wudi-tech/esp32-p4-c5-webrtc-doorbell/output/acrylic/README.md

# Acrylic Backplate Final Production Package V3

## Vendor cutting instructions / 加工说明

- Primary production file: `acrylic_plate_cut_only_v3.dxf`
- Layered engineering file: `acrylic_plate_layered_v3.dxf`
- Units: mm
- Scale: 1:1
- Finished size: 220.00 x 190.00 x 5.00 mm
- Material: transparent clear cast PMMA / 透明浇铸亚克力
- Four external corners: R10.00
- Outline tolerance: +/-0.20 mm
- Hole and cutout tolerance: +/-0.10 mm
- Process: CNC or laser cutting
- Deburr every hole and edge; retain protective film for delivery.
- Do not scale, fit to page, mirror, or manually estimate geometry.
- ALL MACHINING COORDINATES ARE DEFINED FROM FRONT VIEW.
- DO NOT MIRROR CUTTING GEOMETRY.

## Machining summary / 加工特征

- 4x corner-support holes, diameter 3.20 mm.
- 4x mainboard holes, diameter 3.20 mm.
- 2x LD2450 diagonal-notch clamp holes, diameter 2.20 mm.
- 4x rear power-board holes, diameter 2.20 mm.
- 1x rounded rectangular cable pass-through, 32.00 x 18.00 mm, R3.00.
- Camera, 3525 speaker, and MG90S servo have no acrylic cutting holes.

## Assembly notes / 装配说明

- Mainboard: 4x M3, 8 mm brass standoffs, insulating washers.
- Camera: thin double-sided tape; keep CSI flex straight; lens centre approximately
  50 mm below the mainboard edge. Camera dimensions are photo-scale estimates and
  do not control cutting geometry.
- LD2450: 15 x 44 mm vertical, notch end upward, antenna face toward the user;
  clamp at the two official R1.1 diagonal notch centres using M2 standoffs and
  nylon washers with 0.5-0.8 mm overlap.
- 3525 speaker: 4 ohm / 3 W, fixed with 1 mm EVA double-sided tape.
- MG90S: fixed with hot glue; output shaft normal to the plate and facing outward.
- Power board: 4x M2, 10 mm brass standoffs, components facing rear-out.

## Package files

- `acrylic_plate_cut_only_v3.dxf` - authoritative cut-only geometry
- `acrylic_plate_layered_v3.dxf` - CUT/REFERENCE/TEXT/DIMENSION layers
- `acrylic_plate_manufacturing_drawing_v3.pdf` - four-page engineering drawing
- `acrylic_plate_front_assembly_v3.svg` - front assembly reference
- `acrylic_plate_rear_assembly_v3.svg` - rear assembly reference
- `acrylic_plate_hole_table_v3.csv` - machining coordinate table
