wudi-tech/esp32-p4-c5-webrtc-doorbell/docs/code-walkthrough/00_从这里开始_索引.md

# 从这里开始：ESP32-P4+C5 门铃 — 代码结构讲解资料索引

生成时间：2026-09-16  
对应项目：WT99P4C5-S1 本地 WebRTC 智能门铃（ESP-IDF v5.5.5，目标 ESP32-P4）  
资料性质：作者自用的"从 0 讲清代码结构"手册 + 分层技术分析底稿（**只读分析产物，未修改任何源码**）

---

## 一、这个文件夹里有什么

| 文件 | 大小 | 用途 | 建议阅读顺序 |
| --- | --- | --- | --- |
| `10_代码结构从0讲清.md` | 约 90 KB / 1169 行 | **主手册**。分层地图、启动流程、五条核心业务链路、逐模块精读、配置层、测试体系、汇报速查、30 个评委追问答案、9 处代码/文档不一致与安全边界自查清单 | ① 先读这个 |
| `11_代码录屏讲解脚本_20分钟版.md` | 约 39 KB / 439 行 | **20 分钟录屏逐句台词**。10 段分镜，每段含画面动作、逐句台词、评委验收点；附成片验收清单、容易讲错的 12 句对照表、20→10 分钟删减方案、现场问答速答表 | ② 录制前通读 |
| `03_代码录屏讲解脚本.md` | 约 28 KB | 旧版 10 分钟逐句脚本（若赛事时长只允许 10 分钟则用这份；数字已同步为 14 项检查） | 视时长选用 |
| `_analysis/webrtc_layer.md` | 约 52 KB | 底稿：WebRTC 会话层（回调表、信令实现、状态机、锁与并发、端到端时序） | ③ 查细节 |
| `_analysis/media_audio.md` | 约 63 KB | 底稿：媒体系统与音频链路（采集/编码/播放、提示音预解码、板级 ES8311、风险清单） | ③ 查细节 |
| `_analysis/perception_actuator.md` | 约 73 KB | 底稿：LD2450 雷达、视觉检测与跟踪、多模态融合、舵机门锁（含全部阈值常量） | ③ 查细节 |
| `_analysis/signaling_webui.md` | 约 71 KB | 底稿：HTTPS 信令服务、SSE 三条队列语义、POST 协议、中文网页结构与安全边界 | ③ 查细节 |

主手册里的每条结论都能在底稿里找到对应的 `文件:行号` 证据；讲解脚本的行号与主手册使用同一份快照基准（2026-09-16）。

**自动检查现状（2026-09-16 实跑）**：`tests` 目录下 13 个 C 单元测试文件已**全部**被 14 个 `verify_*.py` 入口编译执行，实测 `VERIFY_TOTAL=14 / VERIFY_FAILED=0`。本次新增了两个入口：`verify_pcm_overlay.py`（提示音混音与限幅）与 `verify_pedestrian_filter.py`（整幅满屏框假阳性过滤）。

---

## 二、三件必须先知道的事（详见主手册第 6.4 节、第 13 章）

1. **开门语音在默认构建下大概率不会响。** 提示音混音要求 16000 Hz，而默认通话音频是 G711A 8000 Hz；混音分支和静音兜底线程都不会输出，且函数仍返回 0，串口不报错。实测日志为证：通话中渲染器打开的是 8000 Hz。演示前请先实机复测，或选择一种修法（启用 OPUS / 把 `open.aac` 预处理目标改成 8 kHz）。
2. **没有"中文语音提示"。** 三段提示音是预录 AAC，开门台词是英文 "Doors open, come in please"；中文只存在于网页 UI。
3. **`doorbell_status.c` 与 `PEDESTRIAN_DETECTED` 是未接线/死代码**，网页状态实际来自 SSE 的 `vision_state` / `radar_event`；另外开门命令当前无鉴权、TLS 为示例自签名证书（2028-10-14 到期）。这些属于"可信局域网 Demo"级安全边界，建议主动声明。

---

## 三、资料从哪里来（源项目 + 原件位置）

源项目（提交源码快照）：

```text
D:\Documents\ChatGPT\WebRTC复刻挑战\output\submission\ESP32-P4-C5_WebRTC_Doorbell_2026-09-14\02_项目完整源码\
```

原件（本文件夹是它们的副本，原件仍然存在）：

```text
…\02_项目完整源码\docs\submission\10_代码结构从0讲清.md
…\02_项目完整源码\docs\submission\11_代码录屏讲解脚本_20分钟版.md
…\02_项目完整源码\docs\submission\_analysis\webrtc_layer.md
…\02_项目完整源码\docs\submission\_analysis\media_audio.md
…\02_项目完整源码\docs\submission\_analysis\perception_actuator.md
…\02_项目完整源码\docs\submission\_analysis\signaling_webui.md
```

---

## 四、如何放回项目（可选）

如果希望手册跟着源码一起提交，把两个条目复制回项目的 `docs\submission\` 即可：

```powershell
$src = 'D:\Documents\ChatGPT\WebRTC复刻挑战\output\ESP32-P4-C5门铃_代码结构讲解'
$dst = 'D:\Documents\ChatGPT\WebRTC复刻挑战\output\submission\ESP32-P4-C5_WebRTC_Doorbell_2026-09-14\02_项目完整源码\docs\submission'
Copy-Item (Join-Path $src '10_代码结构从0讲清.md') $dst -Force
Copy-Item (Join-Path $src '11_代码录屏讲解脚本_20分钟版.md') $dst -Force
Copy-Item (Join-Path $src '_analysis') $dst -Recurse -Force
```

同时建议在 `docs\submission\README.md` 的交付清单里保留这三项：

| 编号 | 材料 | 文件/目录 |
| --- | --- | --- |
| 10 | 代码结构自学手册 | `10_代码结构从0讲清.md` |
| 11 | 代码录屏讲解脚本（20 分钟） | `11_代码录屏讲解脚本_20分钟版.md` |
| — | 分层技术分析底稿（4 篇） | `_analysis/*.md` |

> 若不希望提交底稿，只保留 `10_代码结构从0讲清.md` 也完整可用——手册本身已包含全部结论与关键行号。

---

## 五、阅读建议

- **只有 20 分钟**：主手册第 1 章（5 个心智模型）→ 第 3 章（分层地图）→ 第 11.1 节（一分钟总述）→ 第 13 章（自查清单）。
- **准备录讲解视频**：主手册第 5、6 章 + 既有的 `03_代码录屏讲解脚本.md`（那份是逐句台词，本手册是"为什么这样写"）。
- **准备答辩**：主手册第 12 章（30 个追问的答法）+ 第 13 章（主动交代的 9 处不一致与安全边界）。
