wudi-tech/esp32-p4-c5-webrtc-doorbell/docs/submission/README.md

# ESP32-P4+C5 多模态 WebRTC 智能门铃——提交材料索引

版本日期：2026-09-14  
作品状态：主要功能已完成实机验证，进入提交材料制作阶段。

## 交付内容

| 编号 | 材料 | 文件/目录 | 状态 |
| --- | --- | --- | --- |
| 01 | 可完整运行的作品 | 已烧录的 WT99P4C5-S1 实机；发布包中的 P4 固件 | 已完成 |
| 02 | 项目完整源码 | 发布包中的 `source/esp-webrtc-solution` | 已准备 |
| 03 | 开发日志 | `01_开发日志.md` | 已准备 |
| 04 | 使用指南 | `02_使用指南.md` | 已准备 |
| 05 | 代码录屏讲解 | `03_代码录屏讲解脚本.md` | 待参赛者录制 |
| 06 | 横屏项目演示 | `04_项目使用流程演示脚本.md` | 待参赛者录制 |
| 07 | 复刻过程加分视频 | `05_复刻过程加分视频脚本.md` | 可选，建议录制 |
| 08 | 提交前检查 | `06_最终提交检查表.md` | 提交前逐项确认 |
| 09 | 源码完备性审计 | `09_提交源码完备性审计.md` | 已准备 |
| 10 | **代码结构自学手册** | `10_代码结构从0讲清.md` | 已准备（作者自用） |
| 11 | **代码录屏讲解脚本·20 分钟版** | `11_代码录屏讲解脚本_20分钟版.md` | 已准备（替代 03 的逐句加强版） |
| — | 分层技术分析底稿（4 篇） | `_analysis/webrtc_layer.md`、`_analysis/media_audio.md`、`_analysis/perception_actuator.md`、`_analysis/signaling_webui.md` | 已准备（手册的证据底稿） |

> `10_代码结构从0讲清.md` 是写给作者本人的"从 0 理解代码"手册：分层地图、启动流程、五条核心业务链路、逐模块要点、配置层、测试体系、汇报速查、30 个可能被追问的问题，以及**9 处代码/文档不一致与安全边界的自查清单**。建议在录制讲解视频前通读一遍。
>
> `11_代码录屏讲解脚本_20分钟版.md` 是 20 分钟录屏的逐句台词版（10 段分镜、每段含画面动作与评委验收点、末尾附 10 分钟删减方案与"容易讲错的 12 句"对照表）。旧版 10 分钟的 `03_代码录屏讲解脚本.md` 仍保留，可按赛事时长要求选用。

## 作品一句话介绍

本作品在 WT99P4C5-S1（ESP32-P4 + ESP32-C5）开发板上实现了局域网 WebRTC 智能门铃：支持板端摄像头到浏览器实时视频、双向音频、BOOT 实体按键呼叫、浏览器接听/挂断、舵机模拟开锁及语音提示、LD2450 雷达人员接近检测、摄像头人体/人脸存在辅助检测和中文网页状态展示。

## 真实性边界

- 舵机当前用于模拟门锁动作，尚未连接真实门锁机构。
- 摄像头只判断是否有人并显示检测框与置信度，不进行身份识别。
- LD2450 输出最多三个目标的二维坐标、速度和进入/离开事件，不是三维点云雷达。
- 配套显示屏尚未集成到最终门铃 UI，代码保留了未来扩展接口。
- 当前实现面向同一局域网内的单浏览器客户端。

## 建议提交目录命名

```text
ESP32-P4+C5多模态WebRTC智能门铃_最终提交/
├─ 01_可运行固件/
├─ 02_项目完整源码.zip
├─ 03_开发日志.pdf（或 .md）
├─ 04_使用指南.pdf（或 .md）
├─ 05_代码录屏讲解.mp4
├─ 06_项目使用流程演示.mp4
├─ 07_复刻过程记录_加分项.mp4
└─ 08_提交说明与文件校验.txt
```
