wudi-tech/esp32-p4-c5-webrtc-doorbell/docs/superpowers/specs/2026-09-10-hybrid-person-detection-design.md

# ESP32-P4 门铃组合人员检测设计

日期：2026-09-10

目标硬件：WT99P4C5-S1（ESP32-P4）+ OV5647 + HLK-LD2450

实现范围：行人检测、人脸检测、雷达融合、浏览器中文状态与检测框

## 1. 目标

在不进行人脸身份识别的前提下，提高门铃近距离场景中的“是否有人”判断可靠性。系统同时覆盖完整人体和近距离头肩画面，在网页上如实显示检测来源、检测框和模型分数，并继续使用雷达作为自动来电的必要条件。

本设计必须优先保证现有 WebRTC 音视频、门铃响铃、开门和挂断流程不被 AI 推理阻塞。

## 2. 非目标与未来扩展

本轮不实现：

- 人脸身份注册、特征提取、身份比对或人脸数据库；
- 人脸照片或特征的持久化存储；
- 独立的上半身专用模型；
- 配套显示屏初始化和界面；
- 雷达目标与视频目标的一一空间标定；
- 将模型分数解释为真实世界概率。

未来可在统一视觉结果接口后增加人脸身份识别。显示屏可订阅统一门铃状态接口，不直接依赖浏览器页面或 WebRTC 信令。

## 3. 总体架构

保留现有 320×180 RGB565、2 FPS 的独立检测支路。检测支路只消费最新画面，不能阻塞主视频采集。

检测链路由以下独立单元组成：

1. **画面采集与格式确认**：沿用现有检测 sink、缓存同步和像素格式探测。
2. **运动唤醒**：画面运动只用于调度 AI，不能作为“有人”的正证据。
3. **行人检测适配器**：包装现有 `PedestrianDetect`，输出统一视觉候选。
4. **人脸检测适配器**：使用支持 ESP32-P4 的 `HumanFaceDetect`，输出统一视觉候选。
5. **视觉轨迹过滤器**：按检测类型维护短期轨迹、分数、框位置、命中与丢失次数。
6. **视觉状态融合器**：将已确认的行人或人脸候选转换为“摄像头确认有人”。
7. **多模态融合器**：只有雷达门前区域存在符合条件的目标且视觉已确认时，才允许自动来电。
8. **遥测与网页覆盖层**：实时状态覆盖更新，状态转变才写入事件历史。

通话、门锁、音频和 BOOT 手动来电逻辑保持独立。AI 模块异常不能导致这些基础功能退出。

## 4. 统一视觉结果

每个视觉目标至少包含：

- 临时轨迹编号；
- 类型：`pedestrian` 或 `face`；
- 原始模型分数，范围 0.0 至 1.0；
- 检测框左上角、宽度和高度；
- 原始检测画面宽高；
- 候选或已确认状态；
- 单调时间戳；
- 连续命中和连续丢失计数。

轨迹编号只在当前运行和短期跟踪中有效，不表示人员身份。系统最多向网页报告三个视觉目标。

行人框包含人脸框时，两个框可以同时显示，但综合人员数量只计算一个。仅靠现有摄像头和 LD2450 不建立雷达目标与视频框的一一对应关系。

## 5. 模型调度

默认采用“行人优先、人脸补充”的级联策略：

1. 每个检测帧先运行行人模型。
2. 行人模型得到可靠结果时，本帧可跳过人脸模型。
3. 行人模型无结果、分数不足或框不合理时，在同一帧运行人脸模型。
4. 雷达已在门前区域发现目标时，允许同帧运行两个模型，以缩短近距离确认时间。
5. AI 任务优先级低于 WebRTC 音频、视频编码和网络任务。
6. 推理赶不上输入时丢弃旧帧，只处理最新帧。
7. 通话期间若连续三次单帧 AI 处理耗时超过 450 ms，或五秒内发生两次检测帧覆盖，检测频率从 2 FPS 降为 1 FPS；连续三十次处理耗时低于 350 ms 且没有检测帧覆盖后恢复到 2 FPS。
8. 模型对象和主要工作缓冲区在启动阶段分配，避免通话中频繁分配大块内存。

初始运行参数：

- 行人最低候选分数：0.70；
- 人脸最低候选分数：0.75；
- 视觉确认：最近四次对应模型结果中至少三次有效；
- 视觉取消：连续三次未检测到；
- 雷达与视觉有效重叠保持时间：2000 ms；
- 浏览器视觉状态过期时间：3000 ms。

这些是首版可配置参数。实机调优只改变参数，不改变数据流和模块边界。

## 6. 视觉确认与多模态融合

行人或人脸达到连续帧规则后，视觉状态变为“已确认有人”。单帧高分结果仍然只是候选。

自动来电条件为：

1. LD2450 已确认目标进入门前区域；
2. 本次访问具备响铃资格且未响铃；
3. 行人检测或人脸检测已确认；
4. 视觉结果仍在 2000 ms 有效期内。

运动检测不能直接调用人员确认回调。雷达没有目标时，即使摄像头误把照片识别为人脸，也不能自动来电。

雷达确认人员离开后，清除本次访问的融合资格、视觉保持状态和已响铃标记。雷达短暂丢帧不能立刻清除已确认视觉结果。

## 7. 模型分数的含义

网页将模型返回的 0.86 显示为“人脸 86%”。它只表示当前检测框与该模型训练目标的匹配分数，不表示：

- 门外真实存在人员的概率；
- 人体出现在画面中的比例；
- 身份识别准确率；
- 雷达与摄像头的综合概率。

行人分数和人脸分数来自不同模型，不进行简单平均。综合状态通过确定性的规则表达为“候选”“已确认”或“未确认”。

“近距离”由雷达距离表示，不由人脸模型推断。因此界面使用“人脸 86%”，不使用“近距离人员 86%”。

## 8. 浏览器界面与事件语义

远端视频上叠加透明绘制层：

- 绿色实线：已确认行人；
- 黄色实线：已确认人脸；
- 灰色虚线：尚未确认的候选；
- 标签显示“行人 81%”或“人脸 86%”。

覆盖层根据原始检测画面宽高、视频实际显示区域和 `object-fit` 留白计算坐标。窗口缩放、全屏和移动端方向变化不能导致检测框明显偏移。

中文实时状态区域至少显示：

- 人员状态；
- 视觉依据和模型分数；
- 连续确认状态；
- 雷达是否存在门前目标及其距离；
- 行人和人脸模型运行状态；
- 正常、降级或不可用状态。

设备通过独立 `vision_state` JSON 消息发送最新状态。消息包含时间戳、检测画面尺寸、目标数组和两个模型状态。实时状态只覆盖上一状态，不增加历史事件数量。

只有状态转变才写入传感器事件历史，例如“摄像头确认有人”“综合确认门前有人”“人员离开”。同一目标持续存在时不得按检测帧重复累加。

浏览器 SSE 重连后应获得最新快照，不重复写入历史事件。超过 3000 ms 没有视觉更新时，页面清除旧框并显示“视觉检测数据暂停”。所有动态文字使用安全文本赋值，不把设备数据作为 HTML 执行。

## 9. 故障降级

- 人脸模型加载失败：继续运行雷达和行人检测，报告“人脸检测不可用”。
- 行人模型加载失败：继续运行雷达和人脸检测，报告“行人检测不可用”。
- 两个模型均失败：WebRTC、雷达显示、门锁和 BOOT 手动来电继续工作；自动视觉融合来电停用。
- AI 队列满：丢弃最旧检测帧，不等待、不阻塞视频采集。
- 浏览器遥测队列满：实时视觉状态采用最新值覆盖，不能挤占控制和语义事件。
- 内存不足、模型初始化失败和推理异常：记录明确串口日志并更新网页降级状态。

系统不得用画面运动结果代替失败的 AI 模型。

## 10. 未来扩展边界

### 人脸身份识别

未来摄像头升级后，可在已确认人脸框之后增加身份模块。身份模块只消费裁剪的人脸区域，并通过可选字段报告 `identity_state`、`identity_name` 和 `identity_score`。当前版本不创建这些数据，也不持久化图像。

### 配套显示屏

主程序提供与输出设备无关的门铃状态快照，包含待机、检测到人员、正在呼叫、通话中、门已打开、AI 异常和网络断开。未来显示屏模块只订阅此状态，不直接读取 WebRTC 页面逻辑或传感器内部状态。本轮不初始化屏幕，也不分配显示帧缓冲。

## 11. 测试与验收

### 自动测试

必须覆盖：

1. 统一视觉结果和 JSON 序列化；
2. 四次中三次确认、连续三次丢失和 2000 ms 有效期；
3. 低分、越界、全屏框和不稳定框不会确认；
4. 行人框包含人脸框时只计算一个目标；
5. 单模型失败和双模型失败的降级行为；
6. 实时状态不会增加事件历史；
7. SSE 重连和视觉状态过期；
8. 检测框坐标缩放及留白修正；
9. 中文 JSON 和页面脚本检查；
10. ESP32-P4 完整固件构建。

### 实机验收

- 门前无人连续五分钟，不得确认有人或自动响铃。
- 完整人体进入门前区域后约 2.5 秒内确认。
- 近距离只露出脸和肩膀时，约 2.5 秒内显示人脸框并确认。
- 背对摄像头且身体可见时，应由行人模型确认。
- 摄像头看到照片或屏幕、雷达没有目标时，不得自动来电。
- 检测框不能长期停留在墙壁或空白区域。
- 浏览器刷新后三秒内恢复当前传感器状态。
- 连续三轮呼叫、接听、开门和挂断不能因 AI 出现音频断续、长期黑屏或无法挂断。
- 保持至少十五分钟通话，不得出现内存耗尽、看门狗复位或 AI 线程崩溃。
- 串口日志能够区分模型初始化、模型降级、候选、确认和取消确认。

## 12. 烧录与交付

自动测试和 ESP32-P4 构建通过后，使用 COM5 烧录。烧录成功后采集启动日志，确认 Wi-Fi、HTTPS/WebRTC、摄像头、雷达、行人模型和人脸模型初始化状态。若自动复位无法进入下载模式，交付记录必须明确说明需要按住 BOOT、短按 RST 后重新烧录。
