wudi-tech/esp32-p4-c5-webrtc-doorbell/docs/PROJECT_STATUS.md

# 项目状态与证据边界

整理日期：2026-10-24。此文件是公开仓库的现状说明；原始开发日志、录屏脚本和源码审计作为历史材料保留。

## 本次确认了什么

- 两份展开的最终源码目录逐文件 SHA-256 一致，各含 487 个文件。公开仓库保留一份，并用 [来源清单](source-snapshot-manifest.csv) 逐项追踪迁移和文档修订。
- 生产代码、测试代码、本地组件、七个 Peer 预编译 `.a` 库、AAC、网页和证书完整保留；本次未更改应用行为。
- 14 个 `verify_*.py` 在 Windows 主机重新执行，全部返回成功；17 个 CAD 测试通过。见 [验证记录](VALIDATION.md)。
- 两个实际视频文件已经存在，旧目录名中的“待录制”不能代表当前附件不存在。视频作为原始演示材料发布，本次未逐段复核全部画面和台词。
- 已有固件文件存在，但本次没有从当前源码重新构建、烧录或连接设备。历史烧录/运行日志只能证明各自记录时的版本。

## 必须保留的限制

| 项目 | 当前判断与依据 |
| --- | --- |
| 通话中开门提示音 | `media_sys.c` 默认 G.711A 为 8000 Hz；`doorbell_audio_render.c` 的混音路径要求 16000 Hz。存在采样率兼容问题，不能承诺默认通话中提示音必响；本次没有修复或实机复测。 |
| 中文语音 | 网页为中文；AAC 是既有预录音频，不能将中文界面表述为中文语音识别或中文播报系统。 |
| `doorbell_status` | 模块纳入构建且有单元测试，但未找到生产调用方。旧审计将其描述为统一在线状态的结论过宽。 |
| `PEDESTRIAN_DETECTED` | 存在历史处理代码，不能据此认定当前网页状态全部由该命令驱动；当前视觉/雷达事件路径另行更新状态。 |
| 雷达轨迹图 | HTML 有视觉框画布，没有实现雷达俯视轨迹图。旧材料中关于雷达俯视图的表述不能作为已完成功能。 |
| 依赖锁定 | 源码没有 `dependencies.lock`。清单固定了 `esp_hosted 2.12.12` 与 `esp_wifi_remote 1.6.3`，其他依赖含版本范围。使用指南已修正“包含锁定文件”的错误；归档原文仍保留历史说法。 |
| 固件与源码对应 | 历史文件记载过 `0x68fd20`、`0x693440` 等不同镜像大小。已归档应用实际为 6,894,656 字节。未重建验证其与当前源码逐字节一致，不将多份历史构建记录合并为同一次构建。 |
| 呼叫时间 | 日志记录优化后三轮约 4/6/4 秒；不是本次复测，也不是分位数、长期稳定性或公网指标。 |
| 安全边界 | 使用与上游公开样例一致的 HTTPS 演示密钥；没有用户级开门鉴权。不能用于真实门禁部署。 |
| 物理边界 | 局域网单客户端；舵机为空载门锁模拟，无真实锁舌反馈；雷达提供二维目标数据；人脸仅为存在证据；配套屏幕未接入。 |

## 继续深化的方向

1. 统一音频采样率与提示音输出策略，并实机回归接听、通话中开门、挂断和再次呼叫。
2. 统一实际业务状态模型，清理或接入未使用的状态模块，再同步审计文档。
3. 在重新确认的构建环境中保存可移植的依赖版本记录，建立源码提交与固件校验值的对应。
4. 采集多轮重连、呼叫延迟、误触发率与连续运行数据；真实锁体和鉴权属于后续独立工作。

本次范围是项目归档、说明、验证与发布，上述方向未在此次整理中实施。
