wudi-tech/esp32-p4-c5-webrtc-doorbell/docs/PROVENANCE.md

# 来源、整理范围与去重说明

本仓库由项目的最终提交快照、外围结构设计与硬件资料整理而成。原本地工作目录保持不变，公开仓库在独立目录建立，不携带工作目录的 Git 历史或私人配置。

## 内容来源

| 本地材料类别 | 公开位置与处理 |
| --- | --- |
| 2026-09-14 提交目录下的 `02_项目完整源码` | 作为根目录代码基线；快照导出说明日期为 2026-09-16 |
| `Let's GOooO/02_项目完整源码` | 487 个文件与基线完全一致，不重复复制 |
| 原源码根 README | 保留为根目录 `README.upstream.md`，原相对链接仍可解析 |
| 原 `.github` / `.gitlab` / `.vscode` | 放入 `docs/archive/upstream-tooling`，避免触发上游组件发布流程；内容保留 |
| 本地 `cad/acrylic_plate` | 原样保留生成程序、布局和测试；包含当前未提交到原工作目录 Git 的版本 |
| 本地 `output/acrylic`、`output/pdf` | 保留 V1/V2/V3 图纸和加工包；测试复跑重新生成 V3 交付文件 |
| 根目录四份硬件 PDF | 放入 `hardware/reference` |
| 原外层提交指南、日志、清单与录制脚本 | 放入 `docs/archive/submission-2026-09-14` |
| 单独代码讲解目录 | 放入 `docs/code-walkthrough`，避免丢失与快照不同的索引和修订 |
| P4 公开固件 | 展开在 `firmware/2026-09-14`，另提供 Release ZIP |
| 实际项目演示与代码讲解视频 | 发布为两个 Release MP4；重复的演示视频只保留一份 |

完整源码内的应用程序与组件代码未改动。整理改动包括新总览/导航/现状说明、使用指南中的锁定文件错误修正、历史日志网络信息脱敏、上游自动发布配置迁移。每个原源码文件见 [来源清单](source-snapshot-manifest.csv)。

## 不上传的内容

- 招新签到表、人员名单、相关预览及其处理脚本：与门铃项目无关，包含个人数据。
- `node_modules`、缓存、临时目录、工作树、编辑器运行状态、本机 Git 历史：不属于项目交付内容。
- 第三方参考示例视频与模板：属于复刻过程中的外部参考，不作为本人的作品发布。
- 两个旧源码/全量提交 ZIP：展开内容已在代码、文档、固件和 Release 视频中归档，避免重复存储与旧版本说明混淆。没有从大 ZIP 再引入未经检查的内容。
- 私有 `settings.local.h`、本机构建目录、`sdkconfig`、`managed_components`、含本机路径的依赖锁定文件：按源码快照原有边界排除。

本次未遍历采集整个电脑的开发目录；归档范围为此项目工作目录内已经存在的交付快照和配套材料。

## 历史说明的读法

历史材料保留原始日期、旧目录名、当时测试状态、字节大小和绝对路径等上下文。有些叙述互相矛盾或已被后续代码分析纠正；不能把“参与编译”“单元测试通过”“历史实机确认”合并成当前全系统验收。公开总览与 [PROJECT_STATUS.md](PROJECT_STATUS.md) 已列明重要差异。

## 发布组织

代码、文档、图纸、硬件 PDF、小型库与固件进入 Git；大型 MP4 放在 Release。标签 `archive-2026-10-24` 表示此次资料归档，不表示在当天完成了新的硬件版本或性能测试。
