wudi-tech/esp32-p4-c5-webrtc-doorbell/docs/submission/03_代码录屏讲解脚本.md

# 代码录屏讲解脚本（10 分钟上限·逐句逐行版）

作者：吴迪  
建议成片：9 分 35 秒～9 分 55 秒  
硬性上限：10 分钟

## 一、录制目标

这份脚本可以直接照读。每一段都写明了应打开的文件、准确行号、画面动作、输入、处理、输出和上下游关系。代码发生改动时，优先用函数名定位；本稿行号对应 2026-09-16 提交版本。

录制时不要打开 `settings.local.h`，不要显示真实 Wi-Fi 名称、密码、私人目录或终端历史。编辑器开启行号，字号 18～20 px，使用 `Ctrl+G` 跳转行号，避免现场快速滚动。

## 二、录制前标签页和书签

按以下顺序预先打开：

1. `solutions/doorbell_local/main/CMakeLists.txt`
2. `solutions/doorbell_local/main/idf_component.yml`
3. `solutions/doorbell_local/main/settings.h`
4. `components/codec_board/board_cfg.txt`
5. `solutions/doorbell_local/sdkconfig.defaults.esp32p4`
6. `solutions/doorbell_local/main/main.c`
7. `solutions/doorbell_local/main/webrtc.c`
8. `solutions/doorbell_local/main/webrtc_http_server.c`
9. `solutions/doorbell_local/main/door_lock.h`
10. `solutions/doorbell_local/main/door_lock.c`
11. `solutions/doorbell_local/main/doorbell_audio_render.c`
12. `solutions/doorbell_local/main/pcm_overlay.c`
13. `solutions/doorbell_local/main/radar_ld2450.h`
14. `solutions/doorbell_local/main/radar_ld2450.c`
15. `solutions/doorbell_local/main/presence_fusion.c`
16. `solutions/doorbell_local/main/pedestrain_detect.cpp`
17. `solutions/doorbell_local/main/vision_tracker.c`
18. `solutions/doorbell_local/main/vision_event.c`
19. `solutions/doorbell_local/main/multimodal_fusion.c`
20. `solutions/doorbell_local/main/webrtc_test.html`
21. `solutions/doorbell_local/tests` 目录

建议书签：

| 书签 | 文件与精确定位 |
| --- | --- |
| A | `main/CMakeLists.txt:2-16` |
| B | `main/settings.h:21-44` |
| C | `components/codec_board/board_cfg.txt:81-95` |
| D | `sdkconfig.defaults.esp32p4:3-46` |
| E | `main.c:435-478`，`app_main()` |
| F | `main.c:361-409`，线程调度 |
| G | `webrtc.c:1091-1125`，BOOT 监测 |
| H | `webrtc.c:333-405`，统一来电入口 |
| I | `webrtc_http_server.c:178-210`，SSE 会话 |
| J | `webrtc.c:1171-1407`，WebRTC 启动 |
| K | `webrtc.c:557-619`，浏览器命令 |
| L | `door_lock.c:84-125`，舵机任务 |
| M | `doorbell_audio_render.c:147-175`，通话混音入口 |
| N | `radar_ld2450.c:29-123`，协议解析 |
| O | `presence_fusion.c:68-150`，雷达状态机 |
| P | `pedestrain_detect.cpp:66-228`，AI 推理任务 |
| Q | `vision_tracker.c:214-280`，连续帧追踪 |
| R | `multimodal_fusion.c:24-81`，融合条件 |
| S | `webrtc_test.html:927-1007`，SSE 信令 |

## 三、正式录屏台词与画面

## 0:00～0:35　项目来源、构建入口和新增模块

**打开文件：** `solutions/doorbell_local/main/CMakeLists.txt`

**定位：** 第 2～16 行。

**画面怎么做：**

1. 先让左侧目录同时看到 `components`、`solutions`、`docs`，停 3 秒。
2. 打开文件，框选第 2～7 行。
3. 再框选第 9～16 行。

**我说：**

> 大家好，我是吴迪。本项目基于 Espressif 本地 WebRTC 门铃例程，适配 WT99P4C5-S1，也就是 P4 主控加 C5 Wi-Fi。第 2 到第 7 行登记舵机、雷达、音频和视觉模块；第 9 到第 16 行加入人员检测，并嵌入网页、AAC 和 HTTPS 证书。所有功能进入同一个 P4 固件。

**输入：** 源文件列表、功能开关和嵌入资源。  
**处理：** ESP-IDF 根据 CMake 生成编译目标。  
**输出：** 一个包含 WebRTC、传感器、舵机、网页和提示音的固件。  
**上下游：** CMake 是构建入口；后面所有运行模块都依赖这里被正确登记。  
**超时可删：** “不是独立网页加几个脚本”这一句。

## 0:35～1:20　板型、音视频、AI 与 P4+C5 配置

**依次打开：**

1. `main/settings.h:21-44`、`52-61`、`68-76`
2. `components/codec_board/board_cfg.txt:81-95`
3. `sdkconfig.defaults.esp32p4:3-46`
4. `main/idf_component.yml:7-33`

**画面怎么做：**

- 在 `settings.h` 框选板名、640×480@15 FPS、320×180@2 FPS 和 GPIO35。
- 在 `board_cfg.txt` 框选 WT99P4C5-S1 的 I2C、I2S、ES8311 与 PA53。
- 在 P4 默认配置中框选 16 MB Flash、P4 v1.x、OV5647、C5 SDIO 与 Wi-Fi 缓冲参数。
- 最后在依赖清单中框选行人、人脸存在、`esp_hosted 2.12.12` 和 `esp_wifi_remote 1.6.3`。

**我说：**

> `settings.h` 第 21 到第 44 行选择本板：通话视频 640×480、15 帧，AI 支路 320×180、2 帧，避免推理阻塞通话。第 52 到第 61 行隔离本地 Wi-Fi 密码；第 76 行定义 BOOT 为 GPIO35。板级文件匹配 ES8311、I2S 和功放。P4 默认配置锁定 16 MB Flash、OV5647 和 C5 SDIO；依赖清单锁定已验证的 P4+C5 传输版本，保证干净构建一致。

**输入：** 主板型号、摄像头规格、音频引脚、C5 通信方式。  
**处理：** 编译期宏和板级表把通用例程映射到实际硬件。  
**输出：** P4 负责音视频和 AI，C5 通过 SDIO 提供 Wi-Fi。  
**上下游：** `settings.h` 被 `main.c` 和 `webrtc.c` 读取；板级表被 `codec_board` 读取；组件清单决定外部库版本。  
**超时可删：** 不逐个念 I2S 引脚，只保留“匹配 ES8311 音频链路”。

## 1:20～2:00　系统入口和任务资源分配

**打开文件：** `solutions/doorbell_local/main/main.c`

**定位：** `app_main()` 第 435～478 行；`thread_scheduler()` 第 361～409 行。

**画面怎么做：**

1. 框选 435～445 行。
2. 框选 446～474 行。
3. 跳到 361 行，框选 378～390 行。

**我说：**

> 程序从 `app_main` 进入。第 438 到第 445 行注册媒体适配、线程调度、主板和 WebRTC 同步；第 446 到第 470 行初始化多模态融合、舵机和 LD2450；第 472 到第 474 行启动媒体、控制台和 Wi-Fi。网络回调只有拿到 IP 后才调用 `start_webrtc`。调度器第 380 到第 382 行给 AI 线程 24 KB 栈并降低优先级，避免栈溢出导致网页卡顿、BOOT 失效或重启。

**输入：** 各模块初始化函数和网络连接事件。  
**处理：** `app_main()` 按依赖顺序装配模块；调度器分配栈、优先级和核心。  
**输出：** 一个已联网、能接收按键和传感器事件的长期运行系统。  
**上下游：** `app_main → network_init → network_event_handler → start_webrtc`。  
**超时可删：** 不解释 `pc_task` 的核心绑定。

## 2:00～3:10　BOOT 来电、统一来电入口和 SSE 刷新恢复

**依次打开：**

1. `webrtc.c:1091-1125`
2. `webrtc.c:333-405`
3. `webrtc.c:290-330`
4. `webrtc_http_server.c:158-210`
5. `webrtc_http_server.c:273-343`

**画面怎么做：**

- 框选 `webrtc.c:1101-1121`，显示 50 ms 轮询和电平变化。
- 跳到 `333-405`，依次框选 354～365、373～396。
- 框选 `290-310` 的定时停止铃声逻辑。
- 切到 HTTP 文件，框选 158～190 的心跳和旧 SSE 替换。
- 最后框选 273～343 的消息分类。

**我说：**

> BOOT 来电从 `key_monitor_thread` 开始：记录启动电平后每 50 毫秒检查，变化时进入统一的 `doorbell_request_ring`。第 354 到第 365 行在锁内判断就绪状态并预留 `RINGING`，防止 BOOT、雷达和命令重复触发；之后发送 RING、播放板端铃声并安排网页停止铃声。板到网页走 SSE，第 158 到第 190 行负责心跳，并让刷新后的页面替换旧会话，修复第一次 BOOT 丢来电。网页到板走 POST，第 273 到第 343 行接收 WebRTC 信令和自定义命令。

**输入：** GPIO35 电平、传感器来电请求或浏览器请求。  
**处理：** 状态锁防重入；SSE 向下发送；POST 向上接收；心跳检测失效连接。  
**输出：** 网页收到 RING 并播放铃声，超时或接听后停止。  
**上下游：** `BOOT → key_monitor_thread → doorbell_request_ring → SEND_CMD(RING) → SSE → 网页`。  
**超时可删：** POST 的五种消息名称可概括为“信令和自定义命令”。

## 3:10～4:20　WebRTC 建立、接听、挂断与后续通话加速

**依次打开：**

1. `webrtc.c:1171-1272`
2. `webrtc.c:1273-1407`
3. `webrtc.c:557-619`
4. `webrtc.c:1052-1082`
5. `webrtc.c:1423-1475`

**画面怎么做：**

- 在 `start_webrtc()` 框选 1175～1213 的互斥和旧实例清理。
- 框选 1215～1255 的音视频方向和 HTTP 信令。
- 框选 1264～1272 的媒体提供器及 `no_auto_capture`。
- 框选 1303～1327 的 AI 支路，及 1331～1400 的启动顺序。
- 切到命令处理，框选 586～619 的接听和挂断。
- 最后展示事件处理 1052～1082 和停止函数 1423～1475。

**我说：**

> `start_webrtc` 是通话主入口。第 1175 到第 1213 行检查网络、锁定生命周期并清理旧句柄，避免留下第二套连接。第 1215 到第 1255 行配置双向音频、板端单向 H.264 视频和本地信令。第 1269 到第 1272 行保持摄像头采集常驻，不在每次挂断后重建，所以后续通话也能快速出画面。第 1303 到第 1327 行建立低分辨率 AI 支路。浏览器的接听和挂断在第 586 到第 619 行异步启停 PeerConnection；事件处理更新连接状态，停止函数再清除工作线程、检测任务和通道，避免“显示已挂断但视频仍在播放”。

**输入：** 网络就绪、网页接听/挂断命令、SDP/ICE。  
**处理：** 创建或销毁 PeerConnection，配置 H.264 和双向音频，维护唯一 WebRTC 句柄。  
**输出：** 浏览器获得板载视频与通话音频；挂断后资源真正释放。  
**上下游：** `ACCEPT_CALL → POST → door_bell_on_cmd → enable peer → SDP/ICE → ontrack`；挂断方向相反。  
**超时可删：** 不讲数据通道三个回调名称。

## 4:20～5:15　舵机状态机和通话中开门语音

**依次打开：**

1. `door_lock.h:10-22`
2. `door_lock.c:36-59`、`84-125`、`128-190`、`201-230`
3. `webrtc.c:574-585`
4. `doorbell_audio_render.c:147-175`、`252-285`
5. `pcm_overlay.c:61-95`

**画面怎么做：**

- 先框选 GPIO32、50 Hz、500/2500 微秒和 5000 ms。
- 切到舵机任务，框选打开、保持、复位三段。
- 切到命令处理，显示通话中和非通话的不同播音路径。
- 最后框选混音调用和 16 位限幅。

**我说：**

> 舵机接口第 10 到第 15 行定义 GPIO32、50 赫兹、两个位置脉宽和 5 秒保持。开门请求只写入队列，独立任务第 103 到第 124 行执行开启、保持和复位，重复点击不会叠加。`webrtc.c` 第 574 到第 585 行区分通话内外的提示路径；通话中，PCM 在第 158 行进入叠加器，再逐声道相加并做 16 位限幅。因此开门播报能和远端声音同时输出，不再等到挂断后播放。

**输入：** 网页 `OPEN_DOOR` 命令和开门语音 PCM。  
**处理：** 舵机队列异步执行；PCM 与远端音频逐样本混合并限幅。  
**输出：** 舵机完成开门—保持—复位；通话不断且能听到提示。  
**上下游：** `OPEN_DOOR → door_lock_request_open → door_lock_task`；同时 `prompt_start → prompt_render_write → pcm_overlay → ES8311`。  
**超时可删：** 不解释占空比换算函数。

## 5:15～6:25　LD2450 协议、坐标、区域和去抖

**依次打开：**

1. `radar_ld2450.h:11-38`、`22-24`
2. `radar_ld2450.c:29-123`
3. `radar_ld2450.c:168-240`
4. `presence_fusion.c:5-54`
5. `presence_fusion.c:68-150`
6. `main.c:141-213`

**画面怎么做：**

- 框选三目标、30 字节帧、GPIO4/5、256000 波特率。
- 在解析器框选 35～43 的长度/帧头/帧尾检查和 61～68 的 X、Y、速度解析。
- 在流解析器框选 92～121，说明能从任意 UART 分片重新同步。
- 在区域状态机框选 5～12 和 105～141。
- 在 `main.c` 框选 179～206 的 JSON 发布和融合输入。

**我说：**

> LD2450 每帧最多输出三个二维目标，不是点云。头文件定义 30 字节帧、256000 波特率、GPIO4 接收和 GPIO5 发送。解析器先校验长度、帧头和帧尾，再解出横向 X、前向 Y 与速度；流解码器能处理半帧和噪声并重新同步。门前区域是 X 正负 1500、Y 300 到 3000 毫米：进入 1 秒确认，离开 2 秒清除，再冷却 10 秒。第 105 到第 141 行形成四阶段状态，`main.c` 再发布中文事件。

**输入：** LD2450 UART 原始字节流。  
**处理：** 帧同步、坐标解析、区域过滤、进入/离开去抖、冷却。  
**输出：** 稳定的雷达进入/离开事件及 X、Y、速度。  
**上下游：** `UART → radar_uart_task → stream_feed → parse_frame → radar_frame_received → presence_fusion`。  
**超时可删：** 不解释 `distance_resolution_mm`。

## 6:25～7:50　摄像头模型、置信度、人体框和连续帧确认

**依次打开：**

1. `pedestrain_detect.cpp:66-228`
2. `pedestrian_filter.c:7-18`、`36-55`、`92-121`
3. `vision_tracker.c:6-18`、`164-200`、`214-280`
4. `vision_event.c:52-106`
5. `main.c:86-128`

**画面怎么做：**

- 在 C++ 检测任务框选 69～94、102～159、162～180 和 200～220。
- 切到追踪器先框选参数，再框选 229～279。
- 切到 JSON 文件框选 61～100。
- 最后在 `main.c` 框选 97～127 的证据选择。

**我说：**

> 摄像头只判断是否有人，不做人脸身份识别。检测任务第 69、70 行创建行人和人脸存在模型；第 102 到第 108 行读取 320×180 的 RGB565 小端帧。行人结果在第 115 到第 141 行检查分数、边界和面积；雷达关注门前或没有可信行人框时，第 143 到第 159 行再运行近距离人脸存在模型。页面显示 86%，只表示该框的类别置信分数约 0.86，不是身份或系统总体准确率。追踪器第 9 到第 17 行要求行人至少 0.70、人脸至少 0.75，4 帧命中 3 帧才确认，连续丢失 3 帧才清除。第 229 到第 279 行关联旧轨迹并避免人体框内的人脸重复计数；`vision_event` 输出轨迹号、类型、分数和框坐标。推理持续过慢时还会自动降到 1 FPS，保护通话。

**输入：** OV5647 的 RGB565LE 低分辨率帧。  
**处理：** 行人/人脸存在推理、空间合理性过滤、跨帧关联与确认、性能降级。  
**输出：** 稳定人体框、置信度、确认人数和视觉存在证据。  
**上下游：** `detect sink → filter_task → detecting_task → ESP-DL → vision_tracker → vision_event → SSE/网页`。  
**超时可删：** 不讲 450/350 毫秒恢复阈值，只说“推理慢时自动降帧”。

## 7:50～8:35　雷达与视觉多模态触发

**打开文件：**

1. `multimodal_fusion.c:5-81`
2. `main.c:46-128`、`198-207`

**画面怎么做：**

- 框选 `multimodal_fusion.c:24-38`。
- 再框选 41～60 和 69～81。
- 切到 `main.c` 框选 112～128、198～207。

**我说：**

> 单独雷达可能看到旁边物体，单独摄像头也可能误报，所以自动来电采用双证据。融合器第 24 到第 38 行要求雷达仍在门前区域、该次进入允许响铃、本次来访没有响过，而且两秒内有视觉证据。第 41 到第 60 行处理雷达进入和离开，第 69 到第 81 行接收行人或人脸存在证据。`main.c` 把两路数据送进同一融合器，只有返回 true 才进入统一来电入口；同一来访只响一次，离开后才允许下一次触发。

**输入：** 雷达在区状态、是否允许响铃、视觉证据及时间戳。  
**处理：** 两秒证据窗口、来访生命周期和一次性触发锁。  
**输出：** `radar+vision` 来电请求。  
**上下游：** 雷达和摄像头两条链路在 `multimodal_fusion` 汇合，再进入 `doorbell_request_ring()`。  
**超时可删：** 不逐条念四个布尔变量，但必须说清“双证据、两秒、一次来访只响一次”。

## 8:35～9:30　中文网页、检测事件、画框与挂断确认

**打开文件：** `solutions/doorbell_local/main/webrtc_test.html`

**定位：**

- 第 410～482 行：中文页面、按钮、事件区。
- 第 592～779 行：历史事件、雷达文字、视觉框和置信度。
- 第 803～890 行：接听、开门、挂断与媒体清理。
- 第 927～1007 行：SSE 创建、消息路由和重连。
- 第 1010～1082 行：自定义命令处理。
- 第 1139～1223 行：PeerConnection 与断线宽限。

**画面怎么做：**

- 先框选 410～482 的中文界面。
- 跳到 647～755，显示雷达事件和视觉框。
- 跳到 824～890，显示挂断等待确认和 `finalizeHangup()`。
- 跳到 927～1007，显示 EventSource 重连。
- 最后框选 PeerConnection 状态处理。

**我说：**

> 网页由固件直接提供。第 410 到第 482 行定义中文视频区和按钮。检测事件是有限历史，不是实时人数；第 647 到第 750 行显示雷达 X、Y、速度，并按视频比例绘制人体框和置信度，当前没有俯视轨迹。第 927 行创建 EventSource，接收状态并在出错后重连；按钮通过 POST 发命令，媒体走 WebRTC。挂断要等待板端 `CALL_ENDED`，随后才关闭连接、麦克风并清空视频；短暂断线有 15 秒宽限，避免 Wi-Fi 抖动误挂断。

**输入：** SSE 状态、用户按钮、WebRTC 音视频轨道。  
**处理：** 中文翻译、事件历史、框坐标映射、重连、挂断确认和断线宽限。  
**输出：** 中文可操作页面、板载视频、检测框和可靠的通话状态。  
**上下游：** `板端事件 → SSE → UI`；`网页按钮 → POST → door_bell_on_cmd`；`WebRTC track → remoteVideo`。  
**超时可删：** 不讲 CSS 和颜色，只说框会按原始检测尺寸映射。

## 9:30～10:00　测试、构建结果和边界总结

**画面怎么做：**

1. 展开 `solutions/doorbell_local/tests`，停 5 秒。
2. 切到提前准备好的终端结果：`VERIFY_TOTAL=14`、`VERIFY_FAILED=0`。
3. 再显示构建最后几行：`Project build complete`、固件大小和 18% 余量。
4. 最后回到项目目录或中文网页。

**我说：**

> 最后，14 个自动检查全部通过，覆盖板级配置、雷达、舵机、音频混音、行人过滤、视觉、融合和网页，并且把 13 个 C 单元测试全部编译执行了一遍。空目录构建完成 1850 步，固件约 6.56 MiB，分区剩余 18%。当前已实现 WebRTC 通话、BOOT 来电、舵机模拟开门、雷达坐标、人员存在和双传感器来电；人脸身份识别、真实门锁反馈、屏幕交互和雷达俯视轨迹是后续扩展。谢谢观看。

**输入：** 自动检查结果和干净构建结果。  
**处理：** 用重复验证证明代码入口、配置和模块关系完整。  
**输出：** 清楚区分“已经实现”和“未来扩展”。  
**超时可删：** 测试类别可缩成“14 项自动检查全部通过”，但不能删除产品边界。

## 四、详细代码结构

## 4.1 目录结构

```text
wt99-webrtc-native/
├── components/
│   ├── codec_board/                 主板、音频、摄像头和屏幕板级抽象
│   ├── esp_webrtc/                  WebRTC 会话与媒体协商
│   ├── esp_peer/                    PeerConnection、ICE、SRTP 等
│   ├── av_render/                   音视频渲染
│   └── media_lib_utils/             线程、互斥、网络等适配
├── solutions/
│   ├── common/                      公共网络和媒体接口
│   └── doorbell_local/
│       ├── main/                    本作品业务源码、网页和资源
│       ├── tests/                   14 个验证入口及 13 个 C 测试
│       ├── sdkconfig.defaults.esp32p4
│       └── partitions.csv
└── docs/
    ├── bringup/                     调试日志和测试矩阵
    └── submission/                  开发日志、指南和录制脚本
```

## 4.2 模块职责与数据边界

| 层 | 核心文件 | 输入 | 核心处理 | 输出/下游 |
| --- | --- | --- | --- | --- |
| 构建配置 | `CMakeLists.txt`、`idf_component.yml`、`sdkconfig.defaults.esp32p4` | 板型、组件、功能开关 | 选择源码和版本、生成配置 | 固件和嵌入资源 |
| 板级适配 | `board.c`、`board_cfg.txt` | WT99P4C5-S1 名称 | 匹配 ES8311、I2S、PA、MIPI | 媒体输入输出设备 |
| 系统装配 | `main.c` | 网络、雷达、视觉回调 | 初始化、调度、事件汇合 | WebRTC、SSE 和来电请求 |
| 通话控制 | `webrtc.c` | 接听/挂断/开门/BOOT | 状态锁、PeerConnection 生命周期 | 音视频和控制事件 |
| HTTP 信令 | `webrtc_http_server.c` | SSE GET、JSON POST | 单活动会话、心跳、消息分类 | 浏览器与 WebRTC 回调 |
| 舵机 | `door_lock*.c` | OPEN_DOOR | 队列、PWM、状态机 | 舵机动作和网页状态 |
| 提示音 | `doorbell_audio_render.c`、`pcm_overlay.c` | AAC 解码 PCM、远端 PCM | 混音和饱和限幅 | ES8311 扬声器 |
| 雷达 | `radar_ld2450.c`、`presence_fusion.c` | UART 字节 | 解帧、区域、去抖、冷却 | 进入/离开和坐标事件 |
| 视觉 | `pedestrain_detect.cpp`、`vision_tracker.c` | RGB565LE 帧 | 推理、过滤、追踪、确认 | 人体框、置信度、人员证据 |
| 多模态 | `multimodal_fusion.c` | 雷达状态、视觉证据 | 两秒窗口、单次来访锁 | 自动来电请求 |
| 网页 | `webrtc_test.html` | SSE、POST、WebRTC | 中文 UI、事件、画框、重连 | 用户操作与远端画面 |

## 4.3 六条完整调用链

### 系统启动

```text
app_main
  → init_board
  → doorbell_webrtc_init
  → multimodal_fusion_init
  → door_lock_init
  → presence_fusion_init
  → radar_ld2450_init
  → media_sys_buildup
  → network_init
  → network_event_handler(connected)
  → start_webrtc
```

### BOOT 来电

```text
GPIO35 变化
  → key_monitor_thread
  → doorbell_request_ring("boot")
  → ring policy + 状态预留
  → SEND_CMD("RING") + 板端铃声
  → SSE
  → 浏览器来电 UI + 网页铃声
```

### 浏览器接听与视频出现

```text
接听按钮
  → sendCustomCommand("ACCEPT_CALL")
  → POST /webrtc/signal
  → door_bell_on_cmd
  → schedule_peer_connection_change(true)
  → SDP/ICE 交换
  → ESP_WEBRTC_EVENT_CONNECTED
  → 浏览器 ontrack
  → remoteVideo
```

### 通话中开门

```text
OPEN_DOOR
  ├─ door_lock_request_open → queue → door_lock_task → PWM 打开/复位
  └─ play_open_door_prompt_in_call
       → doorbell_audio_prompt_start
       → prompt_render_write
       → pcm_overlay_mix_mono
       → ES8311 扬声器
```

### 雷达与视觉自动来电

```text
LD2450 UART → parse → presence_fusion ──────────┐
                                                ├─ multimodal_fusion
OV5647 → ESP-DL → vision_tracker → vision event ┘
  → request_sensor_ring("radar+vision")
  → doorbell_request_ring
```

### 确认式挂断

```text
挂断按钮
  → DENY_CALL
  → 板端 disable PeerConnection
  → CALL_ENDED
  → finalizeHangup
  → 关闭 PC、停止本地麦克风、清空远端视频
```

## 五、逐文件讲解索引

| 文件 | 最值得展示的行 | 一句话讲法 |
| --- | --- | --- |
| `main/CMakeLists.txt` | 2～16 | 决定所有业务模块和嵌入资源是否进入固件 |
| `main/idf_component.yml` | 7～33 | 声明 AI 和 P4+C5 依赖，并锁定已验证传输版本 |
| `main/settings.h` | 21～44、52～61、68～76 | 板型、双视频支路、私密配置隔离和 BOOT |
| `board_cfg.txt` | 81～95 | WT99P4C5-S1 的 ES8311、I2S、PA、MIPI 映射 |
| `main.c` | 435～478 | 系统装配入口 |
| `main.c` | 141～213 | 雷达状态转事件、SSE 与融合输入 |
| `webrtc.c` | 333～405 | 所有来电来源共用的防重入入口 |
| `webrtc.c` | 557～619 | 开门、接听和挂断命令分发 |
| `webrtc.c` | 1052～1082 | WebRTC 连接状态回写 |
| `webrtc.c` | 1091～1125 | BOOT 按键监测 |
| `webrtc.c` | 1171～1407 | WebRTC、媒体和 AI 支路完整启动 |
| `webrtc.c` | 1423～1475 | 停止线程、模型和连接资源 |
| `webrtc_http_server.c` | 158～210 | SSE 心跳与刷新会话替换 |
| `webrtc_http_server.c` | 273～343 | POST 信令消息分类 |
| `door_lock.h` | 10～15 | 舵机 GPIO、频率、脉宽和保持时间 |
| `door_lock.c` | 84～125 | 异步开门—保持—复位 |
| `doorbell_audio_render.c` | 147～175 | 把提示音送入实时音频渲染路径 |
| `pcm_overlay.c` | 61～95 | 逐样本混音和 16 位限幅 |
| `radar_ld2450.h` | 11～38 | 雷达帧、目标和串口参数 |
| `radar_ld2450.c` | 29～123 | 帧校验、坐标解析和流重同步 |
| `presence_fusion.c` | 5～12、68～150 | 门前区域、去抖、方向和冷却 |
| `pedestrain_detect.cpp` | 66～228 | 两种存在模型、候选框、追踪与自动降帧 |
| `vision_tracker.c` | 6～18、214～280 | 阈值、4 帧 3 次确认及人数去重 |
| `vision_event.c` | 52～106 | 将框、分数和模型状态变成 JSON |
| `multimodal_fusion.c` | 24～81 | 雷达与两秒内视觉证据共同触发一次来电 |
| `webrtc_test.html` | 410～482 | 中文操作界面和事件说明 |
| `webrtc_test.html` | 647～755 | 雷达文字、视觉框和置信度 |
| `webrtc_test.html` | 927～1082 | SSE 重连和板端命令处理 |
| `webrtc_test.html` | 1139～1223 | PeerConnection 和断线恢复 |

## 六、容易讲错的内容

- 不能说“人脸识别”：当前仅做人脸存在检测，不保存身份特征。
- 不能说“86% 准确率”：它是单个候选框的模型置信分数。
- 不能说“雷达点云”：LD2450 输出最多三个二维目标点。
- 不能说“已完成雷达俯视图”：当前只有坐标、速度和中文事件，俯视轨迹是未来扩展。
- 不能把事件数量说成实时人数：它是有限历史记录。
- 不能说“已经安装真实门锁”：当前是空载 180° 模拟舵机。
- 不能说“屏幕已经启用”：屏幕只保留板级支持和未来扩展位置。
- 不能说“网页使用 WebSocket”：下行是 SSE，上行是 HTTP POST，媒体才是 WebRTC。
- RTP Transformer 是编码 RTP 包的调试变换示例，不是画质增强功能，正式演示无需开启。

## 七、超时删减方案

如果第一遍超过 10 分钟，按以下顺序删减：

1. 板级配置不逐个念 I2C/I2S 引脚。
2. POST 信令只说“SDP、ICE 和自定义命令”，不逐个展开。
3. WebRTC 启动不解释数据通道回调。
4. 雷达不讲距离分辨率字段。
5. 视觉不讲自动降帧的具体毫秒数。
6. 网页不讲框颜色和 CSS。
7. 结尾只说“14 项检查全部通过”。

不得删去：官方基线、WT99P4C5-S1 适配、统一来电入口、通话中音频混合、雷达与视觉双证据、非身份识别、当前未实现的四项边界。

## 八、录制前终端画面

自动检查应提前运行，录制时只展示结尾：

```powershell
$tests = Get-ChildItem '.\solutions\doorbell_local\tests\verify_*.py'
$failed = 0
foreach ($test in $tests) {
    python $test.FullName
    if ($LASTEXITCODE -ne 0) { $failed++ }
}
"VERIFY_TOTAL=$($tests.Count)"
"VERIFY_FAILED=$failed"
```

期望：

```text
VERIFY_TOTAL=14
VERIFY_FAILED=0
```

干净构建结尾应提前截取：

```text
Successfully created esp32p4 image.
doorbell_demo.bin binary size 0x68fd20 bytes.
Smallest app partition is 0x800000 bytes.
0x1702e0 bytes (18%) free.
Project build complete.
```

## 九、成片验收清单

- [ ] 时长不超过 10:00，建议 9:35～9:55。
- [ ] 开头出现姓名“吴迪”和官方项目来源。
- [ ] 每段先说职责，再展示关键行，再说输入、处理和输出。
- [ ] 所有行号与当前提交源码一致。
- [ ] 讲清 P4 主控和 C5 Wi-Fi 协处理器关系。
- [ ] 讲清 BOOT、SSE、POST 和 WebRTC 的三种不同通道。
- [ ] 讲清通话中提示音为何不会等到挂断后才播放。
- [ ] 讲清 X 是横向、Y 是前向距离，以及雷达不是点云。
- [ ] 讲清置信度不是身份或总体准确率。
- [ ] 讲清连续帧确认和雷达视觉双证据。
- [ ] 说明当前无真实门锁、无屏幕交互、无人脸身份识别、无雷达俯视轨迹。
- [ ] 展示 14 项检查、0 失败和干净构建成功。
- [ ] 全程没有显示 Wi-Fi 密码、私人路径、聊天通知或个人账号。
