wudi-tech/esp32-p4-c5-webrtc-doorbell/docs/submission/04_项目使用流程演示脚本.md

# 项目使用流程演示脚本（五分钟以内·逐句版）

## 一、成片目标

- 建议成片：4 分 30 秒，最长不得超过 5 分钟。
- 画面：1920×1080 横屏、30 FPS、MP4/H.264。
- 主画面：电脑录制中文网页；右下角画中画：手机横屏拍摄硬件。
- 核心原则：每一句功能介绍都要有对应画面证明，不用 PPT 代替实机操作。
- 本次作品使用空载舵机模拟门锁。画面中给舵机贴上“模拟门锁”标签，不要说已经安装真实门锁。

## 二、录制前布置

### 2.1 电脑画面

1. 关闭微信、邮箱、浏览器收藏栏和系统通知。
2. 只保留一个门铃测试网页标签页。
3. 浏览器缩放调到 90%～100%，确保同时看见门外画面、接听/挂断/开门按钮、视觉状态和传感器事件。
4. 页面提前打开到 `https://设备当前IP/webrtc/test`，等待显示“已连接到门铃设备”。
5. 首次录制前确认浏览器已经允许麦克风权限。

### 2.2 手机硬件画面

1. 手机横屏固定，画面内同时包含主板、摄像头、扬声器、LD2450 雷达、舵机和电源板。
2. 舵机摇臂不要被排线遮挡；扬声器靠近手机，但不要堵住振膜。
3. 雷达正前方预留 0.3～3 米行走区域。
4. 手机以 1080p/30 FPS 拍摄，锁定对焦和曝光，避免开发板屏幕或电脑显示器频闪。

### 2.3 音频安排

- 讲解人佩戴耳机，避免浏览器声音再次被门铃麦克风采集形成回授。
- 手机负责录板端扬声器、铃声和舵机声音；电脑录屏负责网页画面和讲解麦克风。
- 开始正式录制前，先试录 10 秒并确认“人声、板端铃声、开门播报”都能听清。

## 三、正式分镜与全部台词

## 0:00～0:25　作品和硬件介绍

**完整台词：**

> 大家好，我是吴迪。这是我基于 Espressif `esp-webrtc-solution` 本地门铃例程复刻并扩展的 ESP32-P4 加 ESP32-C5 多模态智能门铃。ESP32-P4 负责音视频、AI 和业务控制，板载 ESP32-C5 负责 Wi-Fi；我另外加入了毫米波雷达、舵机模拟开锁、中文网页和摄像头人员存在检测。

**电脑画面：** 开始时显示中文网页全景，标题“智能门铃 WebRTC 测试台”和“已连接到门铃设备”必须可见。

**手机画面：** 从整机全景缓慢推近，依次用手指示主板、OV5647 摄像头、LD2450 雷达、扬声器、舵机和供电板。

**操作动作：** 暂不点击任何按钮，硬件保持静止。

**成功标志：** 网页已经连接，视频区域不是断线提示；所有硬件均在画面内。

**补拍方法：** 如果手机扫动模糊，只补拍一段 8 秒硬件慢推镜头，后期覆盖在这段口播上。

## 0:25～0:50　供电、接线与网页状态

**完整台词：**

> 摄像头接主板 MIPI-CSI，四欧三瓦扬声器接 SPK。雷达通过 GPIO4 和 GPIO5 使用二十五万六千波特率通信，舵机 PWM 接 GPIO32。雷达和舵机由独立五伏电源分路供电，并与主板共地。电脑和门铃位于同一个局域网，所有音视频和控制都在本地完成。

**电脑画面：** 鼠标依次指向“门外画面”“视觉状态”“传感器事件”和底部连接状态，不打开任何弹窗。

**手机画面：** 固定近景，手指依次指出摄像头排线、SPK 插头、雷达四线、舵机三线和公共地线。

**操作动作：** 不拔插任何带电接线。

**成功标志：** 页面连接状态为绿色或明确显示已连接，摄像头画面持续更新。

**补拍方法：** 接线细节看不清时单独拍摄断电后的接线特写，不要在带电状态重新插线。

## 0:50～1:25　雷达与摄像头人员检测

**完整台词：**

> 现在我从雷达正前方进入门前区域。网页会显示目标的横向 X、前向 Y 和移动速度；摄像头会尝试给出行人或近距离人脸存在框和置信度。系统只判断这里是否有人，不进行人脸身份识别。传感器事件的数字表示进入、离开或视觉状态变化的历史条数，并不是当前人数。

**电脑画面：** 主画面保持网页全景。进入后放大或短暂裁切到雷达坐标、视觉状态和最新一条传感器事件，再恢复全景。

**手机画面：** 一个人从雷达正前方约 2 米处走入，在摄像头前保持完整上半身或全身 3～5 秒。

**操作动作：** 进入时不要快速横穿；站稳后轻微移动，让雷达和摄像头都有清晰输入。

**成功标志：** 至少拍到雷达门前目标/进入事件；摄像头检测成功时还能看到框和置信度。摄像头暂时没有框时，不要把雷达结果说成摄像头结果。

**补拍方法：** 如果视觉框没有出现，先改善正面光线并退到能拍到上半身的位置，再单独补拍这段；连续三次仍未出现时，保留雷达成功画面并把口播中的“会显示”改成“用于辅助判断”。

## 1:25～1:55　BOOT 实体按键触发来电

**完整台词：**

> 接下来演示实体门铃。现在我只按一次开发板的 BOOT 按键。可以看到，网页立即进入来电状态，板端扬声器开始响铃，网页铃声也会按板端状态停止，不会一直无限播放。

**电脑画面：** 网页全景，必须拍到接听按钮进入来电状态。

**手机画面：** 近景清楚拍到手指按下并松开 BOOT，同时保留扬声器在画面中。

**操作动作：** 先确认网页已连接，再短按一次 BOOT；来电出现后暂不接听，保留 2～3 秒铃声证据。

**成功标志：** 一镜内同时看到按键动作和网页来电，且录到板端铃声。

**补拍方法：** 若第一次没有来电，停止本条录制，等待页面重新显示已连接后重拍完整动作；不要把不同时间的按键和来电硬拼成一次操作。

## 1:55～2:50　接听、实时视频与双向语音

**完整台词：**

> 我现在点击接听。局域网内通常四到六秒即可建立连接。这里显示的是门铃端 OV5647 摄像头发送到浏览器的实时视频。下面验证双向语音。首先我对门铃端麦克风说：这是门铃端发送到浏览器的声音。然后我对电脑麦克风说：这是浏览器发送到门铃扬声器的声音。两句话分别验证了两个相反的音频方向。

**电脑画面：** 点击“接听”后保持全景，拍到连接状态变化和门外视频开始播放。双向语音时画面不要切走。

**手机画面：** 拍到开发板、板载麦克风所在区域和扬声器。说第一句时嘴靠近板载麦克风约 20 厘米；说第二句时对电脑麦克风说，并让手机录到板端扬声器播放的声音。

**操作动作：**

1. 点击“接听”。
2. 等视频稳定后，面对板端麦克风清楚说：“这是门铃端发送到浏览器的声音。”
3. 停顿 1 秒，面对电脑麦克风说：“这是浏览器发送到门铃扬声器的声音。”

**成功标志：** 浏览器出现板端实时视频；第一句话能从电脑耳机听到；第二句话能从板端扬声器听到。

**补拍方法：** 如果浏览器未授权麦克风，先结束录制并授权后重拍。若接通超过 10 秒，重新刷新页面并重拍，不在成片中保留长时间等待。若发生回声，降低扬声器音量并确认使用耳机。

## 2:50～3:35　通话中开门、语音播报和自动复位

**完整台词：**

> 通话保持期间，我点击开门。GPIO32 输出五十赫兹 PWM，舵机转到打开位置；同时板端播报“Doors open, come in please”。这段提示音会混入正在播放的通话音频，所以播报时通话不会中断。当前舵机只模拟门锁，保持大约五秒后会自动回到锁定位置，真实产品还需要锁体和位置反馈。

**电脑画面：** 点击“开门”，保持网页全景，拍到“正在开门”“门已打开”“正在关门”和“门已锁定”中的主要状态变化。

**手机画面：** 舵机改为较大的硬件画中画，必须完整拍到摇臂转到打开位置、停留和返回；扬声器仍要收音。

**操作动作：** 点击开门后不要挂断；在播报结束后再对电脑麦克风说一句“通话仍在继续”，证明通话链路未中断。

**成功标志：** 舵机动作、开门语音和网页状态至少各出现一次；约五秒后舵机回到初始位置；远程视频始终继续播放。

**补拍方法：** 舵机未入镜时重新调整手机机位后整段重拍。若语音太小，只重录硬件声音并与同一次操作的电脑录屏同步，不使用其他日期的声音替代。

## 3:35～4:05　挂断、状态清理与再次来电

**完整台词：**

> 现在点击挂断。可以看到视频停止，页面回到可再次呼叫的状态。等待几秒后，我再按一次 BOOT，网页能够再次显示来电；这次我直接挂断。这个步骤证明上一通通话的媒体和门铃状态已经正确清理，系统可以连续使用。

**电脑画面：** 拍到点击挂断、视频清空和按钮恢复；随后拍到第二次来电，再点击挂断或拒绝。

**手机画面：** 第一次挂断时保持整机全景；第二次短按 BOOT 时切到按键近景。

**操作动作：** 挂断后等待页面状态稳定 3 秒，再短按一次 BOOT；第二次来电保留 2 秒后结束。

**成功标志：** 第一次视频和音频确实停止；第二次来电成功出现；结束后网页再次恢复空闲。

**补拍方法：** 第二次来电未出现时，不保留失败片段；先等页面 SSE 重连成功，再从“第一次挂断”开始重拍这一整段。

## 4:05～4:30　总结

**完整台词：**

> 以上就是作品的完整流程。我完成了官方本地 WebRTC 门铃核心功能在 WT99P4C5-S1 上的移植，并增加了中文交互、舵机模拟开门、毫米波雷达、摄像头人员存在检测和多模态触发。当前版本面向局域网单客户端演示，后续可以扩展真实门锁、配套屏幕、人脸身份识别和雷达俯视轨迹。谢谢观看。

**电脑画面：** 恢复中文网页完整画面，停留在已连接且空闲状态。

**手机画面：** 硬件全景，最后 3 秒不移动镜头。

**操作动作：** 不再触发功能。

**成功标志：** 最后同时看清作品网页和完整硬件，不出现隐私信息或错误提示。

## 四、推荐后期布局

- 0:00～0:50：硬件画面占 50%，网页占 50%。
- 0:50～2:50：网页为主，硬件画中画约占宽度 25%。
- 2:50～3:35：舵机画中画放大到约 35%。
- 3:35～4:05：按 BOOT 时短暂放大硬件画面，来电后恢复网页主画面。
- 4:05～4:30：左右分屏，网页与整机各占一半。

只允许剪掉等待、口误和重复操作；不要通过剪辑制造一次实际上没有完成的连续操作。关键的 BOOT 来电、通话中开门以及挂断后第二次来电，应各自保留连续证据。

## 五、超时删减顺序

如果初剪超过 5 分钟，按以下顺序删减：

1. 删去 0:25～0:50 中逐根线说明，只保留 GPIO4、GPIO5、GPIO32、独立 5 V 和共地。
2. 删除每次按钮操作后的空白等待，只保留状态变化前后各 1 秒。
3. 总结压缩为一句：“我完成了官方门铃核心功能移植，并增加舵机、雷达、视觉检测、中文界面和融合触发。”
4. 不得删除双向语音、通话中开门、五秒复位、挂断后再次来电和“舵机模拟门锁”说明。

## 六、成片验收清单

- [ ] 总时长不超过 5:00，建议 4:20～4:40。
- [ ] 1920×1080 横屏，网页文字暂停时可以读清。
- [ ] 一镜内看到手按 BOOT 和网页进入来电状态。
- [ ] 浏览器显示板端摄像头实时画面。
- [ ] 两个方向的音频使用两句不同台词，声音方向可判断。
- [ ] 通话中点击开门，录到舵机动作、语音播报和视频持续播放。
- [ ] 录到舵机约五秒后自动复位。
- [ ] 挂断后媒体停止，并成功触发第二次来电。
- [ ] 明确说出“舵机模拟门锁”和“不做人脸身份识别”。
- [ ] 没有 Wi-Fi 密码、个人聊天、系统通知或家庭隐私区域。
- [ ] 人声清晰，无削波、喷麦、严重风噪或音频回授。
