wudi-tech/esp32-p4-c5-webrtc-doorbell/docs/submission/06_最终提交检查表.md

---
artifact: launch-checklist
version: "1.0"
created: 2026-09-14
status: in-progress
---

# ESP32-P4+C5 多模态 WebRTC 智能门铃提交检查表

## 提交概览

| 项目 | 内容 |
| --- | --- |
| 提交类型 | 完整作品/重大版本 |
| 负责人 | 参赛者 |
| 截止时间 | 正式提交前 |
| Go/No-Go 决策人 | 参赛者 |

## 必须项（阻塞提交）

| 检查项 | 负责人 | 截止时间 | 状态 | 说明 |
| --- | --- | --- | --- | --- |
| 实机完整运行 | 参赛者 | 提交前 | 已完成 | 2026-09-14 用户确认主要流程基本无问题 |
| 最终 P4 固件 | Codex | 提交前 | 已完成 | COM5 烧录与哈希验证通过 |
| 完整源码包 | Codex | 提交前 | 已完成 | 已排除构建缓存、Git 历史和 Wi-Fi 私有配置 |
| 开发日志 | Codex | 提交前 | 已完成 | `01_开发日志.md` |
| 使用指南 | Codex | 提交前 | 已完成 | `02_使用指南.md` |
| 收音清晰的代码录屏 | 参赛者 | 提交前 | 待完成 | 按 `03_代码录屏讲解脚本.md` 录制 |
| 横屏项目流程演示 | 参赛者 | 提交前 | 待完成 | 按 `04_项目使用流程演示脚本.md` 录制 |
| 检查所有视频可播放 | 参赛者 | 提交前 | 待完成 | 从头到尾播放，无损坏、无静音 |
| 删除敏感信息 | 参赛者 | 提交前 | 待确认 | Wi-Fi 密码、通知、聊天、家庭隐私 |

## 建议项

| 检查项 | 负责人 | 截止时间 | 状态 | 说明 |
| --- | --- | --- | --- | --- |
| 复刻过程加分视频 | 参赛者 | 提交前 | 待完成 | 5～7 分钟横屏 |
| 主板与接线高清照片 | 参赛者 | 提交前 | 待完成 | 至少全景、雷达、舵机供电三张 |
| 视频字幕 | 参赛者 | 提交前 | 待完成 | 关键术语和测试结果加字幕 |
| 封面图 | 参赛者 | 提交前 | 待完成 | 作品名、开发板、网页同框 |

## 工程与质量

| 检查项 | 负责人 | 截止时间 | 状态 | 证据 |
| --- | --- | --- | --- | --- |
| 14 个验证入口全部通过 | Codex | 已完成 | 已完成 | 2026-09-16 重新执行（新增 `verify_pcm_overlay.py`、`verify_pedestrian_filter.py`），14/14 通过；13 个 C 单元测试全部被覆盖 |
| ESP-IDF 5.5.5 完整构建 | Codex | 已完成 | 已完成 | `doorbell_demo.bin` 约 6.89 MB |
| 应用分区未溢出 | Codex | 已完成 | 已完成 | 8 MB 分区剩余约 18% |
| BOOT 呼叫 | Codex/参赛者 | 已完成 | 已完成 | GPIO35 边沿与 `ACCEPTED` 日志 |
| 视频、双向音频、开门、挂断 | 参赛者 | 已完成 | 已完成 | 最终实机测试确认 |
| 源码包无真实 Wi-Fi 配置 | Codex | 提交前 | 已完成 | 固件、源码目录和源码压缩包扫描结果均为 0 命中 |
| 发布文件 SHA-256 | Codex | 提交前 | 已完成 | 见 `SHA256SUMS.md` |

## Go / No-Go 标准

只有以下条件全部满足才提交：

- [ ] 两段必交视频已录制并完整播放检查。
- [ ] 源码、固件、开发日志和使用指南均在最终目录中。
- [ ] 视频与文档没有真实 Wi-Fi 密码或私人信息。
- [ ] 视频中明确说明“舵机模拟门锁”“不做人脸身份识别”。
- [ ] 文件名、作品名和版本日期一致。
- [ ] 最终压缩包大小满足提交平台限制。

## 回退方案

如果录制前发现严重回归：

1. 保留当前已验证固件和发布包，不立即覆盖。
2. 使用最终发布包中的三个 `.bin` 文件恢复 P4。
3. 重新运行 BOOT、接听、音视频、开门、挂断、二次呼叫五项冒烟测试。
4. 只有恢复版本通过后才继续录制。

负责人：参赛者。预计恢复和冒烟测试时间：20～40 分钟。

## 检查节奏

| 时间点 | 动作 | 参与人 |
| --- | --- | --- |
| 录制前 | 清洁镜头、检查接线、完整冒烟测试 | 参赛者 |
| 每段录完 | 立即回放声音、焦点、横屏和网页文字 | 参赛者 |
| 提交前一天 | 核对目录、隐私、文件大小和校验值 | 参赛者 |
| 正式上传后 | 下载平台文件并抽查可播放性 | 参赛者 |

## 当前开放项

| 问题 | 负责人 | 状态 | 影响 |
| --- | --- | --- | --- |
| 两段必交视频尚未录制 | 参赛者 | 开放 | 阻塞提交 |
| 加分过程视频尚未录制 | 参赛者 | 可选 | 不阻塞，但影响加分 |
| 真实门锁和屏幕未集成 | 后续扩展 | 已知边界 | 不阻塞，演示中必须如实说明 |
