wudi-tech/esp32-p4-c5-webrtc-doorbell/docs/submission/09_提交源码完备性审计.md

> 历史审计原文：其中部分关于状态模块接入、雷达界面和构建版本的判断已由后续代码分析纠正。公开归档当前结论见 [项目状态](../PROJECT_STATUS.md)，本次主机复跑见 [验证记录](../VALIDATION.md)。

# 提交源码完备性审计

作者：吴迪  
审计日期：2026-09-16  
审计对象：`wt99-webrtc-native` 中 WT99P4C5-S1 本地 WebRTC 智能门铃提交源码

## 一、结论

本次提交的项目自有源码、构建配置、网页、音频资源、证书、测试入口和说明文件齐全。使用 ESP-IDF v5.5.5、ESP32-P4 目标，从全新的 `build-audit` 目录完成了 1850 个构建步骤，成功生成 `doorbell_demo.bin`。镜像大小为 `0x68fd20` 字节，8 MiB 应用分区剩余 `0x1702e0` 字节，即 18%。

为避免干净环境自动解析到不兼容的 P4+C5 通信组件，本次补充了两项精确版本约束：`esp_hosted 2.12.12`、`esp_wifi_remote 1.6.3`；同时把远程 Wi-Fi 缓冲区参数写入 P4 默认配置。经过这一修正，源码可以在不依赖旧 `sdkconfig` 的情况下重新配置并构建。

结论中的“完备”表示：

- 所有生产源文件均已被构建系统纳入，或作为明确的头文件、网页、证书、音频资源使用；
- 项目可以从源码解析依赖、配置、编译和链接；
- 14 个 `verify_*.py` 自动检查入口覆盖协议、状态机、音频混音、行人假阳性过滤、视觉、融合、网页和板级配置，并把 `tests` 目录下 13 个 C 单元测试全部编译执行；
- 提交包不包含真实 Wi-Fi 密码、临时编译目录和本机生成的 `sdkconfig`；历史调试日志可能保留非机密的本机构建路径，录屏时不要展示这些日志；
- 硬件真实性不能只靠静态代码证明，摄像头识别效果、雷达坐标、扬声器音量、舵机负载和长通话稳定性仍以横屏实机视频为最终证据。

## 二、构建证据

| 项目 | 审计结果 |
| --- | --- |
| ESP-IDF | v5.5.5 |
| 构建目标 | `esp32p4` |
| 主板配置 | `WT99P4C5_S1` |
| P4+C5 传输依赖 | `esp_hosted 2.12.12`、`esp_wifi_remote 1.6.3` |
| 行人模型 | `pedestrian_detect 0.3.2`，模型被打包进构建 |
| 人脸存在模型 | `human_face_detect 0.5.0`，仅做近距离存在证据，不做身份识别 |
| 构建步骤 | 1850/1850 完成 |
| 产物 | `doorbell_demo.bin` |
| 应用大小 | `0x68fd20` 字节 |
| 分区余量 | `0x1702e0` 字节，18% |
| 自动检查 | 14 个入口，全部通过；13 个 C 单元测试全部被覆盖 |

构建过程中还生成并嵌入了 `ring.aac`、`open.aac`、`join.aac`、`webrtc_test.html`、HTTPS 证书、行人模型和人脸存在模型，说明这些资源不是“放在目录里但未使用”。

## 三、构建、配置与资源文件逐项审计

| 文件 | 职责 | 接入证据 | 结论 |
| --- | --- | --- | --- |
| `solutions/doorbell_local/CMakeLists.txt` | ESP-IDF 工程入口 | 干净构建从该工程入口完成 | 完备 |
| `solutions/doorbell_local/main/CMakeLists.txt` | 登记 21 个 C 模块、1 个条件 C++ 模块及嵌入资源 | 构建日志逐项编译并嵌入资源 | 完备 |
| `solutions/doorbell_local/main/idf_component.yml` | 声明 H.264、人员模型及本地 WebRTC 组件依赖 | 依赖解析成功；P4+C5 版本已精确约束 | 完备 |
| `solutions/doorbell_local/main/Kconfig` | 提供门铃 AI 等功能开关 | `CONFIG_DOORBELL_SUPPORT_PEDESTRIAN_DETECT=y` 生效 | 完备 |
| `solutions/doorbell_local/main/settings.h` | 板型、视频、检测、Wi-Fi 和 BOOT 配置 | 被 `main.c`、`webrtc.c` 等编译读取 | 完备 |
| `solutions/doorbell_local/main/settings.local.h.example` | 私密 Wi-Fi 配置模板 | 真值文件被 `.gitignore` 排除 | 完备且无隐私泄漏 |
| `solutions/doorbell_local/sdkconfig.defaults` | 通用 ESP-IDF 默认参数 | 重新配置时加载 | 完备 |
| `solutions/doorbell_local/sdkconfig.defaults.esp32p4` | P4、OV5647、C5 SDIO、远程 Wi-Fi、AI 默认参数 | 干净配置和构建成功 | 完备 |
| `solutions/doorbell_local/sdkconfig.defaults.esp32p4_eye` | P4 Eye 变体默认配置 | 保留上游兼容入口，不参与本板构建 | 完备，非本板入口 |
| `solutions/doorbell_local/sdkconfig.defaults.esp32s3` | S3 变体默认配置 | 保留上游兼容入口，不参与本板构建 | 完备，非本板入口 |
| `solutions/doorbell_local/partitions.csv` | NVS、工厂应用和人员模型分区 | 构建生成分区表并通过尺寸检查 | 完备 |
| `solutions/doorbell_local/README.md` | 原例程和本地运行说明 | 随源码提交 | 完备 |
| `components/codec_board/board_cfg.txt` | WT99P4C5-S1 的 I2C、I2S、功放、摄像头和屏幕板级定义 | `TEST_BOARD_NAME` 匹配该配置 | 完备 |
| `solutions/common/network.c` | Wi-Fi 初始化；显式配置优先于旧 NVS | 板级校验脚本检查该优先级 | 完备 |
| `solutions/common/media_sys.h` | 公共媒体接口声明 | `media_sys.c`/WebRTC 调用 | 完备 |
| `solutions/doorbell_local/main/ring.aac` | 板端来电铃声 | 构建生成 `ring.aac.S` | 完备 |
| `solutions/doorbell_local/main/open.aac` | 开门语音 | 构建生成 `open.aac.S` | 完备 |
| `solutions/doorbell_local/main/join.aac` | 接通提示音 | 构建生成 `join.aac.S` | 完备 |
| `solutions/doorbell_local/main/certs/servercert.pem` | 本地 HTTPS 服务端证书 | 构建生成 `servercert.pem.S` | 完备；演示环境为自签名证书 |
| `solutions/doorbell_local/main/certs/prvtkey.pem` | 本地 HTTPS 私钥 | 构建生成 `prvtkey.pem.S` | 完备；仅适用于局域网演示 |
| `solutions/doorbell_local/main/webrtc_test.html` | 中文网页、SSE/POST 信令、WebRTC 媒体、检测框和雷达俯视图 | 构建生成 `webrtc_test.html.S` | 完备 |

说明：工作树里的三段 AAC 可能显示为符号链接；最终提交快照和 ZIP 中必须保存为真实 ADTS AAC 数据。自动检查会验证文件头，不能提交只含链接文字的占位文件。

## 四、生产源码逐项审计

### 4.1 系统装配、板级与媒体

| 文件 | 主要职责 | 构建/调用证据 | 结论 |
| --- | --- | --- | --- |
| `main/board.c` | 初始化 codec board、音频输入输出和功放 | `app_main()` 调用 `init_board()`；已编译 | 完备 |
| `main/common.h` | 门铃公共宏、命令和接口声明 | 被主流程与 WebRTC 模块包含 | 完备 |
| `main/main.c` | 系统入口、网络回调、任务调度、雷达/视觉事件汇合 | `app_main()`、`network_event_handler()` 已编译 | 完备 |
| `main/media_sys.c` | 摄像头和音频媒体系统、提示音播放器 | `start_webrtc()` 前构建媒体系统；已编译 | 完备 |

### 4.2 WebRTC、信令与状态

| 文件 | 主要职责 | 构建/调用证据 | 结论 |
| --- | --- | --- | --- |
| `main/webrtc.c` | WebRTC 生命周期、BOOT 来电、接听/挂断、开门命令、AI 检测支路 | `start_webrtc()`/`stop_webrtc()` 主链路已编译 | 完备 |
| `main/webrtc_http_server.c` | HTTPS 页面、SSE 下行、POST 上行、刷新会话替换 | `webrtc_signal_get_handler()`/`post_handler()` 已编译 | 完备 |
| `main/webrtc_http_server.h` | HTTP 信令接口 | 被 `webrtc.c` 使用 | 完备 |
| `main/doorbell_ring_policy.c` | 来电策略、防重入和状态判断 | `doorbell_request_ring()` 调用；有主机测试 | 完备 |
| `main/doorbell_ring_policy.h` | 来电策略类型与接口 | 生产代码和测试共同使用 | 完备 |
| `main/doorbell_status.c` | 统一门铃/通话/门锁状态快照 | WebRTC 与网页状态发布使用；有测试 | 完备 |
| `main/doorbell_status.h` | 状态模型接口 | 生产代码和测试共同使用 | 完备 |
| `main/doorbell_event.c` | 雷达与门铃事件 JSON 格式化 | `main.c` 发布事件时调用；有测试 | 完备 |
| `main/doorbell_event.h` | 事件结构与序列化接口 | 生产代码和测试共同使用 | 完备 |

### 4.3 舵机与音频提示

| 文件 | 主要职责 | 构建/调用证据 | 结论 |
| --- | --- | --- | --- |
| `main/door_lock.c` | GPIO32、50 Hz PWM、命令队列、开门保持及自动复位 | `door_bell_on_cmd()` 调用；已编译 | 完备 |
| `main/door_lock.h` | 舵机引脚、脉宽、动作时间和接口 | 生产代码及审计脚本读取 | 完备 |
| `main/door_lock_state.c` | 锁定、开启、保持、复位、失败状态机 | 舵机任务调用；有主机测试 | 完备 |
| `main/door_lock_state.h` | 舵机状态和事件定义 | 生产代码和测试共同使用 | 完备 |
| `main/doorbell_audio_render.c` | 提示音解码、在通话渲染路径中叠加提示 PCM | WebRTC 开门提示调用；已编译 | 完备 |
| `main/doorbell_audio_render.h` | 提示音渲染接口 | `webrtc.c` 使用 | 完备 |
| `main/pcm_overlay.c` | 单声道 PCM 混音、饱和限幅、缓冲同步 | `prompt_render_write()` 调用；有测试 | 完备 |
| `main/pcm_overlay.h` | PCM 叠加器状态和接口 | 生产代码和测试共同使用 | 完备 |

### 4.4 LD2450 雷达与存在状态

| 文件 | 主要职责 | 构建/调用证据 | 结论 |
| --- | --- | --- | --- |
| `main/radar_ld2450.c` | 30 字节帧解析、流重同步、UART 任务和掉线提示 | `app_main()` 初始化；真实样本有测试 | 完备 |
| `main/radar_ld2450.h` | 三目标结构、帧常量、GPIO4/5 和 256000 波特率 | 生产代码和解析测试共同使用 | 完备 |
| `main/presence_fusion.c` | 门前区域、进入/离开去抖、冷却、方向判定 | 雷达回调调用；有测试 | 完备 |
| `main/presence_fusion.h` | 雷达存在状态机结构和接口 | 生产代码和测试共同使用 | 完备 |

### 4.5 摄像头检测、追踪与多模态融合

| 文件 | 主要职责 | 构建/调用证据 | 结论 |
| --- | --- | --- | --- |
| `main/pedestrain_detect.cpp` | 获取 RGB565LE 检测支路、运行行人/人脸存在模型、形成快照 | 条件源已编译，两个模型已打包 | 完备；文件名沿用项目历史拼写 |
| `main/pedestrian_filter.c` | 候选框分数、尺寸、位置和连续帧过滤 | 检测任务使用；有主机测试 | 完备 |
| `main/pedestrian_filter.h` | 候选过滤器接口 | 生产代码和测试共同使用 | 完备 |
| `main/pedestrian_format_probe.c` | 检测输入像素格式和字节序探测 | 检测任务使用；有主机测试 | 完备 |
| `main/pedestrian_format_probe.h` | 像素格式探测接口 | 生产代码和测试共同使用 | 完备 |
| `main/camera_motion.c` | 辅助运动证据和亮度变化过滤 | 已纳入构建；有主机测试 | 完备 |
| `main/camera_motion.h` | 运动检测接口 | 生产代码和测试共同使用 | 完备 |
| `main/vision_tracker.c` | 候选关联、4 帧窗口 3 次命中确认、丢失清除 | 检测任务调用；有主机测试 | 完备 |
| `main/vision_tracker.h` | 检测框、追踪槽位、快照数据结构 | 生产代码、事件层和测试共同使用 | 完备 |
| `main/vision_event.c` | 把追踪快照序列化为网页 JSON | `main.c` 发布视觉事件；有测试 | 完备 |
| `main/vision_event.h` | 视觉快照回调和 JSON 接口 | 生产代码和测试共同使用 | 完备 |
| `main/multimodal_fusion.c` | 雷达存在、视觉证据有效期和单次来访只响一次 | `main.c` 同时输入雷达与视觉证据；有测试 | 完备 |
| `main/multimodal_fusion.h` | 多模态融合状态和接口 | 生产代码和测试共同使用 | 完备 |

## 五、测试文件逐项审计

### 5.1 自动检查入口

| 文件 | 覆盖内容 | 结论 |
| --- | --- | --- |
| `tests/verify_wt99p4c5_config.py` | P4/C5、主板、摄像头、Wi-Fi、音频资源、刷新和断线配置 | 通过 |
| `tests/verify_radar_ld2450.py` | LD2450 帧解析、流重同步、真实样本和 UART 接入 | 通过 |
| `tests/verify_presence_fusion.py` | 门前区域、进入/离开、冷却和方向 | 通过 |
| `tests/verify_task_8_3_8_4.py` | 门铃策略、事件、网页控制和 任务 8.3/8.4 集成 | 通过 |
| `tests/verify_door_lock.py` | 舵机状态机、PWM 参数和异步动作 | 通过 |
| `tests/verify_doorbell_status.py` | 通话、来电、开门状态快照 | 通过 |
| `tests/verify_doorbell_ring_policy.py` | 重复来电、通话中来电和恢复策略 | 通过 |
| `tests/verify_round_two_ui.py` | 中文界面、事件窗口、挂断和开门反馈 | 通过 |
| `tests/verify_hybrid_vision_ui.py` | 视觉框、置信度、雷达距离文字和混合状态显示 | 通过 |
| `tests/verify_vision_runtime_safety.py` | 检测线程栈、缓冲生命周期、静态 JSON 和运行安全 | 通过 |
| `tests/verify_vision_event.py` | 视觉事件 JSON 字段和边界 | 通过 |
| `tests/verify_vision_tracker.py` | 分数门限、连续帧确认、目标关联和清除 | 通过 |
| `tests/verify_pcm_overlay.py` | 提示音混音、16 位饱和限幅、重启/停止、单声道填充静音输出和后备触发判定 | 通过（2026-09-16 新增） |
| `tests/verify_pedestrian_filter.py` | 整幅满屏框假阳性拒绝、0.70 门限、连续三帧确认、丢失清除和非法输入安全 | 通过（2026-09-16 新增） |

> 补充说明：上述 14 个入口使用 `D:\mingw64\bin\gcc.exe`（可用环境变量 `CC` 覆盖）编译并运行 C 测试，因此 `tests` 目录下 13 个 `*_test.c` 全部被自动检查覆盖，不存在"写了测试但没被执行"的文件。

### 5.2 配套 C 测试和样本

| 文件 | 覆盖内容 | 结论 |
| --- | --- | --- |
| `tests/radar_ld2450_parser_test.c` | 完整帧、坏帧、分段输入和噪声重同步 | 完备 |
| `tests/presence_fusion_test.c` | 区域、去抖、离开和冷却 | 完备 |
| `tests/multimodal_fusion_test.c` | 雷达/视觉先后顺序、证据过期和单次来访 | 完备 |
| `tests/doorbell_ring_policy_test.c` | 来电策略状态组合 | 完备 |
| `tests/doorbell_event_test.c` | 事件 JSON | 完备 |
| `tests/doorbell_status_test.c` | 状态快照与转换 | 完备 |
| `tests/door_lock_state_test.c` | 舵机状态转换 | 完备 |
| `tests/pcm_overlay_test.c` | 混音、限幅和缓冲耗尽 | 完备 |
| `tests/pedestrian_filter_test.c` | 候选有效性和连续帧过滤 | 完备 |
| `tests/pedestrian_format_probe_test.c` | RGB565 大小端和输入格式 | 完备 |
| `tests/camera_motion_test.c` | 运动辅助证据 | 完备 |
| `tests/vision_tracker_test.c` | 多目标追踪、确认和清除 | 完备 |
| `tests/vision_event_test.c` | 视觉快照序列化 | 完备 |
| `tests/data/ld2450_live_idle.hex` | 雷达空闲真实样本 | 完备 |
| `tests/data/ld2450_live_one_target.hex` | 雷达单目标真实样本 | 完备 |

## 六、上游源码与提交边界

提交快照共有约 476 个文件。除上述项目自有和适配文件外，其余主要来自 Espressif `esp-webrtc-solution` 基线及仓库内本地组件，例如 `esp_webrtc`、`esp_peer`、`av_render`、`codec_board` 和 `media_lib_utils`。这些上游文件由构建系统整体使用，不应为了“显得精简”随意删除，因此在审计中按组件整体保留，不逐个改写职责。

下列内容不应进入最终源码快照：

- `build/`、`build-audit/`、`managed_components/`；
- 本机生成的 `sdkconfig`、`sdkconfig.audit`；
- `settings.local.h` 和真实 Wi-Fi 凭据；
- `.git/`、编辑器缓存、PID、临时日志；
- 含本机绝对路径的自动生成 `dependencies.lock`。

不提交 `managed_components` 不代表缺少源码：ESP-IDF Component Manager 会按 `idf_component.yml` 解析外部依赖；本仓库覆盖的核心组件则已在 `components/` 中随包提供。

## 七、必须由实机视频证明的项目

以下项目不能被“编译通过”替代，提交视频中应至少各出现一次：

1. BOOT 按键触发网页来电，网页和板端铃声停止逻辑一致；
2. 网页接听后能看到板载摄像头视频并双向通话；
3. 通话中点击开门，舵机执行且能听到开门提示；
4. LD2450 事件中的横向 X、前向 Y、速度和进出状态与人的实际移动一致；当前版本没有雷达俯视轨迹，不应在视频中宣称已经实现；
5. 摄像头只做人员/人脸存在判断，不宣称身份识别；
6. 雷达与视觉均提供证据后触发一次来电，同一来访不连续累积来电；
7. 挂断后音视频真正停止，刷新网页后仍可再次来电；
8. 连续运行期间没有重启、看门狗、栈溢出或舵机持续堵转。

## 八、最终判定

- 源码完整性：通过。
- 干净构建：通过。
- 自动检查：通过。
- Wi-Fi 凭据与临时构建文件隔离：通过；最终扫描未发现真实 SSID 或密码。
- 实机功能：已有用户测试确认“基本没有问题”，最终以待录制的横屏演示视频为提交证据。
- 当前产品边界：舵机为空载门锁模拟；配套屏幕和人脸身份识别为未来扩展项，不应在当前成片中宣称已经实现。
