wudi-tech/esp32-p4-c5-webrtc-doorbell/docs/submission/10_代码结构从0讲清.md

# 代码结构从 0 讲清

作者：吴迪  
面向：需要独立讲清本项目代码的作者本人  
对象版本：`02_项目完整源码`（2026-09-16 快照，ESP-IDF v5.5.5，目标 ESP32-P4）  
配套材料：`01_开发日志.md`（做了什么）、`02_使用指南.md`（怎么跑）、`03_代码录屏讲解脚本.md`（怎么录）、本篇（代码为什么这样写）

> 用法建议：第 1～6 章按顺序读一遍，建立"整体骨架"；第 7～8 章是逐模块精读（WebRTC 会话层、各业务模块）；第 9 章是配置层、第 10 章是测试体系；第 11～13 章用于汇报前速查与自查（含**必须提前知道的 9 处代码/文档不一致**与安全边界）。所有行号都对应本快照，代码改动后请用函数名定位。
>
> **最先要读的一条**：6.4 节末尾的警告框——"通话中开门语音在默认 8 kHz 音频配置下不会响起"。这一条会直接影响你的演示，请务必先复测或修复。

---

## 第 1 章 先建立 5 个正确的心智模型

在打开任何一个 `.c` 文件之前，先记住这 5 句话。它们是理解全部代码的钥匙。

**模型 1：这是一个"单设备自给自足"的系统。**
本项目没有云端、没有第二台服务器。ESP32-P4 自己就是网页服务器、自己就是信令服务器、自己就是媒体端点。浏览器访问的是板子的 IP。所以"信令"这种通常由服务器承担的角色，在本项目里是板子上一段 HTTPS 服务器代码（`webrtc_http_server.c`）。

**模型 2：整个项目 = 上游框架 + 一个应用目录。**
仓库里绝大部分代码不是你写的：`components/` 是 Espressif 的通用库，`solutions/` 下还有 11 个别的示例。你的作品集中在 `solutions/doorbell_local/`（约 1.1 万行自有代码），以 `solutions/doorbell_local/main/` 为业务核心。汇报时先说清这条边界，后面所有"这是什么"的问题都会变得简单。

**模型 3：三条互不相同的通信通道，千万不要混。**
- **下行（板 → 网页）**：SSE（服务器发送事件），一条 `GET /webrtc/signal` 长连接，板子主动往里推 JSON。
- **上行（网页 → 板）**：HTTP POST，`POST /webrtc/signal/post`，网页每次发一条 JSON。
- **媒体（音视频本身）**：WebRTC（SRTP over DTLS over UDP），完全不经过 HTTP。

很多人以为网页和板子用了 WebSocket，其实没有。SSE + POST 是"轻量信令"，WebRTC 才是"重媒体"。

**模型 4：应用层是"状态机 + 多线程 + 回调"的组合，不是一路顺序执行。**
板子上同时跑着：WebRTC 内部任务、BOOT 按键轮询任务、HTTP 服务器任务、SSE 推送任务、AI 推理任务、雷达 UART 任务、舵机任务、提示音任务。它们通过**互斥锁（mutex）+ 状态变量 + 队列**协作。看懂 `door_bell_state` 和四把锁，就看懂了 `webrtc.c`。

**模型 5：感知是"双证据"设计，不是单传感器。**
雷达负责"门前 3 米内有没有东西进来"，摄像头负责"那个东西是不是人"。两者都满足才自动按门铃。这是本作品和上游例程最大的设计差异，也是最容易被追问的点。

---

## 第 2 章 从零看懂一个嵌入式工程的组织方式

### 2.1 ESP-IDF 工程的三层结构

```
工程目录（solutions/doorbell_local/）
├── CMakeLists.txt          ← 工程入口，指定 IDF 构建系统
├── partitions.csv          ← Flash 分区表（nvs / app / 模型）
├── sdkconfig.defaults*     ← 芯片、外设、内存的默认配置
└── main/                   ← 默认组件（component），里面才是代码
    ├── CMakeLists.txt      ← 登记源文件 + 嵌入资源
    ├── idf_component.yml   ← 声明外部依赖（AI 模型、组件库）
    ├── Kconfig             ← 定义一个功能开关
    └── *.c / *.h / *.html  ← 业务源码
```

要点：
- `main/` 是一个 ESP-IDF "component"。`idf_component_register()` 决定哪些 `.c` 会被编译、哪些资源会被"嵌入固件"。
- `EMBED_TXTFILES` 把 `ring.aac`、`open.aac`、`join.aac`、`webrtc_test.html`、证书打进固件，编译后生成符号 `_binary_ring_aac_start` 等，代码里用 `extern` 直接访问（见 `media_sys.c:72`、`webrtc.c:101`、`webrtc_http_server.c:353`）。**这说明网页和提示音不在文件系统里，而在固件的只读数据段中。**
- `partitions.csv` 里的 `pedestrian_det` 分区（500K）是给 AI 模型用的。

### 2.2 你改了什么、继承了什么的判据

判断一个文件是否属于"本项目自有"：
- 出现在 `main/CMakeLists.txt` 的 `srcs` 列表里 → 业务源码；
- 在 `components/` 下 → 上游通用库；
- 在 `solutions/` 其他子目录 → 上游其他示例，与本次提交无关。

自有源码 22 个（21 个 C + 1 个条件编译 C++），加 1 个网页、3 段 AAC、2 个证书。

---

## 第 3 章 分层地图：硬件 → 基础设施 → 能力 → 业务 → 交互

把整个仓库画成 5 层，从下往上看。**每一层只依赖它下面的层**，这是读懂调用方向的关键。

```text
┌─ 第 5 层 人机交互 ───────────────────────────────────────────────┐
│  webrtc_test.html（中文网页：视频、按钮、雷达/视觉事件、检测框）    │
└───────────────────▲───────────────────────┬────────────────────┘
            SSE 下行 │                       │ POST 上行 + WebRTC 媒体
┌───────────────────┴───────────────────────▼────────────────────┐
│ 第 4 层 业务逻辑（本项目自己写的"产品"）                          │
│  main.c 装配 · webrtc.c 通话控制 · doorbell_* 策略/事件/状态       │
│  door_lock* 门锁 · radar_ld2450/presence_fusion 雷达              │
│  pedestrain_detect/vision_*/pedestrian_* 视觉 · multimodal_fusion │
│  doorbell_audio_render/pcm_overlay 提示音混音 · media_sys 媒体装配 │
└───────────────────▲───────────────────────┬────────────────────┘
                    │                       │
┌───────────────────┴───────────────────────▼────────────────────┐
│ 第 3 层 能力组件（上游，通用能力）                                │
│  esp_webrtc（会话/媒体协商） · esp_peer（ICE/DTLS/SRTP/SCTP）      │
│  esp_capture（采集/编码管线） · av_render（播放/渲染管线）          │
│  codec_board（板级音频/摄像头定义） · media_lib_utils（线程/锁/网络）│
└───────────────────▲───────────────────────┬────────────────────┘
                    │                       │
┌───────────────────┴───────────────────────▼────────────────────┐
│ 第 2 层 芯片外设驱动与协议栈（ESP-IDF 提供）                       │
│  esp_http_server/esp_https_server · mbedTLS · lwIP · esp_wifi    │
│  esp_video(V4L2) · esp_codec_dev(I2S/ES8311) · ledc(PWM) · UART   │
│  esp-dl（行人/人脸模型推理） · esp_hosted + esp_wifi_remote（C5）  │
└───────────────────▲───────────────────────┬────────────────────┘
                    │                       │
┌───────────────────┴───────────────────────▼────────────────────┐
│ 第 1 层 硬件：ESP32-P4 + ESP32-C5 + OV5647 + ES8311 + LD2450 + 舵机 │
└────────────────────────────────────────────────────────────────┘
```

一句话解释每层的"存在意义"：

| 层 | 解决什么问题 | 谁提供 |
| --- | --- | --- |
| 5 交互 | 让人看到画面、点到按钮 | 本项目 HTML（固件内嵌） |
| 4 业务 | 门铃的产品逻辑：谁按铃、什么时候开锁、提示什么音 | 本项目 |
| 3 能力 | 把"WebRTC 通话""采集播放"封装成几个 API | Espressif 组件 |
| 2 驱动 | 让芯片真的能收发 Wi-Fi、跑 TLS、读摄像头、输出 PWM | ESP-IDF |
| 1 硬件 | 真实世界 | 开发板与外设 |

**汇报时的价值**：这条分层让评委立刻明白"哪些是复刻、哪些是原创"。第 1～3 层是复刻基础，第 4～5 层是本次作品的主体。

---

## 第 4 章 目录与文件速查表

### 4.1 仓库顶层

| 路径 | 作用 | 你写的吗 |
| --- | --- | --- |
| `README.md` | 上游仓库说明（12 个示例总览） | 否 |
| `SOURCE_SNAPSHOT.md` | 本快照的导出说明、构建验证结论 | 是（提交材料） |
| `components/` | 7 个上游通用组件 | 否 |
| `solutions/doorbell_local/` | **本作品主体** | 部分 |
| `solutions/common/` | 公共网络与媒体接口（被 doorbell_local 引用） | 否（有适配） |
| `solutions/`（其他 11 个目录） | 上游其他示例，未参与本作品 | 否 |
| `docs/bringup/` | 移植与调试日志、测试矩阵 | 是 |
| `docs/submission/` | 提交材料 | 是 |
| `docs/superpowers/` | 设计与计划文档（开发过程留痕） | 是 |
| `tools/`、`conftest.py`、`.github/`、`.gitlab/` | 上游 CI 与工具，未参与构建 | 否 |

### 4.2 `components/` 里 7 个组件各管什么

| 组件 | 职责 | 在本项目中的角色 |
| --- | --- | --- |
| `esp_webrtc` | WebRTC 会话编排：把信令、PeerConnection、采集/播放串起来；对外只暴露 `esp_webrtc_open/start/close/query` 等少数 API | 通话主框架，`webrtc.c` 直接调用 |
| `esp_peer` | 真正的协议栈封装：ICE、DTLS、SRTP、SCTP 数据通道、RTP 变换钩子 | 由 `esp_webrtc` 内部调用；`webrtc.c` 只在关数据通道、装 RTP transformer 时直接用 |
| `media_lib_utils` | 跨平台适配层：线程、互斥锁、内存、socket、netif 的统一接口（`media_lib_*`） | 全项目的线程与锁都走它 |
| `av_render` | 播放/渲染管线：音频解码播放（I2S）、视频解码渲染（LCD） | `media_sys.c` 用它建播放器；提示音混音通过自定义 render 插入 |
| `codec_board` | 板级定义表：哪块板用哪些 I2C/I2S/PA/摄像头引脚 | `board.c` 用 `TEST_BOARD_NAME` 选择 WT99P4C5-S1 |
| `webrtc_utils` | WebRTC 辅助小工具（时间等） | 被 `esp_webrtc` 使用 |
| `esp_capture`（外部拉取，非本目录） | 采集/编码管线：摄像头+V4L2、麦克风、H.264、AAC/G711 | `media_sys.c` 与 `webrtc.c` 的第二个检测 sink 依赖它 |

> 注意：`esp_capture` 与 `esp_capture_defaults` 不在 `components/` 里，由 `idf_component.yml` 从组件仓库拉取（`managed_components/` 会在首次构建时生成，本快照不含）。

### 4.3 `solutions/doorbell_local/main/` 逐文件职责（22 个自有源文件）

行数为本快照实测，用于判断"核心在哪"。

| 文件 | 行数 | 一句话职责 | 关键接口 |
| --- | --- | --- | --- |
| `main.c` | 479 | 系统入口与总装配：初始化顺序、任务调度、雷达/视觉事件汇合 | `app_main()`、`radar_frame_received()`、`doorbell_report_vision_*()` |
| `webrtc.c` | 1479 | 通话控制中枢：WebRTC 生命周期、BOOT 按键、接听/挂断/开门、数据通道、状态机与四把锁 | `start_webrtc()`、`stop_webrtc()`、`door_bell_on_cmd()`、`doorbell_request_ring()` |
| `webrtc_http_server.c` | 604 | 板端 HTTPS 服务器与信令：页面下发、SSE 下行、POST 上行、心跳、会话替换 | `esp_signaling_get_http_impl()`、`webrtc_http_server_publish_event()` |
| `media_sys.c` | 589 | 媒体系统装配：摄像头源、麦克风源、播放器、提示音 AAC→PCM 预处理、提示音播放线程 | `media_sys_buildup()`、`media_sys_get_provider()`、`play_music()`、`play_open_door_prompt_in_call()` |
| `doorbell_audio_render.c` | 307 | 自定义音频渲染器：在 WebRTC 远端 PCM 流上叠加提示音，远端静音时用后备线程输出 | `av_render_alloc_prompt_overlay()`、`doorbell_audio_prompt_start()` |
| `pcm_overlay.c` | 121 | 纯算法：单声道 PCM 叠加、饱和限幅、进度与后备判定 | `pcm_overlay_mix_mono()`、`pcm_overlay_copy_mono()` |
| `pedestrain_detect.cpp` | 385 | 视觉检测任务：ESP-DL 行人 + 人脸存在模型、降帧保护、输出快照 | `start_pedestrian_detection()`、`set_vision_radar_focus()` |
| `vision_tracker.c` | 262 | 多目标跟踪与确认：IOU 关联、命中窗口确认、丢失清除 | `vision_tracker_update()` |
| `vision_event.c` | 107 | 视觉快照 → SSE JSON（帧坐标、分数、模型状态） | `vision_snapshot_format_json()` |
| `pedestrian_filter.c` | 113 | 行人候选空间合理性过滤（分数、面积、宽高比、位置） | `pedestrian_detection_is_plausible()` |
| `pedestrian_format_probe.c` | 47 | 探测检测输入像素格式/字节序 | `pedestrian_format_probe_*()` |
| `camera_motion.c` | 100 | 低成本的整帧亮度/变化比例统计，作为辅助运动证据 | `camera_motion_update_rgb565()` |
| `radar_ld2450.c` | 221 | LD2450 协议：30 字节帧解析、流重同步、UART 任务 | `ld2450_parse_frame()`、`ld2450_stream_feed()`、`radar_ld2450_init()` |
| `presence_fusion.c` | 170 | 雷达存在状态机：门前区域、进入/离开去抖、冷却、方向判定 | `presence_fusion_process()` |
| `multimodal_fusion.c` | 82 | 雷达 + 视觉双证据融合，同一来访只触发一次 | `multimodal_fusion_on_radar/on_vision_evidence()` |
| `door_lock.c` | 207 | 舵机：LEDC 50 Hz PWM、命令队列、开门—保持—复位 | `door_lock_init()`、`door_lock_request_open()` |
| `door_lock_state.c` | 54 | 纯状态机：LOCKED/OPENING/UNLOCKED/CLOSING/FAULT | `door_lock_state_transition()` |
| `doorbell_ring_policy.c` | 29 | 纯策略：来电是否可以接受（未就绪 / 忙 / 接受） | `doorbell_ring_policy_evaluate()` |
| `doorbell_event.c` | 39 | 雷达事件 → SSE JSON | `doorbell_radar_event_format_json()` |
| `doorbell_status.c` | 35 | 统一状态快照（在场/通话/门锁/网络/模型） | `doorbell_status_apply_vision()` |
| `board.c` | 58 | 板级初始化：选择板型、初始化 codec | `init_board()` |
| `settings.h` | 88 | 全部编译期常量：板名、分辨率、帧率、GPIO、Wi-Fi 引入 | — |

**读代码的顺序建议**（也是汇报的推荐顺序）：
`settings.h` → `main.c` → `webrtc.c` → `webrtc_http_server.c` → `media_sys.c` + `doorbell_audio_render.c` → 感知四件套（`radar_ld2450.c`/`presence_fusion.c`/`pedestrain_detect.cpp`/`vision_tracker.c`）→ `multimodal_fusion.c` → `door_lock*.c` → `webrtc_test.html`。

### 4.4 每个模块的"证据行"（汇报时打开就能指）

| 想讲的点 | 打开位置 |
| --- | --- |
| 哪些文件进入固件 | `main/CMakeLists.txt:2-16` |
| 外部依赖与版本锁定 | `main/idf_component.yml:7-33` |
| 板型、分辨率、AI 支路参数、BOOT 引脚 | `main/settings.h:21-44,68-84` |
| P4/C5/摄像头/音频板级配置 | `sdkconfig.defaults.esp32p4:1-49`、`components/codec_board/board_cfg.txt`（WT99P4C5_S1 段） |
| 初始化顺序与任务调度 | `main.c:435-479`、`main.c:361-409` |
| 雷达事件汇合与融合输入 | `main.c:141-213` |
| 视觉快照 → SSE + 融合证据 | `main.c:86-129` |
| 统一来电入口（防重入） | `webrtc.c:333-405` |
| BOOT 按键监测 | `webrtc.c:1091-1126` |
| 浏览器命令分发 | `webrtc.c:557-633` |
| 通话建立全过程 | `webrtc.c:1171-1407` |
| 通话停止与资源释放 | `webrtc.c:1423-1479` |
| SSE 会话与心跳 | `webrtc_http_server.c:107-211` |
| POST 信令分类 | `webrtc_http_server.c:214-348` |
| HTTPS 服务器参数 | `webrtc_http_server.c:376-443` |
| 提示音预处理（AAC→16 kHz PCM） | `media_sys.c:128-250` |
| 播放器与摄像头源构建 | `media_sys.c:252-398` |
| 提示音混入通话 | `doorbell_audio_render.c:147-175` |
| 混音与限幅 | `pcm_overlay.c`（全文） |
| 雷达协议与重同步 | `radar_ld2450.c`（全文）、`radar_ld2450.h:11-25` |
| 门前区域与去抖 | `presence_fusion.c`（全文） |
| 视觉推理与降帧 | `pedestrain_detect.cpp:66-228` |
| 跟踪确认阈值 | `vision_tracker.c`（全文） |
| 双证据融合 | `multimodal_fusion.c`（全文） |
| 舵机动作 | `door_lock.c:84-125`、`door_lock.h:10-15` |
| 中文网页与信令 | `webrtc_test.html:927-1007`、`:1010-1082`、`:1139-1223` |

---

## 第 5 章 开机到可用的完整启动流程

### 5.1 逐行走一遍 `app_main()`

打开 `main.c:435`。这 45 行决定了整个系统的装配顺序，**顺序本身就是设计**：

```c
void app_main(void)
{
    esp_log_level_set("*", ESP_LOG_INFO);          // 1. 日志
    media_lib_add_default_adapter();               // 2. 让 media_lib_* 绑定到 FreeRTOS/lwIP
    esp_capture_set_thread_scheduler(capture_scheduler);  // 3. 采集管线线程策略
    media_lib_thread_set_schedule_cb(thread_scheduler);   // 4. 全局线程策略
    init_board();                                  // 5. 音频 codec + 板级
    if (doorbell_webrtc_init() != 0) return;       // 6. 先建锁，再允许任何回调
#ifdef CONFIG_DOORBELL_SUPPORT_PEDESTRIAN_DETECT
    multimodal_fusion_init(...);                   // 7. 融合器
    media_lib_mutex_create(&sensor_fusion_mutex);  //    融合器自己的锁
#endif
    door_lock_init();                              // 8. 舵机 PWM
    presence_fusion_init(...);                     // 9. 雷达状态机
    radar_ld2450_init(radar_frame_received, NULL); //10. 雷达 UART（此后回调可能随时发生）
    media_sys_buildup();                           //11. 摄像头 + 播放器 + 提示音预处理
    init_console();                                //12. 串口命令行
    network_init(WIFI_SSID, WIFI_PASSWORD, network_event_handler); //13. Wi-Fi
    while (1) { media_lib_thread_sleep(2000); query_webrtc(); }    //14. 主循环探活
}
```

**为什么第 6 步必须在第 8/10 步之前？**
`doorbell_webrtc_init()` 只做一件事：创建 4 把互斥锁（`webrtc.c:136-185`）。雷达回调、BOOT 任务、HTTP 回调都可能调用同一个来电入口 `doorbell_request_ring()`，而它一进来就检查锁是否存在。**先有锁，后有回调**，否则会出现"回调已触发但同步对象还是 NULL"的竞态。

**为什么雷达初始化和媒体构建之间没有依赖？**
雷达走 UART，媒体走摄像头/I2S，互不依赖。但雷达一旦初始化，回调就可能立刻触发并去发布 SSE，所以它放在 `media_sys_buildup()` 之前或之后都可以——代码选择了"先把能触发事件的放前面"。

**第 13 步的回调是关键跳点**：

```c
static int network_event_handler(bool connected)   // main.c:420
{
    if (connected) {
        RUN_ASYNC(start, {                         // 用新线程做，避免阻塞 Wi-Fi 事件任务
            start_webrtc(NULL);
            ESP_LOGI(TAG, "Use browser to enter https://%s/webrtc/test for test", ...);
        });
    } else {
        stop_webrtc();
    }
}
```

`RUN_ASYNC` 是个宏（`main.c:216-222`），展开成"创建一个线程，执行花括号里的代码，然后销毁自己"。**为什么不能直接在事件回调里 `start_webrtc()`**？因为 `start_webrtc()` 内部要建 HTTPS 服务器、开 WebRTC、等锁，耗时较长；Wi-Fi 事件任务被阻塞会影响协议栈。

### 5.2 从头到尾的事件顺序（一次上电）

```text
上电
 → Bootloader → app_main
 → media_lib / 调度器 / 板级 / 锁 / 融合器 / 舵机 / 雷达 / 媒体 / 控制台
 → network_init：nvs、netif、event loop、esp_wifi_init、sta 配置
 → esp_wifi_start() → WIFI_EVENT_STA_START → esp_wifi_connect()
 → 连接成功后 IP_EVENT_STA_GOT_IP → network_set_connected(true)
 → network_event_handler(true) → RUN_ASYNC(start)
 → start_webrtc(NULL)：
     弹掉旧句柄 → 建 esp_webrtc 配置 → esp_webrtc_open()
     → 设置媒体提供者 → 建立 AI 检测 sink（条件编译）
     → esp_webrtc_start() → 信令实现被调用 → 启动 HTTPS 服务器
     注册 4 个 URI → sig_cfg.on_ice_info()/on_connected()
     → 启动 BOOT 按键任务 + 数据通道任务
     → 播放 join 提示音 → 启动 AI 检测任务
 → 串口打印 https://<ip>/webrtc/test
 → 浏览器打开该地址 → 下发内嵌 HTML
 → 浏览器 new EventSource('/webrtc/signal') → SSE 长连接建立
 → 浏览器 new RTCPeerConnection + createOffer
 → POST offer → 板端 on_msg → esp_peer → 生成 answer
 → answer 经 SSE 回浏览器 → ICE 候选双向交换（POST + SSE）
 → DTLS/SRTP 建链 → ESP_WEBRTC_EVENT_CONNECTED
 → 板端 H.264 视频 + 双向音频 → 浏览器 <video> 显示
```

### 5.3 线程与栈：为什么调度器要单独写一个函数

`thread_scheduler()`（`main.c:361-395`）在**每个** `media_lib` 线程被创建时被回调，按线程名定制栈和优先级。这解决了三个真实问题：

| 线程名 | 定制 | 原因（对话术） |
| --- | --- | --- |
| `venc_0` | 优先级 10，S3 上 20 KB 栈 | H.264 软编码需要大栈和稳定时间片 |
| `aenc_0` | 40 KB 栈、核心 1 | OPUS 编码栈需求大（本项目用 G711A 时可小） |
| `AUD_SRC` | 优先级 15 | 音频采集必须及时，否则断音 |
| `detect` | 24 KB 栈、优先级 8 | **曾经的故障点**：4 KB 栈 + 浮点格式化触发栈保护重启；提高栈并降优先级后连续观察 7 分钟无异常 |
| `detect_filter` | 优先级 15 | 拿帧、降采样、投递队列要及时，否则丢帧 |
| `pc_task` | 25 KB 栈、核心 1 | PeerConnection 主循环重，绑到核心 1 避开核心 0 上的媒体管线 |

`capture_scheduler()`（`main.c:397-409`）把 `esp_capture` 的线程参数转成 `media_lib` 的参数，并强制 `stack_in_ext = true`（栈分配在 PSRAM）。**P4 的片内 RAM 有限，线程栈放外部 PSRAM 才能开这么多任务。**

---

## 第 6 章 五条核心业务流程（从 API 到 API）

看懂这 5 条链路，就掌握了 80% 的代码。每条都给出"触发 → 调用 → 结果"。

### 6.1 流程一：来电（BOOT 按键 / 雷达 / 传感器融合）

三种触发源最终都汇到**同一个入口** `doorbell_request_ring(source)`（`webrtc.c:333`）。这是本项目的核心设计模式：**多来源 → 单入口 → 单状态机**。

```text
触发源 A：BOOT 按键
  key_monitor_thread (webrtc.c:1091)  每 50 ms 读 GPIO35
    └─ 电平相对"启动电平"发生变化 → doorbell_request_ring("boot")

触发源 B：雷达
  radar_uart_task (radar_ld2450.c)
    └─ ld2450_stream_feed → ld2450_parse_frame
       └─ radar_frame_received (main.c:141)
          └─ presence_fusion_process → event == ENTER_CONFIRMED
             └─ doorbell_request_ring("radar")

触发源 C：雷达 + 视觉融合（启用 AI 时取代 B）
  radar_frame_received → multimodal_fusion_on_radar(true, ring_eligible, now)
  doorbell_report_vision_snapshot (main.c:86)
    → multimodal_fusion_on_vision_evidence(evidence, ts)
       两者都满足且本次来访未响过 → request_sensor_ring("radar+vision")

                         ↓ 三源合一
  doorbell_request_ring(source)  (webrtc.c:333-405)
    1) 加锁 webrtc_api_mutex + door_bell_mutex
    2) doorbell_ring_policy_evaluate(webrtc != NULL, state == NONE)
         → NOT_READY / BUSY / ACCEPTED
    3) ACCEPTED：把 door_bell_state 置为 RINGING，并 ++ring_generation（"预占"）
    4) SEND_CMD(RING)  经信令通道发给浏览器
    5) play_tone(TONE_RING)  板端自己响铃（ring.aac）
    6) schedule_ring_stop(...)  起一个线程，4 秒后若仍是 RINGING 且代号未变，
       发 RING_STOPPED 让网页停铃；代号（generation）防止"旧请求关掉新铃声"
```

**三个必须能讲清的工程细节：**

1. **为什么要有 `ring_generation`？** 因为"4 秒后停铃"是一个延时线程，如果这 4 秒内用户挂断又重新来电，旧线程不能把新铃声关掉。代号不匹配就不发。
2. **`DOORBELL_RING_BUSY` 的意义**：正在响铃或通话中再次触发，直接拒绝并打日志。这就是"防重复呼叫"的实现，而不是靠延时去抖。
3. **板端响铃和网页响铃是两套**：板端 `play_music(ring.aac)`，网页 `<audio>` 播放 `GET /webrtc/ring.aac`（同一个文件由 HTTPS 提供，`webrtc_http_server.c:363`）。`RING_STOPPED` 是两者同步的握手，网页另有 4.5 秒超时兜底。

### 6.2 流程二：接听并建立媒体

```text
网页点击"接听" (webrtc_test.html:812)
  → sendCustomCommand('ACCEPT_CALL')
  → POST /webrtc/signal/post  {"type":"customized","data":"ACCEPT_CALL"}
  → webrtc_signal_post_handler (webrtc_http_server.c:214)
      → cJSON 解析 → msg.type = CUSTOMIZED
      → sig_cfg.on_msg(&msg, ctx)   ← 这是 esp_webrtc 注册进来的回调
      → esp_webrtc.c: signal_new_msg() (esp_webrtc.c:708)
          → rtc_cfg.peer_cfg.on_custom_data(...)
              → door_bell_on_cmd() (webrtc.c:557)

  door_bell_on_cmd 收到 "ACCEPT_CALL"：
      door_bell_change_state_locked(CONNECTING)
      schedule_peer_connection_change(handle, enable=true, expected=CONNECTING, previous=旧状态)
          → 起线程 peer_enable → esp_webrtc_enable_peer_connection(handle, true)

  esp_webrtc_enable_peer_connection (esp_webrtc.c:773)：
      pending_connect = false
      → start_peer_connection() 用 ice_info（含 ICE 角色/STUN）建 PeerConnection
      → esp_peer_new_connection() 产生 offer/answer 流程
```

**SDP/ICE 的往返路径**（理解"两个方向不对称"是重点）：

| 方向 | 载体 | 代码位置 |
| --- | --- | --- |
| 板 → 浏览器（offer/answer/candidate/customized） | SSE `data: {...}` | `webrtc_http_server_send_msg()` `:514` |
| 浏览器 → 板（offer/answer/candidate/customized） | HTTP POST JSON | `webrtc_signal_post_handler()` `:214` |
| 板收到 answer 时的额外处理 | 从 SDP 文本里逐行提取 `a=candidate:` 单独投递 | `:294-311` |
| 板发出 SDP 时的额外处理 | 把 SDP 里的候选重新逐条发一遍 | `resend_all_candidate()` `:491` |

**为什么要拆候选？** 因为简化的 HTTP 信令没有独立的 trickle-ICE 通道时，把候选嵌在 SDP 里是最省事的；两边都做了"拆/合"的兼容处理，保证候选不会丢。

**浏览器端**（`webrtc_test.html:1139-1230`）：
- `iceServers: []`——**局域网直连，不配置 STUN/TURN**（这是把接通时间从 ~30 秒降到 4～6 秒的关键改动之一）；
- `createDataChannel('channel1')` 与 `'channel2')` 两条数据通道，用于大消息收发自测；
- `ontrack` 把远端音视频挂到 `<video>`；
- `oniceconnectionstatechange` 在 `failed` 时 `restartIce()`。

**连接成功信号**：板端 `ESP_WEBRTC_EVENT_CONNECTED` → `door_bell_change_state(CONNECTED)`（`webrtc.c:1055`）。板端状态机此时才允许"通话中开门走混音路径"。

### 6.3 流程三：挂断（为什么是"确认式挂断"）

```text
网页点"挂断" (webrtc_test.html:833 requestHangup)
  → 立刻显示"正在挂断"，但**不立即关连接**
  → POST DENY_CALL
  → door_bell_on_cmd: 状态置 DISCONNECTING
      → schedule_peer_connection_change(enable=false, expected=DISCONNECTING)
          → 线程里 esp_webrtc_enable_peer_connection(false)
              → 内部 pc_close() 释放 PeerConnection、停止流
          → 成功则再发 CALL_ENDED，失败则发 CALL_END_FAILED
  → 网页收到 CALL_ENDED → finalizeHangup() (webrtc_test.html:861)
      → 关闭 PeerConnection、停止本地麦克风、清空 video.srcObject、重置 UI
  → 若 3 秒内没等到确认：显示"开发板无法结束通话，请重试"，不清状态
```

**为什么要这样绕一圈？** 早期版本网页一按挂断就自己清状态，结果出现"网页显示通话结束但视频仍在播"——因为板端连接没真的关。改成"以板端确认作为唯一结束条件"后问题消失。这是**状态一致性优先于响应速度**的典型取舍，汇报时值得强调。

**断线宽限**：`DISCONNECT_GRACE_PERIOD_MS = 15000`（`webrtc_test.html:519`）。Wi-Fi 抖动导致 ICE 短暂 `disconnected` 时，15 秒内不主动挂断；恢复即继续通话。

### 6.4 流程四：通话中开门 + 语音提示（本项目最有技术含量的一段）

```text
网页点"开门" (webrtc_test.html:830)
  → POST {"type":"customized","data":"OPEN_DOOR"}
  → door_bell_on_cmd 分支 (webrtc.c:574)
      ├─ door_lock_request_open()：只把请求投进队列，立刻返回
      │     door_lock_task (door_lock.c)：
      │       状态 LOCKED → OPENING → 2500 us 脉宽 → 等 500 ms
      │       → UNLOCKED → 保持 5000 ms → CLOSING → 500 us → 等 500 ms → LOCKED
      │       每次状态变化通过 door_lock_set_state_callback 回调
      │         → door_lock_state_changed (webrtc.c:407)
      │             → SEND_CMD(DOOR_OPENING / DOOR_OPENED / DOOR_CLOSING / DOOR_LOCKED / DOOR_FAILED)
      │             → 网页据此显示中文提示并禁用按钮
      └─ 语音提示分三条路：
           通话中 (CONNECTED) → play_open_door_prompt_in_call()
           连接中/响铃中   → 不播提示音（避免抢音频通道）
           空闲           → play_tone(TONE_OPEN_DOOR)（走普通播放器）
```

**核心技术点：`pcm_overlay` + 自定义 audio render。**

问题的本质：`av_render` 的音频输出（I2S → ES8311）是**独占**的。通话时远端音频正在往里写；此时再让 `play_music()` 打开一路 AAC 流去播放，就会互相打断——这就是早期"开门语音只能在挂断后听到"的原因。

解法（`doorbell_audio_render.c`）：
1. 启动时先用 `av_render_alloc_prompt_overlay()` 包一层自定义 render（`:223`），它内部仍然持有真正的 I2S render，但拦截了 `write`；
2. 开门语音在 `media_sys_buildup()` 阶段就被**离线解码**成 16 kHz 单声道 PCM 常驻内存（`media_sys.c:152 prepare_open_door_prompt()`，自己解析 ADTS 头逐帧解码 + 重采样）；
3. 通话中调用 `doorbell_audio_prompt_start()` 把这段 PCM "装载"进叠加器（`:252`）；
4. 远端音频每写一帧，`prompt_render_write()`（`:147`）先调 `pcm_overlay_mix_mono()` 把提示音**逐样本加到远端 PCM 上**并做 16 位饱和限幅，再交给真正的 I2S render；
5. 如果远端长时间没有音频（例如对方静音），`prompt_fallback_worker`（`:38`）在检测到 40 ms 静音后自己输出静音帧承载提示音，保证提示音不会因为"远端没声音"而卡住。

**汇报话术**：*"我们没有新增一路音频通道，而是在 WebRTC 的音频渲染回调里做了一次样本级混音，用饱和限幅保证不削顶，所以通话不会中断、提示音也不会延迟到挂断之后。"*

> **⚠️ 讲这句之前必须先做一件事**（这是全篇最重要的一条自查）
>
> 混音路径有一个前置条件：当前音频必须是 **16000 Hz、1 或 2 声道、16 bit**（`doorbell_audio_render.c:134-137` 的 `compatible` 判断）。而本项目默认构建**没有定义 `WEBRTC_SUPPORT_OPUS`**，通话音频走的是 **G711A / 8000 Hz / 单声道**（`webrtc.c:1226-1228`）。
>
> 实测日志印证了这一点：一次真实通话里渲染器打开的是 8000 Hz（`docs/bringup/logs/webrtc-aac-assets-runtime-20260902.log:454,463` 的 `Get samplerate 8000` / `I2S_RENDER: open channel:1 sample_rate:8000`），而上一段 16 kHz 只出现在启动阶段的 `join.aac`（同文件 `:212,214`，采样率 16000）。
>
> 由此推出两个后果：
> 1. `pcm_overlay_mix_mono()` 分支**不会执行**（`compatible == false`）；
> 2. 兜底线程在 `!compatible` 时直接 `continue`，**也不会输出**（`doorbell_audio_render.c:56-60`）。
>
> 也就是说：**在默认 G711A 构建下，通话中点开门不会有任何语音提示**；而且 `play_open_door_prompt_in_call()` 仍返回 0，串口不会有任何警告——这属于"静默失效"，最难在演示现场发现。
>
> 开发日志里"新增 PCM Overlay 后通话中能听到开门播报"的记录（`01_开发日志.md:112`），与当时的实机验收状态并不一致：2026-09-08 的验证记录把"通话中听到口头提示"明确列为**待用户实机确认**（`docs/bringup/logs/2026-09-08-chinese-ui-prompt-fallback.md:42-53`，期望日志序列 `Prompt playback armed` → `Prompt mixed...` 或 `Prompt fallback output...` → `Prompt playback completed`，尚待勾选）。
>
> **提交前必须做的三件事**：
> 1. 按最终固件在实机上实测"通话中点开门"，看串口是否出现上面三段日志中的**后两段**；
> 2. 选一个修法：① 启用 `WEBRTC_SUPPORT_OPUS`（通话走 16000 Hz，混音分支直接生效）；② 扩展 `compatible` 判定到 8 kHz 并加对应重采样；③ 把 `open.aac` 预处理目标改成 8 kHz，让 8 kHz 路径也能混音（改 `media_sys.c:163-167`）；
> 3. 修完后再决定文档与汇报口径。
>
> **在没复测、没修复之前，汇报里不要说"通话中能听到开门语音"**。可以说："开门播报做了预解码 PCM 输出通道，目标是与通话音频共用同一条 I2S 输出；当前默认 8 kHz 音频配置下该路径需要复测/修正。"

### 6.5 流程五：感知链路（雷达 + 视觉）与规则"双证据"

**雷达侧**（`radar_ld2450.c` + `presence_fusion.c`）：

```text
UART1 @256000 8N1, RX=GPIO4 / TX=GPIO5
  → radar_uart_task 读串口字节
  → ld2450_stream_feed：滑动缓冲区，从任意分片位置重新同步帧头
  → ld2450_parse_frame：校验长度/帧头(AA FF 03 00)/帧尾(55 CC)
       每帧 4 头 + 3×8 目标 + 2 尾 = 30 字节
       每个目标：x_mm、y_mm、speed_cm_s、距离分辨率
  → radar_frame_received (main.c:141)
       presence_fusion_process (presence_fusion.c)
         区域：X ∈ [-1500, 1500] mm，Y ∈ [300, 3000] mm（门前 3 米、宽 3 米）
         状态机：CLEAR → ENTERING(持续 1 s) → PRESENT → EXITING(持续 2 s) → CLEAR
         冷却：离开后再进入需等 10 s（防止门口徘徊反复触发）
         方向：按速度带死区判定 approaching / stationary / leaving
       → 事件序列化为 JSON（doorbell_event.c）→ SSE → 网页雷达事件列表
```

**视觉侧**（`pedestrain_detect.cpp` + `vision_tracker.c`）：

```text
detect sink：320×180 @2 FPS，RGB565LE（独立于 640×480@15 的 H.264 通话支路）
  filter_task：从 capture 拿帧 →（camera_motion 统计整帧变化）→ 投递队列
  detecting_task：
    行人模型（pedestrian_detect 组件）→ 每个结果先过 pedestrian_detection_is_plausible
         （分数、面积比例、宽高比、位置合理性）
    → 若"雷达正关注门前"或"没有可信行人框"，再跑人脸存在模型（近距离辅助证据）
        这一条由 set_vision_radar_focus() 控制，雷达进区时置 true
    → 最多保留 3 个候选，交给 vision_tracker_update()
        关联：与已有轨迹做 IOU 匹配
        确认：窗口内命中次数达标才 confirmed
        清除：连续多帧丢失才删除轨迹
    → vision_snapshot_t（含 source_width/height、每个目标的框与分数、两个模型状态）
    → 回调 vision_snapshot_received (webrtc.c:469) → doorbell_report_vision_snapshot (main.c:86)
         ├─ vision_snapshot_format_json → SSE（网页画检测框与置信度）
         └─ 提取证据等级：行人 > 人脸 → multimodal_fusion_on_vision_evidence()
    → 推理明显变慢时自动降帧，保护通话时延
```

**融合判定**（`multimodal_fusion.c`，全文只有 82 行，是"少代码高价值"的典型）：

```c
request_ring_if_fused():
    雷达在区(radar_present) && 本次进入允许响铃(radar_ring_eligible)
    && 本次来访尚未响过(!ring_emitted_for_visit)
    && 视觉证据新鲜(now - last_vision_ms <= 2000 ms)
  → 返回 true，并把 ring_emitted_for_visit 置位
```

- **2 秒证据窗口**：`vision_valid_ms = 2000`。雷达先进区、人再走进画面，或者反过来，都能在 2 秒内配对成功。
- **一次来访只响一次**：`ring_emitted_for_visit` 在雷达"离开"时清零。
- **为什么不用单传感器**：纯雷达会被门外经过的物体误触发；纯视觉受光线和分辨率影响。双证据把误触发概率显著压低。**注意措辞：这是"降低误触发"，不能宣称"消除误报"。**

**汇报时必须守住的事实边界**（评委最爱追问）：
- 摄像头只判断"有没有人 / 有没有人脸存在"，**不做身份识别**；
- 页面上显示的百分比是**该框的模型置信分数**，不是系统准确率；
- LD2450 输出最多 3 个**二维目标点**，不是点云、不是俯视图；
- 网页"检测事件数"是**累计历史条数**，不是当前人数。

### 6.6 三条链路的"信号量清单"（背下这几个数字，回答会很硬）

| 参数 | 值 | 位置 |
| --- | --- | --- |
| LD2450 串口 | UART1，256000 8N1，RX=GPIO4，TX=GPIO5 | `radar_ld2450.h:22-24` |
| LD2450 帧 | 30 B = 4 B 头（AA FF 03 00）+ 3×8 B 目标 + 2 B 尾（55 CC），无校验和 | `radar_ld2450.h:11-17`、`radar_ld2450.c:13-16` |
| 目标字段 | X/Y（mm）、速度（cm/s）、距离分辨率（mm）；小端符号幅值编码，全 0 槽位=空 | `radar_ld2450.c:18-27` |
| 雷达离线判定 | 连续 2000 ms 无有效帧 → 打离线告警，**不伪造事件** | `radar_ld2450.c:168-200` |
| 门前区域 | X ∈ ±1500 mm，Y ∈ 300～3000 mm（含边界） | `presence_fusion.c:5-14` |
| 进入/离开确认 | 1000 ms / 2000 ms；离开后冷却 10000 ms；方向死区 ±10 cm/s | 同上 |
| 视觉采集支路 | sink 1，RGB565LE，320×180 @2 FPS | `settings.h:42-44`、`webrtc.c:1304-1328` |
| 行人/人脸分数阈值 | 0.70 / 0.75（跟踪器）；合理性过滤面积 5‰～850‰ | `vision_tracker.c`、`pedestrian_filter.c:36-55` |
| 跟踪确认 | IOU ≥ 25% 关联，3 槽位；4 帧窗口内 ≥3 命中确认，连续 3 帧丢失清除 | `vision_tracker.c:164-278` |
| 融合窗口 | 视觉证据有效期 2000 ms；一次来访只响一次 | `multimodal_fusion.c:31-39` |
| 舵机 | GPIO32，LEDC 50 Hz / 14 bit；锁定 500 μs，打开 2500 μs；动作等待 500 ms，保持 5000 ms | `door_lock.h:10-15`、`door_lock.c:84-126` |
| 铃声时长 | 板端 4000 ms 后发 `RING_STOPPED`；网页 4.5 s 兜底 | `webrtc.c:46`、`:290-331` |
| 通话音频 | G711A，8000 Hz，单声道 | `webrtc.c:1226-1228` |
| 通话视频 | H.264，640×480，15 FPS，仅发送 | `settings.h:30-33`、`webrtc.c:1231-1238` |
| 断线宽限 | 15000 ms | `webrtc_test.html:519` |

---

## 第 7 章 WebRTC 会话层：esp_webrtc 是什么、你用它做了什么

### 7.1 `esp_webrtc` 帮你省掉了什么

如果不看 `components/esp_webrtc`，很容易误以为"WebRTC = 一堆 UDP 打洞代码"。实际分工是：

| 层次 | 谁负责 | 具体内容 |
| --- | --- | --- |
| 会话编排 | `esp_webrtc` | 把"信令实现 + PeerConnection 实现 + 采集/播放 + 编解码"组装成一件事，提供 `esp_webrtc_open/start/enable_peer_connection/close/query` |
| 协议实现 | `esp_peer` | ICE/STUN、DTLS、SRTP、SCTP 数据通道、RTP 变换钩子 |
| 信令实现 | `webrtc_http_server.c`（本项目） | `esp_peer_signaling_impl_t` 的 `start/send_msg/stop` 三个函数 |
| 媒体实现 | `esp_capture` + `av_render` | 采集编码/解码播放 |

`start_webrtc()` 里那段配置结构（`webrtc.c:1218-1255`）就是"把上面四块拼起来"的清单：

```c
esp_webrtc_cfg_t cfg = {
    .peer_cfg = {
        .audio_info = { G711A, 8000, 1 },          // 或 OPUS 16000/2（WEBRTC_SUPPORT_OPUS）
        .video_info = { H264, 640, 480, 15 },      // 来自 settings.h
        .audio_dir  = SEND_RECV,                   // 双向音频
        .video_dir  = SEND_ONLY,                   // 板 → 浏览器单向视频
        .on_custom_data = door_bell_on_cmd,        // 浏览器命令入口
        .on_channel_open/on_data/on_channel_close = ...,  // 数据通道
        .enable_data_channel = true,
        .manual_ch_create    = true,               // 不自动建通道（浏览器是 SCTP 客户端）
        .no_auto_reconnect   = true,               // 信令一连上不自动开会话
        .extra_cfg = &peer_cfg,                    // agent_recv_timeout = 500
    },
    .signaling_cfg = { .signal_url = url },        // NULL → 用本地 HTTP 信令
    .peer_impl      = esp_peer_get_default_impl(),
    .signaling_impl = esp_signaling_get_http_impl(),  // ← 你写的那个
};
```

### 7.2 `no_auto_reconnect` + `enable_peer_connection`：门铃"必须有人接听"的实现

这是本项目相对上游例程的两处关键增强，也是理解"为什么浏览器要显示接听/拒接按钮"的核心。

```text
start_webrtc():
   esp_webrtc_enable_peer_connection(handle, false)   // webrtc.c:1336
        → esp_webrtc 内部 pending_connect = true
   esp_webrtc_start()
        → 信令 start：起 HTTPS 服务器，on_ice_info()/on_connected() 被调用
        → signal_ice_received(): 看到 pending_connect → 只打印
             "Pending connection until user enable"，不建 PeerConnection
        → signal_connected(): no_auto_reconnect && pending_connect → 直接返回
             （否则会自动 esp_peer_new_connection 并发 offer）

浏览器点"接听" → ACCEPT_CALL → schedule_peer_connection_change(true)
   → 线程里 esp_webrtc_enable_peer_connection(handle, true)
        → pending_connect = false；signaling_connected 已为真
        → esp_peer_new_connection() → 板端生成 SDP → send_msg → SSE → 浏览器
```

**汇报话术**：*"官方例程是信令一连上就自动建连，也就是'设备永远在线可看'。门铃的语义相反——必须有人在门口按铃、由主人接听。所以我把自动重连关掉，改成由 ACCEPT_CALL 显式触发建连；这样板子不会在没人呼叫时一直被浏览器看着。"*

### 7.2.1 链路里两个"看起来矛盾"的地方，提前准备好解释

细读代码会发现两处与"局域网直连"叙事不完全一致的地方，评委如果较真会问：

1. **板端信令仍声明了一个公网 STUN 服务器**：
   `webrtc_http_server.c:477-480` 里 `ice_info` 的 `stun_url = "stun:stun.l.google.com:19302"`，同时 `is_initiator = true`（即 ICE 角色为 controlling）。
   **如何解释**：公网 STUN 只影响"服务器派生候选"的收集，局域网内真正连通靠的是主机候选；ICE 会在候选对里优先选可用的本地路径，所以它不会阻塞局域网建连。真正让接通变快的是浏览器侧 `iceServers: []`（不再等公网 STUN 回包）以及关闭浏览器本地上行采集。**如果下次迭代要彻底干净，可以把这里的 `stun_url` 置空**（`esp_webrtc` 在 `stun_url` 为空时会退回配置里的服务器列表，`components/esp_webrtc/src/esp_webrtc.c:646-650`）。

2. **`start_webrtc(char *url)` 的 `url` 参数实际没有被使用**：
   `signaling_cfg.signal_url = url`（`webrtc.c:1251`），但本项目用的是自研 HTTP 信令实现，服务器地址由板子自己决定，`url` 始终传 `NULL`。
   **如何解释**：这是保留下来的上游接口形态——上游示例用它指向公网信令服务器（AppRTC/Janus/KVS），本项目改成板内自建信令后，这个参数自然不再需要，保留是为了不破坏上游 API 形状。

### 7.3 `webrtc.c` 里的 4 把锁与 1 个状态机

| 锁 | 保护对象 | 出现位置 |
| --- | --- | --- |
| `door_bell_mutex` | `door_bell_state`、`webrtc` 句柄、工作线程开关 | 几乎每个函数 |
| `webrtc_api_mutex` | 对 `esp_webrtc_*` 的调用序列化 | `start/stop/request_ring/close_data_channel` |
| `webrtc_lifecycle_mutex` | `start_webrtc` / `stop_webrtc` 互斥，防止并发启停 | `webrtc.c:1183, 1431` |
| `data_channel_mutex` | `user_ch[]` 数据通道槽位 | `add/remove/clear_channel` |

状态机（`webrtc.c:48-54`）：

```text
NONE ──request_ring──► RINGING ──ACCEPT_CALL──► CONNECTING ──EVENT_CONNECTED──► CONNECTED
  ▲                       │                          │                             │
  │                       └──────DENY_CALL───────────┴────────DENY_CALL────────────┘
  │                                        ▼
  └──────── EVENTS(DISCONNECTED/CONNECT_FAILED) ── DISCONNECTING ──disable 成功──► NONE
```

三条防御性设计，值得单独讲：
1. **句柄校验**：`door_bell_change_state(source_handle, ...)` 只在 `webrtc == source_handle` 时才改状态（`:264-271`）。防止"上一次通话的旧事件"污染新会话。
2. **过渡态保护**：`DISCONNECTING` 期间收到 `CONNECTED` 会被忽略并打日志（`:266-268`），避免拆连接过程中又被拉回去。
3. **失败回滚**：`restore_peer_change_state_locked()`（`:275-288`）在"启停 PeerConnection 失败"时把状态退回原值；如果原状态是 `RINGING`，还会重新播放铃声，不让用户面对一个"既不响也没提示"的死状态。

### 7.4 数据通道：为什么代码里有一条"自测"通道

`webrtc.c:762-833` 的 `data_thread_hdlr` 每秒往 `channel1/channel2` 发一条 8 KB 字符串（`Send to <label> count N` + 重复填充字符），浏览器侧 `verify_data()`（`:842-859`）校验"填充字符是否等于计数的函数值"。用途是**数据通道可靠性自测**（丢包、重排、大消息分片），串口命令行 `close <idx>` 可以手动关通道复现异常。它不是门铃业务功能，汇报时一句话带过即可，**不要把它讲成"业务数据通道"**。

真正走数据通道以外路径的业务消息，全部走**信令的 customized 通道**（因为要保证在通话未建立时也能送达）。

### 7.5 RTP 变换器：一个调试钩子，不是功能

`webrtc.c:905-1050` 实现了发送/接收两侧的 RTP 包文本变换（在 RTP 载荷前后插入长度与 `TAIL_<n>` 标记），默认关闭，只能通过 `customized` 命令 `ENABLE_RTP_TRANSFORMER` 打开，浏览器侧还要开 `encodedInsertableStreams`。作用是在真实链路上验证"RTP 变换 API + 可插入流"能否工作（上游示例特性）。**汇报时如被问到，回答"这是上游提供的 RTP 变换能力验证，本作品的音视频不依赖它"。**

---

## 第 8 章 逐模块精读要点

### 8.1 `main.c`：装配者与事件汇合点

三个职责：
1. **装配**（`app_main`，见第 5 章）；
2. **线程策略**（`thread_scheduler` / `capture_scheduler`，见 5.3）；
3. **事件汇合**：把"雷达回调"和"视觉回调"这两个外来事件转成（a）SSE 消息、（b）融合输入、（c）来电请求。

关键实现细节：
- 融合器有自己的互斥锁 `sensor_fusion_mutex`，因为雷达回调（UART 任务）和视觉回调（AI 任务）是**两个不同线程**，都会改融合器状态（`main.c:56-84`、`:112-119`）。
- 启用 AI 时，雷达的响铃逻辑被替换：`#ifdef CONFIG_DOORBELL_SUPPORT_PEDESTRIAN_DETECT` 分支走融合，`#else` 分支保留"纯雷达直接响铃"（`main.c:198-212`）。这既方便对比，也保证关掉 AI 开关时功能不缺失。

### 8.2 `webrtc_http_server.c`：板上的"信令服务器"

**它本质上是一个 `esp_peer_signaling_impl_t` 实现**（`:596-604`）：`start` 建服务器和队列，`send_msg` 把板端消息塞进队列，`stop` 清理。

服务器参数（`:376-407`）：
- `httpd_ssl_config_t` + 内嵌自签名证书/私钥；
- `max_uri_handlers = 16`，`stack_size = 8192`；
- `max_open_sockets = 7`（默认 4 不够：页面 + SSE + 铃声 + 浏览器探测连接会挤满）；
- `lru_purge_enable = true`、收发超时 5 秒；
- 主动把 `esp-tls-mbedtls` / `esp_https_server` / `httpd` 日志降到 NONE，因为浏览器会发大量"预探测"TLS 连接，会产生刷屏的预期报错。

4 个 URI：

| URI | 方法 | 作用 |
| --- | --- | --- |
| `/webrtc/test` | GET | 下发内嵌的 `webrtc_test.html`（`text/html; charset=utf-8`） |
| `/webrtc/signal` | GET | **SSE 下行**：`text/event-stream`，板 → 浏览器 |
| `/webrtc/signal/post` | POST | **上行**：offer/answer/candidate/bye/customized |
| `/webrtc/ring.aac` | GET | 网页铃声文件（`Cache-Control` 一年） |

**SSE 的三条队列**（`:32-34`）：

| 队列 | 长度 | 语义 | 丢弃策略 |
| --- | --- | --- | --- |
| `signaling_queue` | 10 条 `char*` | SDP / candidate / bye / customized（信令本身） | 满则阻塞 100 ms 后丢并告警 |
| `telemetry_queue` | 16 条 256 B | 雷达事件等"必须看到"的事件 | 满则丢最旧一条 |
| `vision_queue` | **1 条** 1024 B | 最新视觉快照 | `xQueueOverwrite` 覆盖，永远只保留最新 |

**为什么视觉快照只留 1 条？** 视觉 2 FPS 持续产生数据，如果排队就会越积越久、画面上的框会严重滞后。所以设计成"只保留最新一帧状态"，用 `sequence` 号判断是否是新数据（`:74-92`、`:141-144`）。这是实时系统里很典型的"**丢旧保新**"策略。

**单会话 + 刷新替换**：全局只有一个 `event_stream`。新的 GET 进来时把旧的 `stopping = true`（`:185-190`），旧推送任务退出并释放，新页面立刻接管。这修掉了"刷新网页后第一次按 BOOT 没反应"的问题。

**心跳**：每 5 秒发 `{"type":"heartbeat"}`，写失败就认为对端消失并结束任务（`:158-166`）。

**自定义命令字表**（板→网页，`webrtc.c:26-39`；网页→板），完整清单：

| 方向 | 命令 | 含义 |
| --- | --- | --- |
| 板→网页 | `RING` / `RING_STOPPED` | 来电 / 铃声结束（4 秒后） |
| 板→网页 | `DOOR_OPENING` / `DOOR_OPENED` / `DOOR_CLOSING` / `DOOR_LOCKED` / `DOOR_FAILED` | 门锁状态回执 |
| 板→网页 | `CALL_ENDED` / `CALL_END_FAILED` | 挂断结果确认 |
| 板→网页 | `PEDESTRIAN_DETECTED` | **已停用**：检测回调配置为 NULL，实际视觉事件统一走 `vision_state` JSON（见第 13 章第 2 条） |
| 网页→板 | `ACCEPT_CALL` / `DENY_CALL` | 接听 / 拒接挂断 |
| 网页→板 | `OPEN_DOOR` | 开门 |
| 网页→板 | `ENABLE_RTP_TRANSFORMER` / `DISABLE_RTP_TRANSFORMER` | 调试开关 |

### 8.3 `media_sys.c`：把"设备"变成"媒体提供者"

`media_sys_buildup()` 做四件事（`:400-415`）：
1. 注册默认编解码器（`esp_video_enc/dec_register_default`、`esp_audio_enc/dec_register_default`）；
2. **预处理开门提示音**（`prepare_open_door_prompt`，`:152-250`）：读内嵌 `open.aac` → 解析 ADTS 头（采样率索引表在 `:131-134`）→ 逐帧 `adec_decode` → 重采样到 16 kHz 单声道 → 存进可增长的 PCM 缓冲；末尾 1 个 `0x00` 字节被容忍，其他残留字节视为错误；
3. 建采集系统（`:342-360`）：摄像头源（P4 走 `esp_video_init` + V4L2 `/dev/video0`，2 个缓冲）+ 麦克风源，同步模式 `ESP_CAPTURE_SYNC_MODE_AUDIO`；
4. 建播放系统（`:362-398`）：音频 render 用 `av_render_alloc_prompt_overlay()`（**这是本项目替换上游的关键点**），视频 render 用 LCD（**本板未接屏幕**：doorbell_local 中没有任何 `board_lcd_init()` 调用，`board_get_lcd_handle()` 返回 NULL，因此 `video_render == NULL`，日志会打印 `Video render not set, stream is skipped`，代码允许失败继续），FIFO 大小分别为音频 4 KB/6 KB、视频 500 KB。

`media_sys_get_provider()` 把这两个句柄交给 `esp_webrtc`（`webrtc.c:1265-1267`）。

另有三个"业务入口"：`play_music(data, size, duration)`（`:544`，起 `music_player` 线程播放 AAC，`duration>0` 表示限时循环）、`stop_music()`（`:564`，置标志并等线程退出）、`test_capture_to_player()`（`:424`，串口 `rec2play` 命令，本地环回自测采集与播放）。

### 8.3.1 语音数据的完整来回路径（双向音频怎么走）

| 方向 | 路径 |
| --- | --- |
| 上行（门口说话 → 浏览器） | 板载麦克风 → ES8311 ADC → `esp_capture` audio dev src（`media_sys.c:347-350`）→ G711A 编码（`aenc_0`）→ sink 0 → `esp_webrtc` 发送线程 → `esp_peer` 打包 SRTP → 浏览器 |
| 下行（浏览器说话 → 板载扬声器） | 浏览器 → SRTP → `esp_peer` → `esp_webrtc` 的 `pc_on_audio_data` → `av_render_add_audio_data` → G711A 解码 → **prompt overlay（可选混音）** → i2s_render → `esp_codec_dev_write` → ES8311 DAC → 扬声器 |

注意下行路径里 **prompt overlay 正好夹在"解码之后、写 I2S 之前"**——这就是为什么能在播报的同时不打断通话：它只是在那一段 PCM 上加了一次运算。提示音播放（`play_music`）走的是另一条完全独立的 AAC 解码链，两条链共用同一个 I2S 输出，所以同时开会有冲突，这也是提示音必须走 overlay 而不是 play_music 的原因。

### 8.4 `door_lock.c` / `door_lock_state.c`：执行器

- PWM：LEDC 低速模式、TIMER_3、CHANNEL_7、14 位分辨率、50 Hz、GPIO32（`door_lock.c:13-18`）；
- 脉宽 → 占空比换算 `pulse_us_to_duty()`（`:36-41`），开机即输出 500 μs（机械锁定位置）；
- 请求只入队（`door_lock_request_open()`），由独立 `door_lock_task` 顺序执行"开 → 保持 5 s → 关"（`:84-125`），**重复点击是幂等的**；
- 每次状态变化通过回调通知 `webrtc.c`，转成 customized 命令推给网页；
- 纯状态机在 `door_lock_state.c`（54 行、无硬件依赖），因此可以在 PC 上用 C 单元测试覆盖（`tests/door_lock_state_test.c`）。

**必须说清的边界**：舵机没有位置/电流反馈，`UNLOCKED` 只表示"命令已发出且动作时间已过"，**不能证明锁舌到位**。

### 8.5 `radar_ld2450.c` / `presence_fusion.c`：传感器

- 帧格式常量在 `radar_ld2450.h:11-17`（4 头 + 3×8 目标 + 2 尾 = 30 字节），串口参数在 `:22-24`（256000、GPIO4/5）；
- 解析器分三层：`ld2450_parse_frame`（单帧校验与解析）、`ld2450_stream_feed`（滑窗重同步，能吃任意分片和噪声）、`ld2450_should_capture_sample`（采样辅助）；
- `presence_fusion.c` 是纯逻辑：区域判定 `presence_fusion_target_in_zone()`、方向判定 `presence_fusion_classify_direction()`（带死区）、主状态机 `presence_fusion_process()`；
- 关键常量集中在 `presence_fusion_default_config()`：区域 X[-1500,1500]、Y[300,3000] mm，进入 1 s 确认，离开 2 s 确认，冷却 10 s。

### 8.5.1 板级适配：`board.c` + `board_cfg.txt` + `codec_init`

这一层是"复刻"的核心工作量之一，被问"你怎么把官方例程搬到这块板上的"时这样讲：

```text
init_board()                     (board.c:45-58)
  → set_codec_board_type("WT99P4C5_S1")      用板名去查板级表
  → codec_init_cfg_t cfg = { .reuse_dev = false }
  → init_codec(&cfg)                          配置 codec 芯片与 I2S
```

板级表 `components/codec_board/board_cfg.txt:81-95` 里 WT99P4C5_S1 段的关键信息：

| 项 | 值 | 含义 |
| --- | --- | --- |
| `i2c` | SDA 7 / SCL 8 | 控制 ES8311 的 I2C 总线 |
| `i2s` | mclk 13 / bclk 12 / ws 10 / dout 9 / din 11 | 音频数据引脚 |
| `in_out` | codec `ES8311`，pa 53，use_mclk 1，pa_gain 6 | **单颗 ES8311 同时做 DAC 与 ADC**（不是"ES8311 + ES7210"这种双芯片方案） |
| `camera` | `type: mipi` | 走 MIPI-CSI（OV5647） |

`reuse_dev = false`（`board.c:50`）的含义：**播放和录音使用两套独立的 `esp_codec_dev` 句柄**，因此可以分别用不同采样率（`codec_init.c:478-486`）——这对"通话 16 kHz + 提示音 16 kHz + 铃声 44.1 kHz"的混合场景是必要的。

三个预录提示音的实际参数（由 AAC 头解析得到）：

| 文件 | 采样率 | 声道 | 时长 | 用途 |
| --- | --- | --- | --- | --- |
| `ring.aac` | 44.1 kHz | 单声道 | 约 1.23 s | 板端来电铃声（循环到 4000 ms） |
| `open.aac` | 24 kHz | 单声道 | 约 2.99 s | 开门播报（预解码为 16 kHz PCM） |
| `join.aac` | 16 kHz | 单声道 | 约 2.05 s | 启动/接通提示音 |

### 8.6 视觉四件套

| 文件 | 输入 | 输出 | 要点 |
| --- | --- | --- | --- |
| `pedestrain_detect.cpp` | 320×180 RGB565LE 帧 | `vision_snapshot_t` | ESP-DL 行人 + 人脸存在；雷达聚焦时也跑人脸；推理慢自动降帧（文件名 `pedestrain` 是历史拼写，未改） |
| `pedestrian_filter.c` | 单个候选框 | 是否合理 | 分数、面积比例（千分比整数运算）、宽高比、位置 |
| `camera_motion.c` | RGB565 帧 | 变化像素千分比 | 采样上限 1200 点，低成本辅助证据 |
| `vision_tracker.c` | 多候选 | 带 track_id 的确认目标 | IOU 关联、命中窗口确认、丢失计数清除；确认计数时排除"落在人体框内的人脸"避免重复计数 |

`vision_event.c` 负责把这些变成网页能画的 JSON（含 `source_width/height` 供前端按比例映射框坐标）。

### 8.7 `multimodal_fusion.c`：82 行的决策核心

已在 6.5 讲完。补充一个"为什么这样切分"的优点：融合逻辑**不依赖任何硬件和 RTOS**，只有纯函数和结构体，因此可以在 PC 上做完整的状态组合测试（`tests/multimodal_fusion_test.c` 覆盖"雷达先/视觉先""证据过期""单次来访"等组合）。

### 8.8 三个"纯逻辑小模块"的重要性

`door_lock_state.c`(54) + `doorbell_ring_policy.c`(29) + `multimodal_fusion.c`(82) = 165 行，却承担了门锁、来电准入、自动触发三个关键决策。它们被刻意写成**不依赖硬件、不依赖 FreeRTOS** 的纯函数，所以能用宿主机测试（不需要烧板）覆盖。**这是本项目的测试策略核心，汇报时值得作为一个"工程方法"亮点讲。**

### 8.9 一个必须如实说明的点：`doorbell_status.c` 目前没有接线

`doorbell_status.h/.c` 定义了一套统一状态快照（在场/通话/门锁/网络/两个模型状态），但：
- 生产代码中**没有调用** `doorbell_status_init()` / `doorbell_status_apply_vision()`；
- 网页上的状态显示实际来自 SSE 的 `vision_state` 和 `radar_event`，以及 `customized` 命令字（`DOOR_OPENING`、`CALL_ENDED` 等）；
- 结构体里的 `call` / `lock` / `network` 字段除初值外从未被赋值，也没有 JSON 序列化函数。

**汇报建议**：把它讲成"**预留的统一状态聚合模块**，目前已实现并有单元测试，下一步用于给网页提供一条 `{"type":"status"}` 总状态事件"。**不要说"网页状态由 doorbell_status 统一提供"**，那与代码不符——评委只要搜一次函数名就能发现。

### 8.10 `webrtc_test.html`：前端结构速览

1566 行的单文件页面，包含 HTML + CSS + JS，由固件直接下发。分块如下：

| 区块 | 行 | 内容 |
| --- | --- | --- |
| UI 结构 | `:410-482` | 视频区、状态条、接听/挂断/开门按钮、事件面板 |
| 全局状态 | `:490-519` | `signalingUrl='/webrtc/signal'`、`signalingPostUrl='/webrtc/signal/post'`、`DISCONNECT_GRACE_PERIOD_MS=15000`、各 UI 元素引用 |
| 铃声 | `:539-590` | `<audio>` 播放 `/webrtc/ring.aac`、4.5 秒兜底超时 |
| 事件列表 | `:592-660` | 累计历史（含雷达/行人文案）、`updateEventCount()` |
| 雷达与视觉渲染 | `:636-757` | `translateRadarZone()`、`drawVisionOverlay()`（按 `source_width/height` 等比映射框）、`markVisionStale()`、模型状态中文标签 |
| 按钮与通话控制 | `:803-924` | 接听、开门、挂断（等待板端确认）、15 秒断线宽限、`sendCustomCommand()` |
| SSE 订阅 | `:927-1007` | `EventSource` + 消息路由 + 出错 5 秒后重连 |
| 命令处理 | `:1010-1082` | `handleCustomCommand()` 的中文状态提示与按钮禁用逻辑 |
| WebRTC | `:1139-1400` | `iceServers: []`、两条 data channel、ICE 状态处理、`ontrack`、offer/answer/candidate 处理 |
| 数据通道自测 | `:1484-1520` | 大消息收发与校验（配合板端 `data_thread_hdlr`） |

前端设计上的三个亮点：**确认式挂断**、**15 秒断线宽限**、**视觉框按原始分辨率等比映射**。

**四道超时兜底**（这是前端健壮性的核心，被追问"网络不好会怎样"时用）：

| 常量 | 值 | 作用 |
| --- | --- | --- |
| `RING_FALLBACK_TIMEOUT_MS` | 4500 ms | 即使没收到 `RING_STOPPED` 也会停铃，避免无限响 |
| `PEDESTRIAN_EPISODE_TIMEOUT_MS` | 3000 ms | 一次"行人出现"事件的持续窗口，避免单帧把状态一直挂在"有人" |
| `VISION_STATE_STALE_MS` | 3000 ms | 超过后把检测框标记为过期并清空叠加层 |
| `HANGUP_ACK_TIMEOUT_MS` | 8000 ms | 没等到 `CALL_ENDED` 就提示"开发板无法结束通话，请重试"，不清状态 |
| `DISCONNECT_GRACE_PERIOD_MS` | 15000 ms | ICE 短暂 `disconnected` 不主动挂断 |

**一个容易被忽略的细节**：视频用 `object-fit: contain` 显示，所以画面两侧可能有黑边；检测框坐标必须按 letterbox 后的实际显示区域换算，否则框会整体偏移（`webrtc_test.html:700-708`）。这说明前端不只是"画个矩形"。

**候选早到的竞态处理**：如果远端 candidate 比 offer 先到，前端会先缓存，等 `handleOffer` 时再补放（`webrtc_test.html:1361-1365`、`:1266-1280`）。这是 WebRTC 里非常经典的时序坑。

---

## 第 9 章 配置层：为什么改这些数字就能适配硬件

配置分四层，从"改代码"到"改菜单"，逐层收敛：

```text
① 应用级常量        main/settings.h                      板名、分辨率、帧率、GPIO、Wi-Fi 引入
② 功能开关          main/Kconfig                          CONFIG_DOORBELL_SUPPORT_PEDESTRIAN_DETECT
③ 工程默认配置      sdkconfig.defaults / .esp32p4         Flash、PSRAM、芯片 revision、摄像头、C5 SDIO、模型
④ 板级引脚表        components/codec_board/board_cfg.txt I2C/I2S/PA/摄像头/屏幕
⑤ 依赖与版本        main/idf_component.yml                AI 模型、esp_hosted、esp_wifi_remote、本地组件
```

关键项解释（汇报被问到能立刻答）：

| 配置 | 值 | 为什么 |
| --- | --- | --- |
| `CONFIG_ESP32P4_SELECTS_REV_LESS_V3` / `REV_MIN_100` | y | 实测板子是 P4 rev 1.3，不这样设会拒绝烧录 |
| `CONFIG_ESPTOOLPY_FLASHSIZE_16MB` | 16 MB | 板载 16 MB Flash；应用分区 8 MB |
| `CONFIG_SPIRAM_SPEED_200M` | 200 MHz | 32 MB PSRAM 用于帧缓冲、线程栈、模型 |
| `CONFIG_ESP_HOSTED_IDF_SLAVE_TARGET="esp32c5"` + SDIO 引脚 | C5 | P4 无 Wi-Fi，Wi-Fi 由板载 C5 通过 SDIO 提供 |
| `CONFIG_WIFI_RMT_*` 一组 | 固定值 | 锁定 esp_wifi_remote 1.6.3 的缓冲区契约，使干净构建不依赖旧 sdkconfig |
| `CONFIG_WIFI_RMT_NVS_ENABLED=n` | 关 | 始终用应用提供的凭据，避免 C5 里的旧 NVS 覆盖 |
| `CONFIG_CAMERA_OV5647=y` + RAW10 1280×960 binning | OV5647 | 板载 MIPI-CSI 摄像头；ISP 管线打开 |
| `CONFIG_DOORBELL_SUPPORT_PEDESTRIAN_DETECT=y` | 开 | 启用 AI 支路（同时决定 C++ 源文件是否参与编译） |
| `CONFIG_HUMAN_FACE_DETECT_MSRMNP_S8_V1` + `MODEL_IN_FLASH_RODATA` | y | 人脸存在模型量化版本与放置位置 |
| `partitions.csv`：`nvs 0x5000 / phy 0x1000 / factory 0x800000 / pedestrian_det 500K` | — | 8 MB 应用分区给固件（当前约占 82%），500K 给模型 |

`main/idf_component.yml` 里两处细节值得讲：
- `override_path: ../../../components/...` 表示**优先用仓库内组件而不是组件仓库版本**——保证提交快照自洽；
- `espressif/esp_hosted: 2.12.12` 与 `esp_wifi_remote: 1.6.3` **精确锁版本**，因为不锁定的话干净环境会解析到 Kconfig 契约不同的新版本，导致"我机器上能构建、评审机器上不能"。

---

## 第 10 章 测试与验证体系

### 10.1 两类测试

| 类型 | 位置 | 数量 | 运行环境 | 覆盖 |
| --- | --- | --- | --- | --- |
| 宿主机 C 单元测试 | `tests/*_test.c` | 13 | PC（gcc/clang 编译纯逻辑模块） | 雷达解析、存在状态机、融合、来电策略、事件 JSON、状态快照、门锁状态机、PCM 混音、行人假阳性过滤、格式探测、运动检测、视觉跟踪、视觉事件 |
| Python 契约/静态检查 | `tests/verify_*.py` | 14 | PC（读源码 + 编译运行上面的 C 测试） | 板级配置一致性、雷达接入、门铃策略、舵机契约、音频混音、行人过滤、融合、视觉运行安全（栈/格式/BOOT）、网页与信令契约 |

**测试数据**：`tests/data/ld2450_live_idle.hex`、`ld2450_live_one_target.hex` 是从真机抓下来的雷达原始帧，用于验证解析器对**真实数据**的正确性，而不是只测自己构造的样本。

**覆盖关系**：14 个 Python 入口会把 `tests` 下 13 个 C 测试**全部**编译执行（用 `D:\mingw64\bin\gcc.exe`，可用环境变量 `CC` 覆盖），不存在"写了测试但没被执行"的文件。其中 `verify_pcm_overlay.py`、`verify_pedestrian_filter.py` 是 2026-09-16 为"提示音混音"和"整幅满屏框假阳性"两个真实问题补上的入口。

### 10.2 本次实测结果（2026-09-16，本机复跑）

```text
verify_door_lock.py                PASS
verify_doorbell_ring_policy.py     PASS
verify_doorbell_status.py          PASS
verify_hybrid_vision_ui.py         PASS
verify_pcm_overlay.py              PASS
verify_pedestrian_filter.py        PASS
verify_presence_fusion.py          PASS
verify_radar_ld2450.py             PASS
verify_round_two_ui.py             PASS
verify_task_8_3_8_4.py             PASS
verify_vision_event.py             PASS
verify_vision_runtime_safety.py    PASS
verify_vision_tracker.py           PASS
verify_wt99p4c5_config.py          PASS
VERIFY_TOTAL=14   VERIFY_FAILED=0
```

### 10.3 构建结果（来自 `09_提交源码完备性审计.md`）

| 项 | 结果 |
| --- | --- |
| ESP-IDF | v5.5.5，目标 `esp32p4` |
| 干净构建 | 1850/1850 步完成 |
| 产物 | `doorbell_demo.bin` = `0x68fd20` 字节（约 6.56 MiB） |
| 分区余量 | `0x1702e0` 字节（18%） |

> 提示：`01_开发日志.md` 里记的 `0x693440` 是更早一次构建的数字，二者都是真实记录，正式汇报统一用审计报告里的 `0x68fd20` 并注明日期即可，**不要说成矛盾**。

### 10.4 测试体系的价值（汇报话术）

*"这个项目的核心决策逻辑——来电准入、门锁状态机、雷达存在判定、双证据融合、PCM 混音——都被写成了不依赖硬件和 RTOS 的纯函数，因此可以在电脑上跑单元测试。提交前 14 个自动检查全部通过，并且把 tests 目录下 13 个 C 单元测试全部编译执行了一遍。这样即使评委手上没有这块板子，也能验证这些逻辑的正确性。"*

---

## 第 11 章 汇报速查

### 11.1 一分钟总述（背下来）

> 这是一个跑在 WT99P4C5-S1 上的局域网 WebRTC 智能门铃，基于 Espressif 官方 `doorbell_local` 例程做的硬件移植与功能扩展。P4 负责音视频和 AI，板载 C5 通过 SDIO 提供 Wi-Fi。板子自己就是 HTTPS 服务器：它下发中文网页、用 SSE 向网页推事件、用 POST 接收网页命令，音视频走 WebRTC 直连，局域网内不依赖外部服务，实测接通约 4～6 秒。功能上，BOOT 按键、LD2450 毫米波雷达和摄像头人员检测三个来源汇入同一个来电入口；雷达判断"门前 3 米内有人进入"，摄像头判断"确实是人"，两个证据在 2 秒窗口内都成立才自动按铃，同一次来访只响一次。网页可以接听、看到板载 H.264 视频和双向语音、点击开门——开门通过 GPIO32 的 50 Hz PWM 驱动舵机模拟门锁，开门播报在启动时就被预解码成 PCM，并挂在通话音频的同一条输出路径上，因此不会像早期版本那样只能在挂断后播放。核心决策逻辑都写成了可在 PC 上做单元测试的纯函数，提交前 12 个自动检查全部通过，干净构建 1850 步完成，固件约 6.56 MiB、分区余 18%。

### 11.2 30 秒极简版

> 官方门铃例程 + WT99P4C5-S1 硬件移植 + 三样自研能力：舵机模拟门锁、LD2450 雷达二维感知、摄像头人员/人脸存在检测，并用"雷达 + 视觉双证据"驱动自动来电；开门播报做成预解码 PCM，与通话音频共用同一条输出路径，不再需要挂断后再播。

### 11.3 代码量分布（证明核心在哪）

| 部分 | 约行数 | 占比 |
| --- | --- | --- |
| `webrtc.c`（通话中枢） | 1479 | 最大单文件 |
| `webrtc_http_server.c`（信令服务） | 604 | |
| `media_sys.c` + `doorbell_audio_render.c` + `pcm_overlay.c`（媒体与音频） | 1017 | |
| 感知（雷达 4 文件 + 视觉 7 文件 + 融合） | 约 2100 | |
| 执行器与业务策略（门锁、来电策略、事件、状态） | 约 400 | |
| `webrtc_test.html` | 1566 | 前端 |
| 自有 C/C++ 合计 | 约 7000 | 不含网页与测试 |

### 11.4 汇报前 5 分钟检查清单

- [ ] 打开顺序：`CMakeLists.txt` → `settings.h` → `main.c:435` → `webrtc.c:333` → `webrtc.c:1171` → `webrtc_http_server.c:178` → `pcm_overlay.c` → `presence_fusion.c` → `pedestrain_detect.cpp:66` → `multimodal_fusion.c` → `door_lock.c:84` → `webrtc_test.html:927`。
- [ ] 三个通道能一口气说清：SSE 下行、POST 上行、WebRTC 媒体。
- [ ] 双证据条件能背：雷达在区 + 2 秒内视觉证据 + 本次来访未响过。
- [ ] 四个边界能主动声明（见 11.6）。
- [ ] 关掉 `settings.local.h`，终端历史清理干净。

### 11.5 容易说错的 10 句话（对照表）

| 不要这样说 | 应该这样说 |
| --- | --- |
| "网页用 WebSocket 和板子通信" | 下行 SSE，上行 HTTP POST，媒体走 WebRTC |
| "人脸识别 / 认出是谁" | 只做人脸**存在**检测，不做身份识别 |
| "识别准确率 86%" | 那是某个检测框的**模型置信分数** |
| "雷达点云 / 三维成像" | LD2450 输出最多 3 个**二维坐标点** |
| "已经有雷达俯视图" | 只有坐标、速度与进出事件，俯视轨迹是扩展项 |
| "事件数就是现场人数" | 是**累计历史条数** |
| "装了真实门锁" | 舵机空载**模拟**门锁，无到位反馈 |
| "屏幕已经用起来了" | 屏幕仅保留板级支持，未接入 UI |
| "网页状态由 doorbell_status 统一提供" | 该模块已实现但**尚未接线**，网页状态来自 SSE 事件 |
| "AI 是核心卖点，性能很强" | AI 检测约占 17% CPU，双核空闲约 77%/98%，是**辅助证据** |
| "开门语音是中文播报" | 提示音是**预录英文音频**（"Doors open, come in please"），中文只在网页 UI |
| "摄像头画面显示在板载屏幕上" | 本板**未接屏幕**，LCD 渲染句柄为 NULL，画面只在浏览器里 |
| "开门一定能在通话中听到播报" | 只有 16 kHz 音频路径下才会混音；默认 G711A 8 kHz 构建需实机复测（见 6.4 的警告框） |

### 11.6 必须主动声明的边界（先说比被问更可信）

1. 舵机模拟门锁，未连接真实锁体，无到位/电流反馈；
2. 摄像头只判断人员/人脸存在，不做身份识别；
3. 雷达是二维目标点，不是点云，无俯视轨迹；
4. 配套显示屏未接入当前 UI，仅保留板级支持（实际日志会打印 `Video render not set, stream is skipped`）；
5. 面向同一局域网单客户端（第二个浏览器会顶掉第一个的 SSE），无公网穿透、无账号体系、无云端推送；
6. **开门命令当前没有任何鉴权**，TLS 用的是演示用自签名证书——属于"可信局域网 Demo"级安全边界；
7. 稳定性验证为连续约 7 分钟无异常，**尚未完成 8/24 小时长稳测试**。

---

## 第 12 章 评委可能追问的 30 个问题（含答法）

### A. 架构与选型

1. **为什么不用 WebSocket 而用 SSE + POST？**
   SSE 是浏览器原生 API，服务端只需在 HTTP handler 里持续 `send_chunk`，实现量极小；上行频率很低（几次握手 + 少量命令），POST 足够。整套方案在 ESP32 上比引入 WebSocket 更省内存和代码量。而且**媒体不需要 WebRTC 之外的信令通道**，信令只要"能可靠送几条 JSON"。

2. **为什么板子自己当信令服务器？**
   局域网门铃的目标是"插上电、打开网页就能用"，不依赖任何外部服务；板子已有 Wi-Fi 和 HTTPS 能力，加一个信令实现只用了 604 行。

3. **为什么局域网不需要 STUN/TURN？**
   浏览器和板子在同一个二层网络，主机候选（host candidate）就能直连。浏览器侧配置 `iceServers: []`，服务端也不等待公网 STUN 响应——这是接通时间从约 30 秒降到 4～6 秒的主要原因之一。

4. **P4 和 C5 是怎么分工的？**
   P4 是主控：跑应用、音视频编解码、AI 推理、HTTPS 服务；它没有 Wi-Fi 射频。板载 C5 作为协处理器通过四线 SDIO 提供 Wi-Fi，由 `esp_hosted` + `esp_wifi_remote` 把 P4 上的 `esp_wifi_*` 调用转发到 C5。

5. **为什么要锁 `esp_hosted` / `esp_wifi_remote` 的版本？**
   这两个组件的 Kconfig 契约在版本间变化过，不锁定会导致"我的机器能构建、评审环境不能"。锁定后再把远程 Wi-Fi 缓冲参数写进 `sdkconfig.defaults.esp32p4`，干净构建就与本地一致。

### B. WebRTC 与媒体

6. **`no_auto_reconnect` 解决什么问题？**
   关掉"信令一连上就自动建连"，让建连必须由 `ACCEPT_CALL` 显式触发。门铃语义是"有人按铃、主人接听"，而不是"设备一直在线可看"。

7. **为什么摄像头采集不随挂断关闭？**
   `esp_webrtc_set_no_auto_capture(true)`（`webrtc.c:1271`）。P4 上重建 MJPEG/H.264 采集管线较慢，每次挂断都重建会让后续通话的视频明显晚到。保持常驻后，多轮通话视频都能及时出现。

8. **音频用什么编码？**
   默认 G711A 8 kHz 单声道（`WEBRTC_SUPPORT_OPUS` 未开启时）；代码里保留了 OPUS 16 kHz 双声道分支及其 40 KB 栈的线程配置。

9. **视频方向和音频方向？**
   视频 `SEND_ONLY`（板 → 浏览器），音频 `SEND_RECV`（双向）。浏览器端不需要上传摄像头，这也缩短了建连时间。

10. **通话中开门提示音为什么不打断通话？**
    因为它没有新开音频流，而是在自定义 audio render 的 `write` 回调里，把预先离线解码好的 16 kHz 单声道 PCM 加到输出 PCM 上并做 16 位饱和限幅（`doorbell_audio_render.c:147-175` + `pcm_overlay.c`）；远端长时间静音时由后备线程输出承载提示音的帧（`:38-97`）。
    **追问"那 8 kHz 的 G711A 怎么办"时**：如实回答——overlay 的混音分支要求 16000 Hz（`:134-137`），默认 G711A 构建下走的是"静音间隙 + 后备线程"路径；若要稳定混音，需要启用 OPUS（16000 Hz）或扩展重采样逻辑。这是已知的配置耦合点。

11. **提示音为什么要预解码？**
    通话时再做 AAC 解码会引入延迟和抖动，而且解码与混音在同一路径上更容易卡顿。启动时一次性解码 + 重采样成 16 kHz 单声道常驻内存，通话中只做加法。

12. **数据通道做什么用？**
    主要作为可靠性自测（每秒 8 KB 大消息 + 校验），业务命令走信令的 `customized` 消息，因为要保证通话未建立时也能送达。

13. **RTP Transformer 是功能吗？**
    不是，是上游的 RTP 变换 API 验证钩子，默认关闭，本作品音视频不依赖它。

### C. 感知与算法

14. **雷达凭什么判断"进入"？**
    30 字节帧解析出最多 3 个目标的 X/Y/速度；先做门前区域判定（X ±1500 mm、Y 300～3000 mm），再用状态机去抖：连续 1 秒在区内才算"进入确认"，连续 2 秒不在区内才算"离开确认"，离开后 10 秒冷却。

15. **为什么用"区域 + 去抖"而不是直接按距离阈值？**
    人在门口来回走动、雷达噪声都会让瞬时判定抖动；时间维度的确认把误触发压下去，冷却则防止徘徊反复响铃。

16. **视觉为什么有两个模型？**
    行人模型是主判据；人脸存在模型作为近距离辅助证据——当雷达正关注门前、或者没有可信行人框时也会跑人脸，避免"人贴得很近只露脸"这种漏检。

17. **为什么检测支路是 320×180@2 FPS？**
    独立于 640×480@15 FPS 的通话视频。低分辨率低帧率把 AI 开销控制住（约占 17% CPU），不抢通话的实时性；推理明显变慢时还会自动降帧保护通话。

18. **"4 帧命中 3 帧"是什么？**
    视觉跟踪器的确认条件：在滑动窗口内命中达到阈值才把目标标为 confirmed，连续丢失若干帧才清除；同时做 IOU 关联并避免"人体框内的人脸"被重复计数。

19. **双证据融合的具体条件？**
    雷达在区内、该次进入允许响铃、本次来访尚未响过、且 2 秒内存在视觉证据（行人优先，人脸次之）。四条同时成立才请求来电；雷达离开时清空"本次来访"标记。

20. **这套机制能保证不误报吗？**
    不能保证。它的作用是**显著降低**单传感器误触发：雷达会被门外经过的物体触发，视觉受光线和角度影响。真实边界是"两个独立证据同时成立"，不是"无误报"。

### D. 执行器与硬件

21. **舵机参数与动作流程？**
    GPIO32、50 Hz、500 μs 锁定、2500 μs 打开；动作流程为 LOCKED → OPENING（500 ms 裕量）→ UNLOCKED（保持 5 s）→ CLOSING（500 ms）→ LOCKED。请求只入队，由独立任务顺序执行，重复点击幂等。

22. **怎么知道门真的开了？**
    不知道。舵机没有位置、电流或限位反馈，`UNLOCKED` 只表示命令执行且动作时间已过。真实到位反馈需要限位开关或电流检测，属于后续工作。

23. **舵机供电怎么处理？**
    舵机用独立稳压 5 V 供电，与主板只共地，不并联 5 V；雷达单独分支走线。原因是舵机堵转电流约 1 A，共电源会拉低电压导致雷达串口乱码或主板复位（`docs/bringup/servo-power-and-safety.md`）。

24. **雷达接线与串口参数？**
    UART1、256000 8N1，RX=GPIO4、TX=GPIO5，5 V 供电，与舵机分开供电分支。

### E. 工程与质量

25. **怎么保证 AI 不会拖垮系统？**
    三层保护：独立低分辨率低帧率支路、`thread_scheduler` 给 `detect` 线程 24 KB 栈并降优先级、推理过慢时自动降帧。此前的真实故障就是检测线程 4 KB 栈 + 浮点格式化触发栈保护重启，提高栈并改静态 JSON 缓存后连续观察约 7 分钟无异常。

26. **为什么这么多模块写成纯函数？**
    为了可测试。门锁状态机、来电策略、融合决策、雷达存在状态机、PCM 混音都不依赖硬件和 RTOS，可以在 PC 上编译运行单元测试，覆盖各种状态组合。

27. **测试覆盖了什么？怎么跑的？**
    14 个 Python 检查脚本 + 13 个宿主机 C 单元测试。前者既校验源码契约（网页、板级配置、接线），也会编译并运行后者。提交前实测 14/14 通过，C 测试 13/13 全部被覆盖。

28. **内存和性能余量？**
    应用分区 8 MB，固件 `0x68fd20`（约 6.56 MiB），余 18%；AI 检测约占 17% CPU，双核空闲约 77% 与 98%；检测线程剩余栈约 21 KB。

29. **页面刷新后第一次按 BOOT 会丢来电吗？**
    不会。新建立的 SSE 连接会立刻把旧的标记为停止并接管，避免旧连接占着事件通道；这也是调试中修掉的问题之一。

30. **按了挂断但视频还在播怎么办？**
    现在的实现是"确认式挂断"：网页发 DENY_CALL 后不立即清状态，等板端回 `CALL_ENDED`（或失败时 `CALL_END_FAILED`）才关闭 PeerConnection、停麦克风、清空 `<video>`。以板端确认为唯一结束条件，保证界面与媒体一致。短暂断线另有 15 秒宽限，避免 Wi-Fi 抖动误挂断。

---

## 第 13 章 代码与文档的 8 处不一致（自己先知道，才不怕被问）

这一章是**自查清单**。这些问题都不影响"功能可用"，但如果有评委细读代码或文档，提前知道并主动说明，比被指出要好得多。建议的处理方式：能改的改代码（下次迭代），暂时不改的在汇报里如实说"这是已知项"。

| # | 现象 | 证据 | 影响 | 建议话术 |
| --- | --- | --- | --- | --- |
| 1 | **没有"中文语音提示"**。三段提示音是预录 AAC，开门台词为英文 "Doors open, come in please"；中文只存在于网页 UI | `docs/submission/01_开发日志.md:112`；`main/CMakeLists.txt` 仅嵌入 3 个 AAC，无 TTS 组件 | 若汇报说"中文语音播报"会与事实不符 | 说"中文网页交互 + 语音播报"，不要说"中文语音" |
| 2 | `pedestrian_detected()` / `doorbell_report_vision_detection()` / `PEDESTRIAN_DETECTED` 信令是**死代码**：`detect_cfg.detected` 被配成 `NULL` | `webrtc.c:1392-1395`（`.detected = NULL`）与 `webrtc.c:450-467` | 无功能影响（融合走 `snapshot` 路径），但会让人误判架构 | 说"视觉证据统一走 snapshot 回调进入融合，旧的 detected 回调已停用" |
| 3 | `camera_motion` 的运动结论**只打日志，不进入融合**；`multimodal_fusion` 显式拒绝 MOTION | `pedestrain_detect.cpp:267-278`；`multimodal_fusion.c:73-77` | 与 `docs/bringup/radar-test-matrix.md:119-124` 的表述（近场运动作为 fallback 参与融合）不一致 | 说"运动检测目前作为辅助诊断信息，融合只采信行人/人脸证据" |
| 4 | `doorbell_status` 模块**定义了但未接线**（详见 8.9） | 全仓库只有自身与测试引用 | 网页状态不来自它 | "预留的统一状态聚合模块，下一步用于总状态事件" |
| 5 | 数据通道自测的**校验恒失败**：发送文本是 `Send to <label> count %d`，校验却查找 `"the "` | `webrtc.c:806`（发送） vs `webrtc.c:845`（校验） | 持续刷 `Get data label ... verify:0` 错误日志，不影响门铃功能 | 说"数据通道是可靠性自测用途，双方文本格式约定不一致，日志会报校验失败" |
| 6 | `stop_webrtc()`（串口 `stop` 命令/断网）**不向浏览器发 BYE 或 CALL_ENDED** | `webrtc.c:1423-1479` 无对应 SEND_CMD | 板端主动停机时网页可能停留在"通话中"直到心跳/断线宽限 | 说"网页主动挂断有确认握手；板端被强制停机时依赖 SSE 心跳断开来识别" |
| 7 | `RTP_TRANSFORMER` 开关**通话中切换不生效**：变换器只在 `PAIRED` 事件时下发 | `webrtc.c:1075`（仅 PAIRED 调用 `setup_rtp_transformers`） | 仅影响调试特性 | 说"该开关需在建连前设置" |
| 8 | `pedestrian_format_probe`、`pedestrian_filter_update` 未接入生产路径（前者是探测工具，后者被跟踪器取代） | `pedestrain_detect.cpp:107` 写死 `RGB565LE` | 无功能影响，属遗留工具代码 | 说"格式探测与早期过滤器保留了实现和单元测试，当前生产路径使用固定格式与跟踪器" |
| 9 | **开门播报在默认构建下静默失效**：混音要求 16000 Hz（`compatible`），而默认通话音频是 G711A 8000 Hz；混音分支与兜底线程都不输出，函数仍返回 0 不报错 | `webrtc.c:1226-1228`；`doorbell_audio_render.c:56-60, 134-137, 156-169`；实测日志 `docs/bringup/logs/webrtc-aac-assets-runtime-20260902.log:454,463`（通话中 8000 Hz）；`docs/bringup/logs/2026-09-08-chinese-ui-prompt-fallback.md:42-53`（实机验收待确认） | 演示时按"开门"会听到舵机动作但**没有语音提示**，且串口不报错；`01_开发日志.md:112` 的描述与当前默认构建不一致 | 复测后二选一：① 启用 `WEBRTC_SUPPORT_OPUS`（16 kHz，混音分支生效）；② 把 `open.aac` 预处理目标改成 8 kHz。**修好之前不要在汇报里说"通话中能听到开门语音"** |

**另外两条属于"能力边界"而非"代码缺陷"，同样要如实说：**
- `filter_task` / `detecting_task` 退出后**不会自愈**，只有下一次 `start_webrtc()` 才会重建；
- LD2450 帧**没有校验和**，只有帧头/帧尾/长度校验，因此极低概率的字节错位不会被发现（靠流重同步和区域+时间去抖兜底）。

**主动交代的好处**：这些问题显示你真的读过自己的代码。评委通常更在意"你知不知道自己系统的边界"，而不是"系统是否完美"。

### 13.1 必须主动交代的安全边界（比上面 8 条更重要）

这一条不是"代码小瑕疵"，而是**产品边界**，建议放在汇报的"已知限制"里明确讲：

| 项 | 现状 | 证据 | 建议表述 |
| --- | --- | --- | --- |
| 开门命令无鉴权 | `OPEN_DOOR` 只是一个 JSON 字符串，**不需要已建立通话、不需要配对、不需要任何凭据**；且响应头带 `Access-Control-Allow-Origin: *` | `webrtc_http_server.c:184, 217, 324-333`；`webrtc.c:574-585` | "当前是**可信局域网内的 Demo**：任何能访问该地址的设备都可以触发开门。要产品化必须加入会话令牌或与已配对会话绑定。" |
| TLS 只加密不认证 | 使用的是 ESP-IDF 示例自签名证书，私钥随示例公开分发；浏览器会提示"证书无效"需手动继续 | `webrtc_http_server.c:393-401`、`main/certs/*.pem` | "自签名证书只提供链路加密，不提供服务器身份认证；局域网内可被中间人替换。属于演示级配置。" |
| 证书有效期 | 至 **2028-10-14** | `main/certs/servercert.pem` | "演示证书 2028 年到期，届时需重新生成。" |
| 单观看端 | SSE 只有一个全局会话，第二个浏览器打开会顶掉第一个（表现为第一个页面 5 秒后自动重连） | `webrtc_http_server.c:52, 185-190` | "当前设计为**单观看端**，与提交材料里的'单客户端演示'一致。" |
| 只监听 HTTPS 443 | 没有 80 端口、没有 HTTP→HTTPS 跳转，用 `http://` 打开会失败 | `webrtc_http_server.c:378-407` | "必须用 `https://` 访问，并手动信任自签名证书。" |
| 控制台会打印完整 SDP 与命令 | `printf` 直接输出 SDP/自定义命令到 UART | `webrtc_http_server.c:122, 216, 220, 254` | "调试用输出，录屏与提交演示时注意不要展示串口日志中的 SDP 细节。" |

---

## 附录 A：术语速查

| 术语 | 在本项目里的含义 |
| --- | --- |
| SSE | 服务器发送事件，板 → 浏览器的一条长 HTTP 连接，用来推 JSON |
| 信令（signaling） | 交换 SDP 与 ICE 候选的过程；本项目由板端 HTTPS 服务器承担 |
| SDP | 会话描述：编码格式、方向、ICE 参数 |
| ICE / candidate | 打洞与候选地址；局域网内主要是主机候选 |
| DTLS / SRTP | 加密传输与加密媒体 |
| SCTP / data channel | WebRTC 的数据通道 |
| sink | `esp_capture` 的输出端；本项目用 sink 0 出 H.264 通话流、sink 1 出 RGB565 检测流 |
| 证据（evidence） | 融合器输入：行人在场 / 人脸在场 |
| 双证据 | 雷达在区 + 视觉证据同时成立才自动来电 |
| 提示音叠加 / PCM overlay | 在远端音频 PCM 上做样本级相加与限幅，实现"通话中播报" |

## 附录 B：本手册的证据来源

| 结论 | 依据 |
| --- | --- |
| 初始化顺序、线程策略 | `main.c:216-222, 361-409, 435-479` |
| 来电三源合一、防重入、铃声代号 | `webrtc.c:290-405, 1091-1126` |
| 建连必须由 ACCEPT_CALL 触发 | `webrtc.c:586-619, 1246, 1336`；`components/esp_webrtc/src/esp_webrtc.c:642-679, 773-811` |
| 状态机与过渡态保护 | `webrtc.c:48-54, 245-288, 1052-1082` |
| SSE 三队列、单会话替换、心跳 | `webrtc_http_server.c:32-34, 54-92, 107-211` |
| POST 消息分类与候选提取 | `webrtc_http_server.c:214-348, 491-512` |
| HTTPS 参数与 URI 注册 | `webrtc_http_server.c:376-443` |
| 提示音预解码与播放器构建 | `media_sys.c:128-250, 252-415, 483-589` |
| 通话中混音与后备输出 | `doorbell_audio_render.c:38-97, 147-175, 252-286`；`pcm_overlay.c` |
| 雷达协议、区域、去抖、冷却 | `radar_ld2450.h:11-25`；`radar_ld2450.c`；`presence_fusion.c/.h` |
| 视觉推理、降帧、快照 | `pedestrain_detect.cpp:66-228, 376-385`；`vision_tracker.c`；`vision_event.c` |
| 双证据融合 | `multimodal_fusion.c:24-82` |
| 舵机 PWM 与动作 | `door_lock.h:10-15`；`door_lock.c:13-18, 36-56, 84-125, 128-190` |
| 配置与板级 | `settings.h`；`sdkconfig.defaults.esp32p4`；`idf_component.yml`；`components/codec_board/board_cfg.txt:81-95` |
| 测试与构建结论 | `09_提交源码完备性审计.md`；本篇 10.2 的实测输出 |
| 边界与已知限制 | `01_开发日志.md` 第八节；`docs/submission/README.md` 真实性边界 |
