wudi-tech/esp32-p4-c5-webrtc-doorbell/docs/archive/acrylic-design/specs/2026-09-11-acrylic-v3-production-design.md

# 亚克力背板最终生产图 V3：尺寸核对与设计规格

日期：2026-09-11

## 1. 目标与制造基准

生成可直接交付亚克力加工厂的 1:1 工程加工文件，而不是概念图。

- 材料：透明浇铸 PMMA。
- 成品外形：220.00 × 190.00 × 5.00 mm。
- 四角：R10.00。
- 外形尺寸公差：±0.20 mm。
- 普通孔和开口尺寸公差：±0.10 mm。
- 加工方式：CNC 或激光切割。
- 单位：mm；DXF 比例：1:1。
- 统一坐标：FRONT VIEW 左下角理论交点为 (0,0)，X 向右，Y 向上。
- 背面装配图仍使用 FRONT VIEW 坐标，不得镜像切割几何。

## 2. 尺寸核对与冲突检查

| 项目 | 旧版数据 | 原始资料/用户确认 | V3 采用值 | 结论 |
| --- | --- | --- | --- | --- |
| 背板 | 220×190×5，R10 | 用户明确确认 | 220×190×5，R10 | 一致 |
| 主板 PCB | 90×120×1.6 | WT99P4C5-S1 机械图 | 横装 120×90×1.6 | 尺寸一致，方向重建 |
| 主板孔 | 114.95×84.96，V2 左下角错误 | 4×Ø4.00 PCB 孔；横装孔距 114.95×84.96；边距约 2.525/2.520 | 亚克力 4×Ø3.20；由主板左下角 (20,85) 推导 | 重定位 |
| 摄像头 | V2 误设 4 个 6×3.2 槽 | 照片显示无安装孔；用户允许按主板比例估算；板边至镜头中心约 50 | 无 CUT；参考总长约 56，头部约 8.5×8.5，镜头约 Ø4 | 删除旧槽 |
| LD2450 | 44×15，但 V2 误设四孔支架 | 官方资料 44×15、对角 R1.1 缺口；用户确认两铜柱卡持 | 竖装 15×44；两点 M2 卡持，孔位从官方 STEP/DXF 提取 | 删除四孔支架 |
| 3525 扬声器 | 约 35×25，V2 误设四孔支架 | 用户确认 3525、4Ω/3W，无安装孔资料 | 35×25 参考轮廓；双面胶粘贴；无 CUT | 删除旧孔 |
| MG90S | V2 误设四孔支架及门铰链 | 约 22.8×12.2×28.5；用户决定热熔胶粘贴，仅空转示意 | 无 CUT；参考中心 (190,145)，轴线向外 | 删除支架孔和门孔 |
| 降压板 | V2 绝对位置错误 | PCB 85.10×56；最大平面包络 85.10×61.45；4×孔 Ø2.50，孔距 58×49，边距 3.50 | 亚克力 4×Ø2.20，M2×10 铜柱，PCB 左下角 (120,15) | 重定位 |
| 穿线孔 | V2 为 Ø12 圆孔 | 用户确认需整只 USB-A 插头穿过 | 32×18 圆角矩形，R3，中心 (170,91)，水平 | 完全重建 |

摄像头几何是经用户授权的照片比例估算，标注为装配参考，不进入切割几何。误差按横向 ±1 mm、长度和镜头中心 ±2 mm 管理。

## 3. 已确认布局

### 3.1 正面

- 主板外轮廓：左下角 (20.00,85.00)，尺寸 120.00×90.00。
- 主板安装孔：
  - MB1 (22.525,87.520)，Ø3.20。
  - MB2 (137.475,87.520)，Ø3.20。
  - MB3 (22.525,172.480)，Ø3.20。
  - MB4 (137.475,172.480)，Ø3.20。
- CSI 中心线：X=119.00；摄像头镜头中心约 (119.00,35.00)。排线不允许左右扭转。
- LD2450：中心 (35.00,48.00)，15.00×44.00 竖装，缺口端朝上，天线正面朝 +Y。两点卡持孔从官方机械模型计算。
- 3525 扬声器：中心 (70.00,48.00)，35.00×25.00，仅参考轮廓，双面胶固定。
- MG90S：参考中心 (190.00,145.00)，热熔胶固定，无加工孔；输出轴垂直板面向外。

### 3.2 背面

- 降压板 PCB 左下角：(120.00,15.00)。
- PCB 轮廓：85.10×56.00；最大参考包络：85.10×61.45。
- 降压板安装孔：
  - P1 (143.600,18.500)，Ø2.20。
  - P2 (201.600,18.500)，Ø2.20。
  - P3 (143.600,67.500)，Ø2.20。
  - P4 (201.600,67.500)，Ø2.20。
- 元器件面朝背板外侧，使用 M2×10 mm 铜柱。

### 3.3 共用结构与穿线孔

- 四角 M3 支撑孔：C1 (10,10)、C2 (210,10)、C3 (10,180)、C4 (210,180)，均为 Ø3.20。
- W1 圆角矩形穿线孔：32.00×18.00，R3.00，中心 (170.00,91.00)，水平。
- W1 与降压板最大包络的净距约 5.55 mm；与主板实体右边缘净距 14.00 mm。

## 4. 固定方式

- 主板：4×M3、8 mm 铜柱，PCB 孔两侧使用绝缘垫片。
- 摄像头：薄型双面胶，禁止在排线上施胶，禁止增加亚克力孔槽。
- 雷达：两个 M2 铜柱配尼龙垫片，在官方对角缺口处轻压卡持；另两角使用 1 mm EVA 绝缘垫防摆动。不得遮挡天线面。
- 扬声器：1 mm EVA 双面胶粘贴，无加工孔。
- 舵机：热熔胶固定，无加工孔、无 PETG 支架、无门片或铰链加工。
- 降压板：4×M2、10 mm 铜柱，元器件面朝背面外侧。

## 5. 输出文件

1. `acrylic_plate_cut_only_v3.dxf`：仅 CUT 闭合几何。
2. `acrylic_plate_layered_v3.dxf`：CUT、REFERENCE、TEXT、DIMENSION 分层。
3. `acrylic_plate_manufacturing_drawing_v3.pdf`：四页工程图。
4. `acrylic_plate_front_assembly_v3.svg`：正面装配参考。
5. `acrylic_plate_rear_assembly_v3.svg`：背面装配参考。
6. `acrylic_plate_hole_table_v3.csv`：孔位和开口坐标表。
7. `acrylic_plate_manufacturing_package_v3.zip`：厂家交付包。

PDF 页面：PAGE 1 加工图；PAGE 2 正面装配；PAGE 3 背面装配；PAGE 4 孔位/开口坐标表和尺寸核对表。

## 6. 机械验收条件

- 每个 CUT 特征都有 ID、X/Y、孔径或长宽/R。
- DXF 单位 mm、比例 1:1，不镜像。
- 所有切割轮廓闭合、无重复、无重叠、无断线。
- 主板和降压板孔距分别为 114.95×84.96 与 58×49。
- W1 必须为 32×18、R3 的圆角矩形，而不是圆孔。
- 摄像头、扬声器和舵机不得生成任何切割孔。
- 雷达仅生成两处经官方模型核对的卡持孔。
- 所有孔和开口满足板边及相互间的最小材料宽度。
- PDF 四页文字、尺寸和表格无裁切、无重叠，正背面坐标声明清晰。
