wudi-tech/esp32-p4-c5-webrtc-doorbell/docs/archive/submission-2026-09-14/07_复刻过程记录_加分项_待录制/03_复刻过程加分视频脚本.md

# 复刻过程加分视频脚本

建议成片：5～7 分钟，1920×1080 横屏。重点不是重复最终演示，而是证明从硬件搭建到定位故障的真实工程过程。

## 素材结构

### 1. 硬件搭建（约 1 分钟）

- 主板正反面、P4/C5 模组和接口特写。
- MIPI-CSI 排线插入与锁扣。
- SPK 扬声器接口。
- LD2450 的 5V/GND/TX/RX 接线。
- 舵机独立 5 V 供电和共地，强调不能从 3.3 V 给舵机供电。

### 2. 厂商例程和板级移植（约 1 分钟）

- 厂商例程的屏幕、摄像头和声音片段。
- 串口中的 OV5647 PID、32 MB PSRAM 和 ESP32-C5 SDIO 日志。
- 对比默认开发板配置与 WT99P4C5-S1 配置。

### 3. 三个典型问题（约 2～3 分钟）

每个问题采用“现象—证据—根因—修复—复测”的结构。

#### 问题 A：呼叫建立约 30 秒

- 现象：先有音频，视频延迟出现。
- 根因：局域网场景仍等待无用公网 ICE/STUN 和浏览器摄像头。
- 修复：本地 ICE 配置、取消无用浏览器视频采集、优化连接状态。
- 结果：多轮接通约 4～6 秒。

#### 问题 B：通话中听不到开门语音

- 现象：必须挂断后提示音才播放。
- 根因：提示音与 WebRTC 音频争用渲染器。
- 修复：PCM Overlay 混音和饱和限幅。
- 结果：通话不中断时也能听到开门提示。

#### 问题 C：网页卡顿、BOOT 失效、AI 无结果

- 现象：页面停在最后一帧，按键无响应。
- 证据：串口显示 `Stack protection fault`，崩溃线程为 `detect`。
- 根因：4 KB AI 栈、1 KB 局部 JSON 和浮点格式化叠加。
- 修复：24 KB 栈、静态缓冲、整数格式化和固定 RGB565LE。
- 结果：运行数分钟无崩溃，检测线程约 17% CPU，剩余栈约 21 KB，BOOT 自动测试返回 `ACCEPTED`。

### 4. 自动测试和最终闭环（约 1 分钟）

- 快速展示 12 个验证脚本全部 PASS。
- 展示最终烧录哈希校验。
- 插入最终项目演示的 10～15 秒精彩片段。

## 口播结尾

> 这次复刻不只是让示例跑起来，而是完成了板级适配、实时音视频、执行机构、传感器协议、状态机、多模态融合和故障闭环。最有价值的部分，是每次异常都通过日志和可重复测试定位，而不是靠反复试参数。

## 没有早期视频素材时的替代方案

- 使用已有硬件照片做轻微缩放和平移动画。
- 展示真实串口日志和 Git 差异，不要伪造现场录像。
- 用旁白明确说明“这是当时保存的日志/照片”。
- 不要重演危险接线、舵机堵转或带电插拔排线。
