wudi-tech/esp32-p4-c5-webrtc-doorbell/docs/archive/submission-2026-09-14/05_代码录屏讲解_待录制/README.md

# 此目录还需放入代码录屏讲解视频

建议文件名：`05_代码录屏讲解.mp4`

- 横屏 1920×1080，30 fps，MP4/H.264。
- 建议时长 8～10 分钟。
- 必须使用清晰麦克风，关闭微信、邮箱等通知。
- 按同目录的 `01_代码录屏讲解脚本.md` 依次展示目录结构、WebRTC 主流程、音频、雷达、摄像头语义检测、舵机和自动检查。
- 屏幕中不要出现 Wi-Fi 密码、私人路径中的个人信息或聊天记录。

录完后请从头到尾播放一遍，确认画面、声音和文字均清晰，再删除本说明或保留作为审查备注。
