wudi-tech/esp32-p4-c5-webrtc-doorbell/docs/archive/submission-2026-09-14/06_项目使用流程演示_待录制/README.md

# 此目录还需放入项目使用流程演示视频

建议文件名：`06_项目使用流程演示.mp4`

- 横屏 1920×1080，30 fps，MP4/H.264。
- 建议时长 3～4 分钟，尽量一镜到底。
- 同时拍到硬件和电脑网页；可使用第二部手机补拍硬件近景。
- 按同目录的 `02_项目使用流程演示脚本.md` 演示：上电、网页连接、雷达检测、BOOT 呼叫、接听、视频、双向语音、舵机模拟开门、挂断和再次呼叫。
- 口述必须说“舵机模拟门锁”，不要说已经安装真实门锁。

录完后检查响铃和语音是否清晰、网页状态是否可辨、画面中是否有隐私信息。
