wudi-tech/esp32-p4-c5-webrtc-doorbell/docs/archive/submission-2026-09-14/07_复刻过程记录_加分项_待录制/README.md

# 此目录用于加分项复刻过程视频

建议文件名：`07_复刻过程记录.mp4`

- 横屏 1920×1080，30 fps，MP4/H.264。
- 建议时长 5～7 分钟。
- 按同目录的 `03_复刻过程加分视频脚本.md` 展示硬件接线、从厂商例程到 WebRTC 门铃的改造、主要故障与修复、构建和测试过程。
- 可以插入历史照片、串口日志或调试截图，但应遮挡 Wi-Fi 密码和个人信息。
- 若素材很多，可拆成“硬件搭建”和“代码调试”两段视频，但文件名和顺序要清晰。
