wudi-tech/esp32-p4-c5-webrtc-doorbell/output/acrylic/acrylic_plate_cut_only_v3.dxf

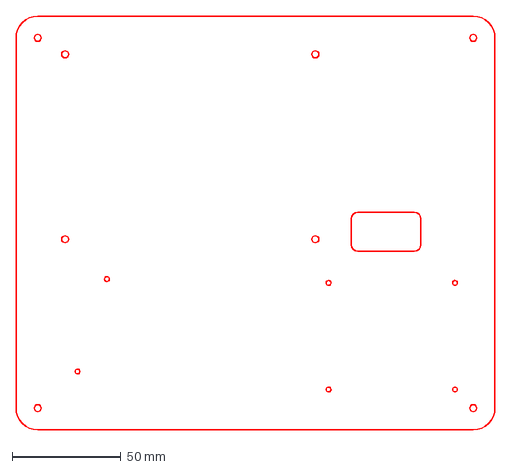
[picture p1: CAD file, 2026-10-24]
output/acrylic/acrylic_plate_cut_only_v3.dxf
220.0 x 190.0 mm
