wudi-tech/esp32-p4-c5-webrtc-doorbell/output/acrylic/acrylic_plate_layered_v3.dxf

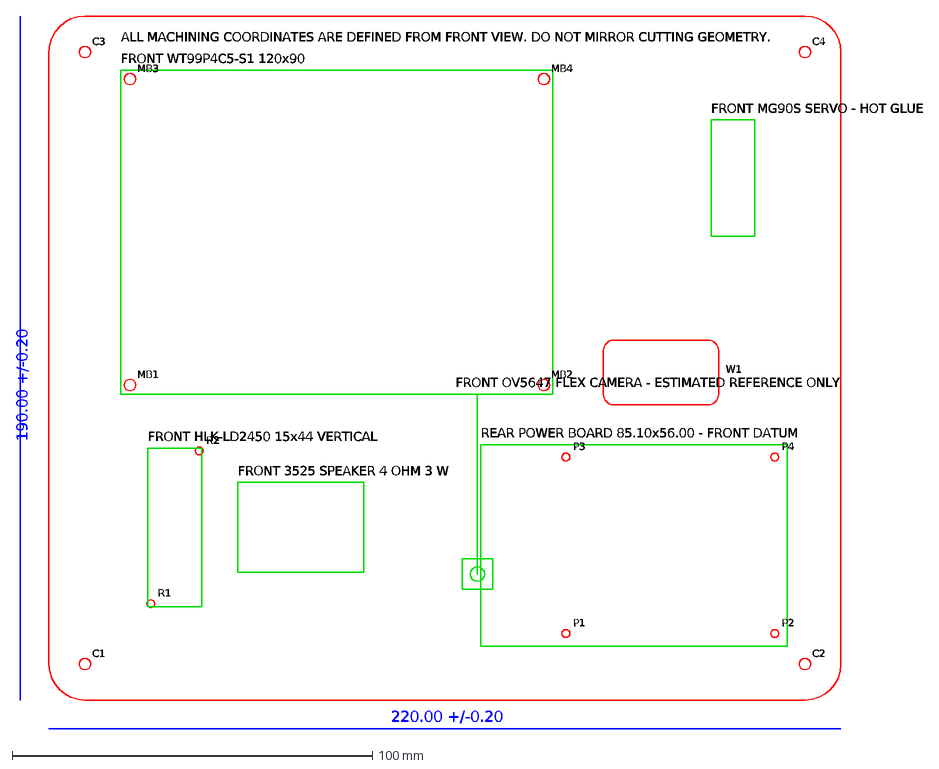
[picture p2: CAD file, 2026-10-24]
output/acrylic/acrylic_plate_layered_v3.dxf
FRONT WT99P4C5-S1 120x90
FRONT OV5647 FLEX CAMERA - ESTIMATED REFERENCE ONLY
FRONT HLK-LD2450 15x44 VERTICAL
FRONT 3525 SPEAKER 4 OHM 3 W
FRONT MG90S SERVO - HOT GLUE
REAR POWER BOARD 85.10x56.00 - FRONT DATUM
C1
C2
C3
C4
MB1
MB2
MB3
MB4
R1
R2
P1
P2
P3
P4
W1
220.00 +/-0.20
190.00 +/-0.20
ALL MACHINING COORDINATES ARE DEFINED FROM FRONT VIEW. DO NOT MIRROR CUTTING GEOMETRY.
