wudi-tech/esp32-p4-c5-webrtc-doorbell/output/acrylic/acrylic_plate_cut_v1.dxf

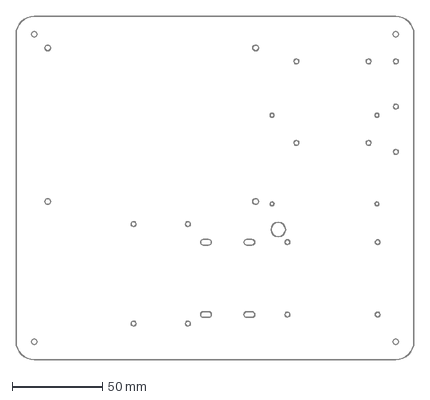
[picture p4: CAD file, 2026-10-24, an earlier design]
output/acrylic/acrylic_plate_cut_v1.dxf
220.0 x 190.0 mm
