wudi-tech/esp32-p4-c5-webrtc-doorbell/docs/bringup/logs/2026-09-07-round-two-build-flash.md

# 2026-09-07 圆二建和闪存纪录

## 结果

- ESP32-P4 应用程序构建: 通过
- COM5 应用程序烧录: 通过
- 烧录散列校验: 通过
- 启动和服务准备: 通过
- 现场直播 HTTPS 页面检查: 通过
- 自动回归检查: 通过

## 构建和闪存证据

- 应用程序图像: `doorbell_demo.bin`
- 图像大小: `0x65d380` 字节
- 最小的应用分区自由空间: `0x1a2c80` 字节 (20%)
- 烧录地址: `0x10000`
- 写入字节: 6,673,280
- Esptool 结果: `Hash of data verified`
- 目标: ESP32-P4 订正 v1.3

## 启动证据

- 32 MB PSRAM 检测和通过内存测试。
- ES8311 音频编码已初始化。
- 门锁 PWM 于 GPIO32 在锁定位置。
- LD2450 于 UART1 256 000桶炸弹 (RX GPIO4, TX GPIO5)。
- 嵌入式开门式 AAC 检测为 24 kHz 单体。
- 备妥为95,16千赫单数的574字节 PCM。
- OV5647 探测到的相机 PID `0x5647`。
- ESP32-C5 已查明并 SDIO 运输活动。
- Wi-Fi 购置 `192.168.0.103` 页:1 HTTPS 开始信令服务器。
- 一个瞬间 Wi-Fi 已观察到断开; 自动重联还原了相同的地址和全部 media/service 初始化路径。

## 现场端点证据

`https://192.168.0.103/webrtc/test` 返回 HTTP 200 有内容类型
`text/html; charset=utf-8`. 部署的网页包括分组的传感器事件,
联合国 `RING_STOPPED` 信令， 确认 `CALL_ENDED` 拆开， 页:1
人物-现场事件解释。

## 其余实际接受

以下要求某人听到或观察棋盘和浏览器：

1. 听到开门的提示时 WebRTC 调用仍然有效。
2. 确认棋盘和浏览器在4秒后停止同步。
3. 确认持续存在被分成一个事件集，雷达文本没有摩吉贝克。
4. 确认挂起， 只有在确认牌面后才清除两个视频元素。
5. 拆掉后立即确认第二通电话，不刷新。
