wudi-tech/esp32-p4-c5-webrtc-doorbell/docs/bringup/radar-test-matrix.md

# LD2450 雷达安装和测试矩阵

日期: 2026-09-04  
固件分支: `feat/wt99p4c5-doorbell`  
P4 序列端口: `COM5`

## 任务 8 的固定线路

只能用电板和雷达供电。

| LD2450 针 | 连接 | 目的 |
| --- | --- | --- |
| `5V` | 5V供应 | 雷达功率; 模块供应必须提供200 mA以上。 |
| `GND` | 供应 GND 联合国 WT99P4C5-S1 J6 标点 11 (GND) | 雷达， 供应， 发展基础必须是共同的. J6 针头 13/15/17 等同为 GND 备选案文。 |
| `TX` | WT99P4C5-S1 J6 针头 10 / P4 GPIO4 | 雷达数据至 P4 UART1 RX。 |
| `RX` | WT99P4C5-S1 J6 针头 12 / P4 GPIO5 | P4 UART1 TX 到雷达配置输入. 可选择只接收任务 8.1, 但保留给后期配置。 |

不要连接雷达的5V针 GPIO. 那个 UART 信令是 3.3 V。
在第一次雷达试验中保持伺服器电源的断开，这样功率
或者噪音断层很容易分离。

## 议定书基准

- UART: 256 000 鲍尔， 8 个数据位， 无对等， 1 个停止位。
- 数据率: 每秒约10帧。
- 数据框架: 固定 30 字节， 标题 `AA FF 03 00`, 3个8字节目标
  记录， 尾声 `55 CC`, 无校验和。
- 零填充的8字节目标记录意味着目标位置是空的。
- X, Y, 并使用 LD2450 direction/magnitude 编码: 位 15 集为
  正数; 位 15 清晰为负; 位数 0-14 保持大小。

主机解析器测试包含在 LD2450 协议文档中。它必须将目标 1 解码为
X=-782 毫米、Y=1713 毫米、速度=-16 厘米/秒、距离分辨率=320 毫米。
接线完成后，将补充从实物雷达采集的实时数据帧。

## 任务 8.1 测试矩阵

| 测试 | 结果 | 证据/接受条件 |
| --- | --- | --- |
| 已公布的原始框架解码 | 通过 | 主机解析器测试将协议示例解码为已记录的值。 |
| Positive/negative 方向解码 | 通过 | 合成双目标测试涵盖两个方向位值。 |
| 差劲 length/header/tail 拒绝 | 通过 | 解析器拒绝错误的帧。 |
| UART 零散和主要噪音恢复 | 通过 | 流式测试在噪音后输入碎片框，并发出一个有效的框。 |
| ESP32-P4 UART 一体化构建 | 通过 | ESP-IDF 5.5.5 完全构建成功; 应用程序图像使用最小应用程序分区的55%。 |
| UART1 开始 GPIO4/GPIO5 | 通过 | COM5 启动日志显示 `LD2450: UART1 ready at 256000 baud (RX GPIO4, TX GPIO5)` 2084分钟。 |
| 实时闲置输出 | 通过 | 物理雷达产生了连续有效的零目标帧，没有解析错误或棋盘重置。 |
| 单人直播 | 通过 | 从X = -1052毫米通过X = + 1660毫米; Y达到约1780毫米，报告速度至少覆盖-104至+79 cm/s。 |
| 直播多个目标 | PENDING | 两个人在雷达视野内 制作两个目标记录。 |
| 原始物理弧度框架捕获 | PARTIAL | 保存真实的闲置和单移动目标框架 `tests/data` 并添加到解析器回归测试中. Two/three-target 样本待处理。 |

## 第一个现场测试序列

1. 启动所有设备 完成上面四个连接。
2. 把服务器的电源断开。
3. 闪烁任务 8.1 软件 P4 通过 COM5。
4. 开始 COM5 显示器， 然后用5V为雷达提供动力。
5. 检查 UART-准备就绪并观察现场目标日志，同时待命,
   接近时， 移动侧面， 离开。
6. 在任务开始前记录代表性原始框架 8.2 区域并解除
   逻辑。

任务 8.2 在现场直播前不能开始 UART 上行通过. 解析器， UART
阅读器， 而后来的存在-聚变逻辑仍然是独立的层。

## 任务 8.2 区域解除并响起

- 执行承诺: `2255b34`
- 固件构建日期: 2026-09-06
- 区: X = -1500..1500 毫米， Y = 300..3000 毫米
- 输入确认: 1 000 毫秒( X)
- 休假确认书: 2000分钟
- 冷却: 经确认休假后10 000毫秒

| 测试 | 结果 | 证据/接受条件 |
| --- | --- | --- |
| 存在-聚变主机测试 | 通过 | 区界线， 多目标选择， 1个条目， 2次请假， 冷却， 并勾选环绕通道。 |
| Doorbell 环政策主机测试 | 通过 | 每一次合格访问一环 busy/cooldown 禁止通过。 |
| LD2450 分解和整合合同 | 通过 | 解析器加序列化 radar/BOOT/command 环形交易检查通行证。 |
| 现有门锁和 WT99P4C5-S1 回归 | 通过 | 任务完成后两个主机校验脚本都会通过 8.2 融合。 |
| ESP-IDF 5.5.5 全面构建 | 通过 | `doorbell_demo.bin` 这是 `0x34b300` 字节; 最小的应用程序分区有45%的自由度。 |
| 烧录任务 8.2 固件为 P4 | 通过 | COM5 确定 ESP32-P4 订正 v1.3; 装填器， 应用程序， 2026-09-06年写出了分区表并进行了散列核查。 |
| 快速通过 (<1 s) | DEFERRED | 物理接受被故意跳过。 |
| 持续入境 (>=1 s) 一环 | DEFERRED | 需要任务 8.2 要闪烁的图像。 |
| 继续存在不会重新环绕 | DEFERRED | 需要在设备上进行观察。 |
| 短期辍学 (<2 s) 不重绕 | DEFERRED | 需要在设备上进行观察。 |
| 冷却和重新审视行为 | DEFERRED | 需要在设备上进行观察。 |
| 连续三次合格访问 | DEFERRED | 需要在设备上进行观察。 |
| Reset/watchdog/crash 观察 | 通过 | 闪电后启动会话运行超过60s，没有重置， 监督， 或崩溃. 日志确认的相机 PID `0x5647`, ESP32-C5 运输， `LD2450` UART1 打开 GPIO4/GPIO5, 和一个和两个目标雷达框架. Wi-Fi 获得 `192.168.0.103`, 一次短暂断开， 然后自动恢复。 |

任务 8.2 在总计划中保持开放，直到推迟审理的实物案件
观察. 执行情况， 自动回归， 固件构建， 烧录， 联合国
启动后核查部分完成。

## 任务 8.3 有组织的雷达事件

雷达事件路径使用专用的边框遥测队列，而不共享
联合国 WebRTC 正在显示队列. 当遥测队列满满时， 最古老的雷达
事件被丢弃，以便信令和雷达 UART 呼叫从不
已封锁. 浏览器保存最新的100个条目并插入所有设备值
与 `textContent`。

| 测试 | 结果 | 证据/接受条件 |
| --- | --- | --- |
| Event-schema 主机测试 | 通过 | 准确 JSON 形状， enter/leave 名称， 无效的音轨标识， 和尺寸不足的缓冲器通过。 |
| 所需字段 | 通过 | 事件包含单调 `timestamp`, LD2450 基于槽 `track_id`, `x_mm`, `y_mm`, `speed`, `zone`, `confidence`, 联合国 `source`. LD2450 没有信心价值， 所以这是明确的 `null`。 |
| 信令隔离 | 通过 | 遥测使用单独的16进制固定大小队列; 一个完整队列在不阻断的情况下放下其最古老的遥测项目。 |
| 浏览器安全和列表绑定 | 通过 | 雷达事件与 `textContent`; 列表上限为100个最新条目。 |
| 现场直播 SSE 交付 | 通过 | 2026-09-06 (英语)。, 物理板位于 `192.168.0.103` 已交付 `connected`, 输入事件 (`track_id=1`, `x=225`, `y=308`), 休假活动， 和周期性心跳消息结束 `/webrtc/signal`。 |

实例直播事件：

```json
{"type":"radar_event","event":"enter","timestamp":30572,"track_id":1,"x_mm":225,"y_mm":308,"speed":0,"zone":"door_approach","confidence":null,"source":"ld2450"}
```

## 任务 8.4 雷达和相机聚变

合并需要确认， 冷却合格雷达访问加一台摄像机
由本地化行人箱或近地运动确认
倒转. 相机在雷达前的2000毫秒是新鲜的
确认; 当雷达已经存在时， 下一个相机结果完成
聚变. 单靠雷达和摄像头不会响. 一个确认
离开清场， 每次访问最多都会发射一枚引信环。

| 测试 | 结果 | 证据/接受条件 |
| --- | --- | --- |
| Fusion 主机测试 | 通过 | 雷达和摄像机， 相机时的雷达， 固态相机结果， 冷却抑制， 每次访问一环， 重新设置， 无效参数， 和计时器环绕通道。 |
| 相机捕获管道 | 通过 | COM5 已谈判日志 RGB565 `320x180 @ 2 fps`; 在一个未准备好的零启动框架之后， 框架2-12有所有1800个样本字节的非零 和变化的散列。 |
| 教条推论 | PARTIAL | 完全框被拒绝，四个 RGB565 解释被探究， 不过 ESP-DL 行人模型没有为近地试验场制作本地化的盒子. 雷达摄像头的后退 盖住门铃的视线。 |
| 处理失败 | 通过 | 失踪 configuration/allocation/sink, 隐藏 setup/enable 失败， 和检测器启动失败的处理方式，而不作无效的引用; 有序关闭不再记录错误的队列分配错误。 |
| 完全固件构建 | 通过 | ESP-IDF 5.5.5 已建成 `doorbell_demo.bin` 时间 `0x65b250` 字节. 8号 MB 应用程序分区有 `0x1a4db0` 字节 (21%) 免费。 |
| 烧录和最后启动 | 通过 | COM5 确定 ESP32-P4 订正 v1.3; 装填器， 应用程序， 并用散列方式验证分区表. 最后启动确认 ESP32-C5 SDIO, LD2450 UART1, OV5647 PID `0x5647`, HTTPS 信令， 以及没有 reset/watchdog/panic。 |
| 物理引信环观测 | 待手动验证 | 修理的固件已经打开 COM5, 但没有雷达进入或合格摄像头移动. 走入视野并移动10秒以验证一个融合环。 |
| 30分钟空闲误触发计数 | DEFERRED | 此迭代故意跳过。 |
| 20 approach/stay/leave 试验 | DEFERRED | 此迭代故意跳过; 稍后计算召回率和误报率所需。 |

任务 8.3 以及任务 8.4 实现已完成. 定量任务8
用户选择仍然推迟接受运行，并在最后几行中跟踪。
