wudi-tech/esp32-p4-c5-webrtc-doorbell/docs/bringup/webrtc-test-matrix.md

# WT99P4C5-S1 WebRTC 任务5测试矩阵

日期: 2026-08-10  
固件分支: `feat/wt99p4c5-doorbell`  
P4 序列端口: `COM5`  
第一启动日志: `docs/bringup/logs/webrtc-first-boot.log`

| 测试 | 结果 | 证据/复制条件 |
| --- | --- | --- |
| 干净 ESP32-P4 构建 | 通过 | ESP-IDF 5.5.5; 1646/1646 目标; 应用程序大小 `0x338cc0`, 46%的应用程序分区免费。 |
| P4 启动， 烧录和 PSRAM | 通过 | 日志 28-1911毫秒: P4 备份 v1.3, 16 MB 烧录， QIO, 32 MB PSRAM 200兆赫时， PSRAM 内存测试 OK。 |
| C5 四位数 SDIO | 通过 | 记录4261-4507毫秒: CLK 18, CMD 19, D0-D3 14-17, 重设 54; 纸牌输入和 C5 识别成功。 |
| C5 Wi-Fi 初始化 | 通过 | 供应商 Wi-Fi 使用的内存配置; Wi-Fi init/start 未完成 `ESP_ERR_NO_MEM`。 |
| Wi-Fi 协会和IPv4 | 通过 | 连接时间为12627毫秒; IP `192.168.31.207` 14159毫秒时。 |
| OV5647 检测 | 通过 | PID `0x5647` 2075毫秒时检测。 |
| HTTPS 信令页面 | 通过 | 服务器 URL 印数14178毫秒; 桌面 `curl --insecure` 返回 HTTP 第200和49条,018 字节。 |
| 浏览器页面和 SSE 在线 | PENDING | 需求 Chrome/Edge UI 确认。 |
| 局对浏览器视频， 2分钟 | PENDING | 需要视觉确认。 |
| 浏览器麦克风到棋盘扬声器 | PENDING | 需要明确确认。 |
| 显示麦克风到浏览器耳机 | PENDING | 需要用耳机或物理分离来确认。 |
| BOOT/GPIO35 电话: 接受 | PENDING | 需要物理设备 BOOT 按下和浏览器交互。 |
| BOOT/GPIO35 电话: 拒绝 | PENDING | 需要物理设备 BOOT 按下和浏览器交互。 |
| 门事件和板块提示 | PENDING | 需要浏览器交互和 audible/event 确认。 |
| 挂断和5秒后第二次通话 | PENDING | 需要浏览器交互。 |
| 连续呼叫， 15分钟 | PENDING | 仅在功能检查合格后开始。 |
| 浏览器刷新并重新连接 | PENDING | 仅在功能检查合格后开始。 |
| 浏览器异常关闭并重新连接 | PENDING | 重连接前至少等待5秒。 |
| Wi-Fi 中断和恢复 | PENDING | 记录行为; 在任务5期间不添加回收代码。 |

## 任务5期间应用的引入修正

- 选中 UART0 作为主控制台，因为 COM5 是棋盘的CP210x
  UART 桥; USB Serial/JTAG 仅生产 ROM 输出于 COM5。
- 已禁用的主机 `SPIRAM_TRY_ALLOCATE_WIFI_LWIP` 对于此远程-Wi-Fi 设置。
  这恢复了供应商测试 C5 配置文件 (静态 RX 10, 动态 TX 32,
  RX BA 窗口 6) 防止 `esp_wifi_init` 从返回
  `ESP_ERR_NO_MEM`.

## 无阻断观察

保留 `ESP32_P4_DEV_V14` 配置文件包括一个 LCD 定义， 任务时
4个故意没有显示屏幕 UI. 因此，第一个启动日志显示
`LCD_RENDER: Invalid argument to open` 和 `MEDIA_SYS: 无法创建视频
执行`. 相机探测， C5 Wi-Fi, 信令启动， 页:1 HTTPS 全部页
成功继续; 屏幕渲染不是任务 5 接受项。

## 2026-09-07 圆二可靠性修补

启动时的固件版本: `c587243-dirty`  
P4 序列端口: `COM5`  
当前页面: `https://192.168.0.103/webrtc/test`

| 测试 | 结果 | 证据/复制条件 |
| --- | --- | --- |
| 建立和应用分区前厅 | 通过 | ESP-IDF 5.5.5 架构已完成; `doorbell_demo.bin` 这是 `0x65d380` 带20%应用程序分区的字节。 |
| 烧录和图像验证 | 通过 | 6,673,280 应用程序字节写入 COM5; 报告电子工具 `Hash of data verified`。 |
| 即时待命准备 | 通过 | 启动解码嵌入式 24 kHz 单 AAC 记录 `Prepared open-door prompt: 95574 PCM bytes at 16 kHz mono`。 |
| 摄影机， 雷达和 C5 启动 | 通过 | OV5647 PID `0x5647`, LD2450 UART1 256 000桶炸弹， 联合国 ESP32-C5 四位数 SDIO 全部已初始化。 |
| Wi-Fi 联合国 HTTPS 页面恢复 | 通过 | 发生瞬间站中断; 固件重新连接， 重新获得 `192.168.0.103`, 并重新启动 HTTPS 信令。 |
| 已部署的页面合同 | 通过 | 返回现场端点 HTTP 200 个与 `text/html; charset=utf-8` 并装有传感器集， `RING_STOPPED`, 联合国 `CALL_ENDED` 处理。 |
| 自动回归检查 | 通过 | 所有门锁， 环形政策， 存在聚变， 雷达解析器， 回合二 UI, 任务 8.3/8.4, 和棋盘配置验证员通过. 嵌入式 JavaScript 语法和 `git diff --check` 通过。 |
| 正在呼叫时打开门 | 待手动验证 | 在连接电话中， 单击打开门. 门动作和 `Doors open, come in please` 必须听而不停止通话。 |
| Board/browser 环同步 | 待手动验证 | 新闻 BOOT 一次. 双方必须在四秒钟左右停止鸣叫，如果没有得到答复; 回答或拒绝也必须立即停止。 |
| 组合传感器事件和可读雷达文本 | 待手动验证 | 持续存在必须产生一个人物-存在插曲，而不是每个帧一个条目; 不应该出现摩吉贝克. 新建条目时， 至少有3秒后开始。 |
| 已确认挂机和冷冻机 | 待手动验证 | 挂起第一个显示 `Ending call...`; 只有董事会承认 完成拆掉. 然后必须清除远程和本地框架。 |
| 拆掉后立即打第二通电话 | 待手动验证 | 前一次挂断后， 启动另一个电话并验证 audio/video 正常连接而不刷新页面。 |

`Sensor Events` 是当地存在事件和雷达的封顶历史
enter/leave 意见. 这不是活人柜台; 浏览器保留
最多100个条目并清除列表只删除显示的历史。

## 2026-09-08 华语 UI 迅速采取后续行动

当前页面: `https://192.168.0.103/webrtc/test`

| 测试 | 结果 | 证据/复制条件 |
| --- | --- | --- |
| 中国浏览器 UI | 通过 | 部署的页面使用中文标签， 通知， 连接状态， 确认对话框， 事件描述， 联合国 RTP 变压器控制. 现场端点返回 HTTP 200 个与 UTF-8 内容。 |
| 可读事件历史 | 通过 | 活动区域为240-360px高， 不再由控制栏压缩， 和长长的雷达记录 而不是被剪在一条线上。 |
| 中国传感器记录 | 通过 | 雷达 enter/leave, 目标数， 坐标， 速度， 区域， 源和设备时间用中文提供; 相机人事件也被翻译。 |
| 独立的开门快速路径 | 通过（软件） | 解码的16 kHz 提示可以混入来电音频，也可以在40 mss的远程音频沉默后直接用20ms帧写成. 在兼容的 16 kHz 调用渲染器打开之前， 将提前点击一个。 |
| 构建， 闪存和启动 | 通过 | 最终 ESP-IDF 架构已完成; `doorbell_demo.bin` 这是 `0x65dd20` 字节. COM5 写和校验闪存 6,675,744 应用字节. 启动 PSRAM, ES8311, LD2450, OV5647, C5 SDIO, Wi-Fi 联合国 HTTPS。 |
| 自动回归套件 | 通过 | 土著 PCM 重叠测试， 全部 Python 语句 contract/integration 检查， 嵌入式 JavaScript 语法， 联合国 `git diff --check` 通过。 |
| 通话时听到开门提示 | 待手动验证 | 建立通话后单击 `开门`，确认开发板播放 `Doors open, come in please`（“门已打开，请进”）且通话不中断；同时核对 `Prompt playback armed`、输出路径和播放完成日志。 |

独立即时路径在即时修正前一个设计缺陷
进度完全取决于浏览器持续发送解码远程
音频帧. 要听得见 还要有监听员。

## 2026-09-08 行人假阳性过滤器

固件构建时间: `Sep 8 2026 11:09:58`  
P4 序列端口: `COM5`  
当前页面: `https://192.168.0.103/webrtc/test`

| 测试 | 结果 | 证据/复制条件 |
| --- | --- | --- |
| 拒绝全方位的虚假检测 | 通过 | 镜头前没人， ESP-DL 覆盖几乎完整的320x180探测器框架的反复返回的盒子 (`[0,0,319,179]`, 分数 `0.829`-`0.852`). 申请拒绝了他们，认为他们数量之大不可思议，没有 `PEDESTRIAN_DETECTED` 事件。 |
| 过滤后 Wi-Fi 恢复 | 通过 | 一个站后 disconnect/reconnect, 相机和探测器重新启动，同样的全帧假结果再次被拒绝。 |
| 时间和几何单元测试 | 通过 | 主机测试覆盖低信任度， 无效的坐标， 非常喜欢 small/large 选项框， 三级确认， 非重叠候选人， 持续确认的存在， 和三框架清理。 |
| 全自动回归套件 | 通过 | 门锁， 环形政策， 存在聚变， LD2450 解析器， 回合二 UI, 任务 8.3/8.4, 棋盘配置， 和行人过滤检查都通过。 |
| ESP-IDF 构建和 COM5 烧录 | 通过 | `doorbell_demo.bin` 这是 `0x65e270` 字节; 6,677,写了104个应用字节，并验证了散列。 |
| 真实的人进出视线 | 待手动验证 | 首先清除浏览器事件历史. 将空视图保留数秒钟， 然后在镜头中清晰地站立至少两秒钟，然后离开. 期待一个组合镜头人集，没有空景事件。 |

## 2026-09-09 近地照相机维修

| 检查 | 状态 | 证据 |
|---|---|---|
| 探测器范围健康 | 通过 | 第一个 RGB565 帧全部为零， 现在被忽略. 框架2-12在每一个样本上都完全有人居住并有所改变。 |
| 整个框架的虚假结果 | 通过 | 几何过滤继续被拒绝 `[0,0,319,179]` 即使在恢复模型的 0.70 分数阈值。 |
| 近地相机倒置 | 通过（主机测试） | 测试拒绝静态场景和统一的曝光变化， 并接受占抽样像素8%以上的本地化人大小变化。 |
| 多式联运安全 | 通过（主机测试） | 相机运动只供应现有聚变的相机侧面; 雷达确认， 冷却和单环访问规则仍然是强制性的。 |
| 固件构建和烧录 | 通过 | 满 ESP-IDF 构建成功， 图像被写入并验证 COM5。 |
| 互动对接 | 待手动验证 | 打开页面， 数秒后仍无法查看， 然后输入 radar/camera 区域并移动10秒. 期待一个进场戒指 没有空场戒指。 |

申请现在至少需要自信 `0.75`, 边框
区域间 `0.5%` 联合国 `85%` 显示探测器框架， 和三个空间
重叠框架 (木卫一至少 `25%`) 在举报人之前. 确认
在三个漏掉的框架后清除存在. 这些是应用级别
周围的警卫 ESP-DL 结果; 他们不会改变 H.264 WebRTC 视频路径。

## 2026-09-10 语义行人+脸部检测

P4 序列端口: `COM5`  
当前页面: `https://192.168.0.103/webrtc/test`  
运行时证据: `docs/bringup/logs/2026-09-10-hybrid-person-detection-runtime.log`

| 检查 | 状态 | 证据 |
|---|---|---|
| 正式型号兼容性 | 通过 | ESP-DL `3.3.11`, 行人探测器 `0.3.2`, 和人脸检测 `0.5.0` 解决和汇编. 人脸 `0.2.3` 因为它的执行使用了更古老的 ESP-DL API。 |
| 完全固件构建 | 通过 | `doorbell_demo.bin` 这是 `0x693540` 字节; 8米B厂分区保留 `0x16cac0` 字节 (18%). 模式库和嵌入式中文页面都链接到最后 ELF。 |
| 自动回归套件 | 通过 | 全部11个 `verify_*.py` 通过脚本， 包括跟踪器， 序列器， 聚变， 门锁， 雷达， UI, 状态扩展连接和棋盘配置. 嵌入式 JavaScript 语法也通过。 |
| COM5 烧录 | 通过 | 装弹机， 6,894,912字节应用程序和分区表写在115200 baud; 每个图像散列已校验 RTS 硬重置成功。 |
| 核心硬件启动 | 通过 | 16个米B QIO 烧录， 32个小米B PSRAM/自我测试， ES8311, OV5647, LD2450, C5 四位数 SDIO, Wi-Fi, HTTPS 页:1 RGB565 320×180@2 FPS 启动探测器槽。 |
| 行人和面部模型启动 | 通过 | 序列日志: `Vision models: pedestrian=ready face=ready`. 现场直播 SSE 独立报告两个模型状态为： `ready` 大约2赫兹。 |
| 现场中文重叠部署 | 通过 | 董事会寄回的页面 HTTP 200 并包含对齐的画布框， 中文 person/model 状态， 雷达距离， 仅过渡历史和3 000ms stale 清除。 |
| 空视图第一观察 | 通过（短时测试） | 记录到的现场快照 `state=clear`, `person_count=0`, 观察窗口期间没有目标也没有模型故障。 |
| Person/near-face 准确性 | 待手动验证 | 进入摄像头和雷达区域， 然后接近，直到仅 head/shoulders 保留. 确认绿色行人或黄色脸盒 和明智的分数; 无法从空视图日志建立此选项。 |
| 5分钟假阳性检查 | 待手动验证 | 把镜头留空五分钟. 肯定没有人形状态或自动戒指。 |
| 三通电话和15分钟回归 | 待手动验证 | 重复 ring/answer/open/hang-up 3次，1次通话至少15分钟， 检查 audio/video 回应和 AI 降解记录。 |

实时 `vision_state` 快照覆盖上一个浏览器状态并完成
不增加事件历史. 只有状态过渡创建记录. 动议是
调度器只提示且无法满足自动铃声的相机侧面。
身份识别和物理特征 LCD 未来未开始的延期
统一后点数 vision/status 接口。
