wudi-tech/esp32-p4-c5-webrtc-doorbell/docs/bringup/logs/2026-09-09-camera-near-field-confirmation.md

# 2026-09-09 相机近场确认

## 根产生证据

- 那个 OV5647 页:1 RGB565 探测器路径通常在 320 x 180 和
  2小时。
- 第一个获得的 RGB565 缓冲器是一个未准备好的全零框架. 框架 2
  1800个样本的字节非零和不同的散列， 这样
  活捉路径本身没有冻结。
- ESP-DL 多次返回剪辑的完整框， 例如
  `[0,0,319,179]` 联 合 国 empty/near-field 场景， 而真正的近地访问
  没有生产任何可信的局部行人箱. 早先的完整框架
  因此，结果不能证明个人推断是成功的。
- LD2450 enter/leave 在同几届会议期间，过渡工作继续进行。

## 修理

- 忽略未准备好的全零启动框架并同步 DMA-备份框架
  在此之前 CPU 访问。
- 将行人模型得分阈值恢复到 0.70 默认; 几何学
  时间检查继续拒绝全面错误结果。
- 探测四个有效的 RGB565 byte/channel 解释直至稳定,
  本地化行人结果可识别直播格式。
- 保留 ESP-DL 行人探测器， 并添加近场相机动作
  确认路径. 它能消除统一的暴露变化， 要求至少为8%
  本地化框架变化， 并且只达到现有的多式联运聚变。
  雷达的存在和冷却资格仍然是环的强制性条件。

## 核查

- 主机测试覆盖无效的启动缓冲器， 静态场景， 统一接触
  变动， 本地化人员大小变化， 格式 cycling/locking, 整个框架
  虚假结果拒绝， 和雷达相机聚变。
- 全数 ESP-IDF 图像成功构建并被闪到 ESP32-P4 打开
  COM5. 它不慌不慌地飞走了， 获得 `192.168.0.103`, 已交付
  改变现场 RGB565 边框。
- 仍然需要最后互动的对接观察; 没有雷达进入或
  在烧录后抓取窗口中发生了限定相机移动。
