wudi-tech/esp32-p4-c5-webrtc-doorbell/docs/archive/acrylic-design/specs/2026-09-10-single-acrylic-test-rig-design.md

# 单块亚克力双面开发样机设计

日期：2026-09-10

## 1. 目标

制作一套便于开发调试的开放式硬件载台。整机只使用一块透明亚克力主载板：

- 正面安装 WT99P4C5-S1 主板、OV5647 摄像头、HLK-LD2450 雷达、扬声器、MG90S 舵机和示意门。
- 背面安装三路可调降压板。
- 四周设置铜柱，保护正反面器件并允许载台平放。
- 所有接口保持可访问，不设置封闭外壳。

## 2. 不可破坏的安装约束

### 摄像头

- 摄像头柔性模组与主板正面平行并基本共面。
- 摄像头位于 MIPI-CSI 接口中心线正下方，禁止左右错位或扭带。
- 主板 PCB 边缘到镜头中心的实测距离约 50 mm。
- 排线沿同一平面直线延伸；只允许少量前后浮动释放装配应力。
- 摄像头托架的承托面与主板 PCB 平面一致，均位于亚克力板正面约 8 mm。

### 雷达

- HLK-LD2450 竖向安装：44 mm 方向竖直，15 mm 方向水平。
- 带缺口的短边朝上。
- 金色天线面朝门外/行人，元器件密集面朝亚克力板。
- 从门外正对天线面观看：左侧为 +X，右侧为 -X；垂直天线面向外为 +Y。
- 雷达安装在摄像头左侧，不占用 CSI 排线的直线通道。
- 雷达天线面与摄像头焦平面平行，两者共同朝向 +Y。
- 雷达正面保持开放；若后来增加保护片，应使用无金属涂层的均匀非金属薄片，并与天线面保持 3–5 mm。

### 电源与舵机

- 降压板装在载板背面并与正面的雷达横向错开。
- 电源线沿载板右侧走线，不穿越摄像头排线区域。
- 舵机和示意门位于正面右上区域。
- 门片由独立铰链承重；舵机通过连杆驱动，舵机输出轴不直接承受门重。

## 3. 结构尺寸基线

| 项目 | 规格 |
| --- | --- |
| 主载板 | 透明浇铸亚克力，220 × 190 × 5 mm，四角 R10 |
| 主板安装 | 横向放置，孔中心距 114.95 mm（横向）× 84.96 mm（纵向） |
| 主板离载板距离 | 8 mm |
| 摄像头中心线 | 与 MIPI-CSI 接口中心重合；板边至镜头中心约 50 mm |
| 雷达安装净空 | 模组四周各 ≥2 mm，背面器件与支架不干涉 |
| 降压板预留空间 | ≥88 × 64 × 21 mm |
| 降压板离载板距离 | 10 mm，元件面朝外 |
| 正面保护铜柱 | 40 mm |
| 背面保护铜柱 | 35 mm |

正、背面保护铜柱共用四个角部安装孔。每组使用一根 M3 × 16 mm 无头螺柱穿过 5 mm 亚克力板，将正面的 40 mm 双通铜柱与背面的 35 mm 双通铜柱连接；螺柱在两侧各保留约 5.5 mm 有效啮合长度。

## 4. 电子与功能部件

| 编号 | 名称 | 规格 | 数量 | 备注 |
| --- | --- | --- | ---: | --- |
| E01 | 主板 | WT99P4C5-S1 1V1，PCB 90 × 120 × 1.6 mm | 1 | 已有 |
| E02 | 摄像头 | OV5647 MIPI-CSI 柔性模组，板边至镜头中心约 50 mm | 1 | 已有 |
| E03 | 雷达 | HLK-LD2450，44 × 15 mm，5 V，平均约 120 mA | 1 | 已有 |
| E04 | 舵机 | MG90S/GX90S 180°，本体约 22.8 × 12.2 × 28.5 mm，21T | 1 | 已有或采购 |
| E05 | 降压板 | 三路可调，85.1 × 61.45 × 18.1 mm，输入 6–24 V | 1 | 已有 |
| E06 | 扬声器 | 3525 长方形/椭圆扬声器，机械外形约 35 × 25 mm，4 Ω / 3 W | 1 | 本版平面加工图不约束扬声器厚度 |
| E07 | 输入适配器 | 推荐 12 V / 3 A 稳压适配器，DC 5.5 × 2.1 mm、中心正极 | 1 | 现有 9 V / 2.22 A 可先用于轻载调试 |
| E08 | DC 面板插座 | 5.5 × 2.1 mm，额定 ≥3 A | 1 | 安装在载板背面右下 |
| E09 | 电源开关 | 单刀单掷，额定 ≥5 A / 12 V | 1 | 串联在适配器输入侧 |
| E10 | 保险丝组件 | 可更换式或自恢复式，3 A | 1 | 靠近输入插座 |

不要把 5 V / 3 A 适配器接入要求 6–24 V 输入的降压板。若使用 5 V / 3 A，必须绕过降压板并确认所有负载允许直接由该电源供电。

## 5. 定制结构件

| 编号 | 名称 | 规格 | 数量 |
| --- | --- | --- | ---: |
| S01 | 亚克力主载板 | 透明浇铸 PMMA，220 × 190 × 5 mm，R10，激光切割 | 1 |
| S02 | 摄像头绝缘托架 | PETG，通道宽 15–16 mm，承托面距亚克力 8 mm，中心线与 CSI 对齐 | 1 |
| S03 | 雷达绝缘夹具 | PETG，内部净空约 46 × 17 mm，竖装并露出顶部缺口 | 1 |
| S04 | 舵机支架 | PETG，舵机仓净空至少 24.8 × 14.2 × 30.5 mm，安装孔距 22.5 mm | 1 |
| S05 | 示意门 | PETG，约 60 × 100 × 2 mm | 1 |
| S06 | 扬声器托架 | PETG，内部基准净空 35.5 × 25.5 mm，四周弹性卡扣固定 | 1 |
| S07 | 扬声器隔振垫 | EVA 或硅胶，厚 1 mm，按 35 × 25 mm 外廓裁切 | 1 |

摄像头和雷达夹具不得使用金属涂层；夹具边缘不得压伤柔性排线。

## 6. 铜柱、螺钉与垫片

| 编号 | 名称 | 规格 | 数量 | 用途 |
| --- | --- | --- | ---: | --- |
| F01 | 黄铜六角铜柱 | M3，双通，8 mm | 4 | 主板 |
| F02 | 黄铜六角铜柱 | M2，双通，10 mm | 4 | 降压板 |
| F03 | 黄铜六角铜柱 | M3，双通，40 mm | 4 | 正面四周保护 |
| F04 | 黄铜六角铜柱 | M3，双通，35 mm | 4 | 背面四周保护 |
| F05 | M3 无头螺柱 | M3 × 16 mm | 4 | 穿过 5 mm 亚克力并连接正、背保护铜柱 |
| F06 | M3 螺钉 | M3 × 10 mm | 4 | 主板铜柱穿过 5 mm 亚克力固定 |
| F07 | M3 螺钉 | M3 × 6 mm | 12 | 主板顶端和八个保护柱端部 |
| F08 | M2 螺钉 | M2 × 8 mm | 4 | 降压板铜柱穿过亚克力固定 |
| F09 | M2 螺钉 | M2 × 5 mm | 4 | 降压板固定 |
| F10 | M3 尼龙垫片 | 内径 3.2 mm，厚 0.5–1 mm | 16 | 主板及铜柱与亚克力隔离 |
| F11 | M2 尼龙垫片 | 内径 2.2 mm，厚 0.5–1 mm | 8 | 降压板隔离 |
| F12 | M2 螺钉、垫片、锁紧螺母 | M2 × 10 mm | 各 4 | 舵机耳与舵机支架 |
| F13 | M2.5 螺钉、垫片、锁紧螺母 | M2.5 × 10 mm | 各 12 | 摄像头、雷达、扬声器和支架固定 |
| F14 | 橡胶端帽或脚垫 | 适配 M3 铜柱端部 | 8 | 正、背面保护柱防滑 |

主板安装孔为 Ø4 mm，配 M3 紧固件时必须在 PCB 两侧使用尼龙垫片。安装前检查孔周是否存在裸露铜箔。

## 7. 舵机门机构

| 编号 | 名称 | 规格 | 数量 |
| --- | --- | --- | ---: |
| M01 | 舵机摇臂 | MG90S 21T，单臂或双臂 | 1 |
| M02 | 微型尼龙合页 | 长 20–25 mm | 2 |
| M03 | 连杆 | Ø1.2 mm 钢丝或 M2 连杆，长约 100 mm | 1 |
| M04 | 连杆锁扣 | 适配 Ø1.2 mm 或 M2 连杆 | 2 |

## 8. 线材与布线辅料

| 编号 | 名称 | 规格 | 数量 |
| --- | --- | --- | ---: |
| W01 | 输入电源线 | 红/黑双芯硅胶线，18 AWG | 1 m |
| W02 | 5 V 分配线 | 红/黑双芯硅胶线，22 AWG | 2 m |
| W03 | 信号线 | 26 AWG 多色硅胶线 | 2 m |
| W04 | 雷达插头线 | 2.0 mm 间距、匹配 LD2450 接口，4 芯，约 200 mm | 1 |
| W05 | 扬声器插头线 | 2.0 mm 间距、2 芯，约 300 mm | 1 |
| W06 | 主板供电线 | 短 USB-C 供电线或确认极性的 USB-C 电源尾线 | 1 |
| W07 | 绝缘热缩管 | Ø2/3/4/6 mm 混合套装 | 1 套 |
| W08 | 尼龙扎带 | 2.5 × 100 mm | 20 |
| W09 | 自粘扎带座 | 20 × 20 mm | 8 |
| W10 | 压线端子/冷压端头 | 适配 18–26 AWG | 1 套 |

摄像头排线路径内不设置扎带座或其他线束。电源线与信号线分开走线。

## 9. 亚克力板加工孔

下单加工前输出 DXF，并至少包含：

- 主板孔：Ø3.2 mm × 4，当前横向布局中心距 114.95 × 84.96 mm。
- 降压板孔：Ø2.2 mm × 4，中心距 58 × 49 mm。
- 正、背面共用保护柱孔：Ø3.2 mm × 4，孔中心距相邻板边 10 mm。
- 摄像头、雷达、舵机和扬声器支架孔：Ø2.7 mm，按最终支架模型布置。
- 电源线扎带槽：3 × 8 mm，沿载板右侧设置 4 组。

## 10. 下单前检查

1. 实测主板最高器件及所有插头插入后的空间。
2. 确认摄像头在 50 mm 直线路径上无拉力、无横向扭曲。
3. 确认雷达缺口朝上，金色天线面朝 +Y。
4. 复核 3525 扬声器的实际长宽和出线位置；托架内腔以实物外形加 0.3–0.5 mm 单边间隙为准。
5. 确认降压板输入、各路输出电压和极性后再连接主板、雷达和舵机。
6. 在纸板上按 1:1 打印孔位并摆放全部实物，确认无干涉后再切割亚克力。
