wudi-tech/esp32-p4-c5-webrtc-doorbell/components/av_render/CHANGELOG.md

# 变更记录

## v1.0.0

- 使用 `esp_image_effects` 进行颜色转换

## v0.9.2

- 碰撞 `esp_audio_codec`, `esp_audio_effects` 版本到 v2.5 和 v1.3

## v0.9.1

- 修复缺失的依赖项
- 添加了示例代码

## v0.9.0

- 初始版本 `av_render`
