wudi-tech/esp32-p4-c5-webrtc-doorbell/components/esp_peer/CHANGELOG.md

# 变更记录

## v1.5.3

- 固定 IDF v6 / mbedTLS 数据 4.1 第一启动 DTLS 握手失败 (`-0x6e00`): 使用客户端 Hello
  重新组装 BIO, 强数据格传输， 每次会议计时器， 更严格 cookie/PSA 输入

## v1.5.2

### 问题修复

- 固定握手失败返回 `-0x7080` 下面的mbedTLS版本 v3.6.6

## v1.5.1

### 问题修复

- 固定渗漏 DTLS 重新设置
- 固定数据通道仍然创建甚至对等 sdp 不包含数据通道
- 固定攻击性 SCTP 重新发送逻辑， 使用指数重寄时间作为浏览器

## v1.5.0

### 功能

- 已添加 TCP 联合国 TURNS 对代理的支持

## v1.4.2

### 功能

- 于 SDP 连接时更改
- 添加 ECDSA 256项支助

### 问题修复

- 担任受控职务时过早的固定提名候选人
- 处理 DTLS 当端点发送时作为客户端的作用 `actpass`
- 处理 `MBEDTLS_ERR_SSL_CLIENT_RECONNECT` 作为已断开
- 由于 DCEP 未转发的消息
- 由于 DTLS 资源不自由

## v1.4.1

### 功能

- 已添加 `esp32s31` 目标支持

## v1.4.0

### 功能

- 已添加 ESP-IDF v6.0 支助 (向后兼容 IDF v5.x)
- ICE 非启动同伴的语法模式: 启用的答录器 (非报价 SDP) 充当控制代理人
- RTP 端口解析从 SDP: 为 FreeSWITCH 添加支持 WebRTC 服务器兼容性
- 改良 DTLS 用于更快会话设置的预生成验证密钥
- 固定过早 ICE 提名
  - 防止在最后提名前过早发出使用认证属性信令

## v1.3.4

### 功能

- 已添加 `alive_binding_retries` 配置绑定最大重试，然后断开
  - 绑定重试是一种恒生机制，用于检测意外的同行休假
- 如果远程候选人无法接受，则固定连接检查失败 (TCP 类)
- 添加视频 RTP RTX 支助

### 问题修复

- 如果 RTT 超过400米

## v1.3.3

### 功能

- 支助 PLI 间隔设置， 以便控制浏览器密钥框发送行为

## v1.3.2

### 问题修复

- 由于没有更新权限， 10min 后与 turn 服务器的固定自动断开

### 功能

- 已添加 ICE 通过配置支持公升数 `ice_use_lite_mode`

## v1.3.1

### 问题修复

- 由于用户名太长， 某些回合服务器无法连接

## v1.3.0~1

### 问题修复

- 固定的 esp32c5 库无法基于 IDFv5.5.2

## v1.3.0

### 问题修复

- 接收造成的固定坠毁 SCTP 创建数据通道前的消息
- 固定错误 H264 被对等点控制时的配置用途
- 固定种族条件 SCTP 参考计算
- 固定误导指纹核查错误日志
- 负数导致的固定坠机 KMS 服务器优先级值
- 仍在使用期间的固定剂退出使用

### 功能

- 已添加 RTP 变压器支持 (自定义包处理)
- 已添加 H264 RTP 解码器支持
- 添加了 IPv6 兼容性
- 添加基于 SDP
- 添加代理参数验证
- 添加接收锁定， 防止同时处理包时发生碰撞
- 添加弱项 UDP 运输的实施 (对不可靠的网络进行回落)
- 已添加 DTLS close_notify 处理优雅的断开
- 可配置上限 ICE 候选人

## v1.2.7

### 问题修复

- 固定的不可靠的数据通道 TSN 以 0 设置限制时不发送
- 固定 DTLS 角色不遵循 sdp 答案

## v1.2.6

### 问题修复

- 已添加 `msid` 支持在 SDP
- 固定垫装问题 TURN 服务器中继包
- 固定种族条件 SCTP 参考数
- 固定错误的指纹错误日志输出

### 功能

- 添加 ep32c5 支持

## v1.2.5

### 问题修复

- 固定崩溃回归时 ICE 服务器编号设置为 0
- 只设置固定继电器无法构建连接

## v1.2.4

### 问题修复

- 固定一些回合服务器无法连接
- 提高连接稳定性使用中继服务器
- 固定 `mbedtls_ssl_write` 由于解冻失败
- 断开时继续活着检查时的固定崩溃
- 已添加 DTLS 用于线刹分析的密钥打印

## v1.2.3

### 功能

- 添加对 IDFv6.0
- 已添加 API `esp_peer_pre_generate_cert` 遗传前 DTLS 键

### 问题修复

- 固定建构错误 IDFv6.0
- 制作 DTLS 要开源的模块
- 未遵循固定数据通道角色 DTLS 角色

## v1.2.2

### 问题修复

- 组件名称错配的固定构建错误

## v1.2.1

### 功能

- 制作 `esp_peer` 作为单独的模块 ESP 书记官处
- 允许 RTP 滚动缓冲器 RAM

### 问题修复

- 如果代理服务器在连接检查中收到握手消息， 固定握手可能出错

## v1.2.0

### 功能

- 添加可靠且无序的数据通道支持
- 已添加 FORWARD-TSN 对未排序的数据通道的支持

### 问题修复

- 修复了如果代理只有本地候选，保持连接检查不生效的问题
- 如果远程候选已经获取，则未设置固定代理模式

## v1.1.0

### 功能

- 导出缓冲区配置为 RTP 和数据通道
- 已添加对多个数据通道的支持
- 已添加数据通道打开的通知， 关闭事件

### 问题修复

- 修复在对端意外关闭时保持活动检查不起作用的问题

## v1.0.0

- 初始版本 `peer_default`
