wudi-tech/esp32-p4-c5-webrtc-doorbell/components/esp_webrtc/CHANGELOG.md

# 变更记录

## v0.9.1

### 功能

- 更新依赖 `esp_capture` 版本到 v1.0

### 问题修复

- 固定捕获预启动然后启动 WebRTC, 过早启用接收器会导致读取源数据超时
