wudi-tech/esp32-p4-c5-webrtc-doorbell/components/media_lib_utils/CHANGELOG.md

# 变更记录

## v0.9.0

- 初始版本 `media_lib_utils`
