wudi-tech/esp32-p4-c5-webrtc-doorbell/docs/superpowers/specs/2026-09-07-doorbell-round-two-fixes-design.md

# 门铃圆形双可靠性修复器设计

## 范围

本轮修正了这五种行为 WT99P4C5-S1 测试页面：

1. 打开的语音提示是安静的 WebRTC 调用已激活。
2. 雷达事件分离器 (`â€”`)。
3. 连续的行人推论创建了一个不断增加的事件数。
4. 4秒后板子停止鸣叫 而浏览器永远响起。
5. 浏览器可以显示 `Call ended` 时 video/audio 仍在运行。

现存的门锁， 雷达聚变， WebRTC, 摄影机， 麦克风行为依然有效。

## 根源

- 开门 AAC 快速进入 WebRTC 音频共享相同 `av_render` 播放器. 添加 AAC 流取代活动 Opus 解码器， 所以现在的警卫在呼叫中故意压制提示。
- 那个 HTTP 仅声明响应 `text/html`; 页面包含 UTF-8 点， 因此浏览器可以解码字节为 Windows-1252。
- 行人探测器多次报告成功帧 (每秒约两次), 页面将每个框架视为新事件。
- 董事会的响声有四秒长， 页面循环音频没有板驱动的停止命令。
- 挂断是火和遗忘: 页面从本地撕裂，并报告成功之前 P4 完成对端连接。

## 设计

### 接听的开门提示

启动时， 解码已嵌入 `open.aac` 与已经注册的 Espressif AAC 解码器并重新显示为 16 kHz, 单， 签名 16 位 PCM. 在内存中保留由此产生的快速缓冲. 环绕现有的 I2S 装有小叠叠的渲染器，将导火线混合成解码器 WebRTC PCM 使用饱和加法. 包装打开， 关闭， 延迟， 速度， 和帧- info 调用到已有的渲染器， 并且绝不改变活动 Opus 解码器。

在连接的电话之外， 保留已有的 AAC 播放路径. 在连接电话中， 启动 PCM 覆盖代替. 如果快速准备失败或渲染格式不兼容， 在不中断呼叫或门操作的情况下登录精确错误。

### 文本和传感器事件语义

将测试页作为 `text/html; charset=utf-8` 并使用 ASCII 在生成的雷达文本中分隔符. 重命名控件从 `Detection Events` 改为 `Sensor Events` 并添加解释性案文: 列表包含雷达 enter/leave 片段和镜头人物-现场片段， 不是一个坚持不懈的人。

浏览器将分组重复 `PEDESTRIAN_DETECTED` 信件输入一个插曲. 重复的信件刷新短的不活动定时器; 仅在上一集过期后才创建新的列表项. 现有的100个入境历史限制仍然是第二个安全界限。

### 环同步

每一个接受的环都得到一个单调的生成数. 板工等待的四秒钟时间 与当地的语气相同 `RING_STOPPED` 只有那一代还是现在的戒指. 这阻止了老工人阻止新戒指. 浏览器停止循环 `RING_STOPPED` 如果事件丢失， 还会使用稍长的倒计时器。

### 确认挂断

页面输入 `Ending call...` 状态和发送 `DENY_CALL`, 但将媒体保留到 P4 确认拆解. 之后 `esp_webrtc_enable_peer_connection(..., false)` 结束， 联合国 P4 发送 `CALL_ENDED`; 失败发送 `CALL_END_FAILED`. 仅 `CALL_ENDED`, a 远程 `bye`, 或终端对等连接状态进行局部清理并清除视频元素. 超时恢复挂起按钮， 并报告没有收到确认。

## 核查

- 土著单位测试覆盖率 PCM 覆盖 start/restart/completion 并签名 16 位饱和度。
- Static/behavioral 页面检查封面 UTF-8, 分组人物集， 环 stop/fallback, 承认挂断， 和明确的媒体内容清理。
- 现有任务 7/8 校验脚本和本地测试继续通过。
- 满 ESP-IDF 建构必须在闪烁前成功 COM5。
- 硬件烟雾测试: 电话， 呼叫时开门， 挂断， 触发新环， 并确认传感器历史行为。

## 安全性和兼容性

- 覆盖层仅修改输出扬声器 PCM 并保留回声消除使用的混合音频参考。
- 门的移动保持独立于提示播放; 音频故障不能阻塞或逆转伺服状态机。
- 现有的信令命令名称仍然有效; 新命令是附加的。
- 无需更改分区布局或硬件引脚分配。
