wudi-tech/esp32-p4-c5-webrtc-doorbell/components/esp_peer/src/dtls_srtp.c

/*
 * SPDX-FileCopyrightText: 2025 Espressif Systems (Shanghai) CO., LTD
 * SPDX-License-Identifier: LicenseRef-Espressif-Modified-MIT
 *
 * See LICENSE file for details.
 */

// #define DUMP_DTLS_KEY
#include "dtls_common.h"
#include "mbedtls/ecp.h"

static int dtls_srtp_selfsign_cert(dtls_srtp_t *dtls_srtp, bool export_for_cache)
{
    int ret;
    mbedtls_x509write_cert crt;
    unsigned char *cert_buf = (unsigned char *)malloc(DTLS_CERT_PEM_BUF_SIZE);
    if (cert_buf == NULL) {
        return -1;
    }
    const char *pers = "dtls_srtp";

    mbedtls_x509write_crt_init(&crt);
    ret = mbedtls_ctr_drbg_seed(&dtls_srtp->ctr_drbg, dtls_srtp_entropy_func, NULL, (const unsigned char *)pers,
                                strlen(pers));
    if (ret != 0) {
        ESP_LOGE(TAG, "mbedtls_ctr_drbg_seed failed, ret=%d", ret);
        goto _exit;
    }
    ret = mbedtls_pk_setup(&dtls_srtp->pkey, mbedtls_pk_info_from_type(MBEDTLS_PK_ECKEY));
    if (ret != 0) {
        ESP_LOGE(TAG, "mbedtls_pk_setup(ECKEY) failed, ret=%d", ret);
        goto _exit;
    }
    ret = mbedtls_ecp_gen_key(MBEDTLS_ECP_DP_SECP256R1, mbedtls_pk_ec(dtls_srtp->pkey),
                              mbedtls_ctr_drbg_random, &dtls_srtp->ctr_drbg);
    if (ret != 0) {
        ESP_LOGE(TAG, "mbedtls_ecp_gen_key failed, ret=%d", ret);
        goto _exit;
    }

    mbedtls_x509write_crt_set_version(&crt, MBEDTLS_X509_CRT_VERSION_3);
    mbedtls_x509write_crt_set_md_alg(&crt, MBEDTLS_MD_SHA256);
    mbedtls_x509write_crt_set_subject_name(&crt, "CN=dtls_srtp");
    mbedtls_x509write_crt_set_issuer_name(&crt, "CN=dtls_srtp");

#if MBEDTLS_VERSION_MAJOR == 3 && MBEDTLS_VERSION_MINOR >= 4 || MBEDTLS_VERSION_MAJOR >= 4
    unsigned char *serial = (unsigned char *)"1";
    size_t serial_len = 1;
    ret = mbedtls_x509write_crt_set_serial_raw(&crt, serial, serial_len);
    if (ret < 0) {
        printf("mbedtls_x509write_crt_set_serial_raw failed\n");
    }
#else
    mbedtls_mpi serial;
    mbedtls_mpi_init(&serial);
    mbedtls_mpi_fill_random(&serial, 16, mbedtls_ctr_drbg_random, &dtls_srtp->ctr_drbg);
    mbedtls_x509write_crt_set_serial(&crt, &serial);
    mbedtls_mpi_free(&serial);
#endif

    mbedtls_x509write_crt_set_validity(&crt, "20230101000000", "20280101000000");
    mbedtls_x509write_crt_set_subject_key(&crt, &dtls_srtp->pkey);
    mbedtls_x509write_crt_set_issuer_key(&crt, &dtls_srtp->pkey);
    ret = mbedtls_x509write_crt_pem(&crt, cert_buf, DTLS_CERT_PEM_BUF_SIZE, mbedtls_ctr_drbg_random,
                                    &dtls_srtp->ctr_drbg);
    if (ret < 0) {
        ESP_LOGE(TAG, "mbedtls_x509write_crt_pem failed");
        goto _exit;
    }
    ret = mbedtls_x509_crt_parse(&dtls_srtp->cert, cert_buf, DTLS_CERT_PEM_BUF_SIZE);
    if (ret != 0) {
        ESP_LOGE(TAG, "mbedtls_x509_crt_parse failed, ret=%d", ret);
        goto _exit;
    }
    if (export_for_cache) {
#ifdef DTLS_SIGN_ONCE
        ret = mbedtls_pk_write_key_pem(&dtls_srtp->pkey, s_cached_key_pem, sizeof(s_cached_key_pem));
        if (ret != 0) {
            ESP_LOGE(TAG, "mbedtls_pk_write_key_pem failed, ret=%d", ret);
            goto _exit;
        }
        memcpy(s_cached_cert_pem, cert_buf, sizeof(s_cached_cert_pem));
        s_cached_cert_ready = true;
#endif
    }
    ret = 0;
_exit:
    mbedtls_x509write_crt_free(&crt);
    free(cert_buf);
    return ret;
}

static int dtls_srtp_try_gen_cert(dtls_srtp_t *dtls_srtp)
{
    int ret = 0;
    mbedtls_x509_crt_init(&dtls_srtp->cert);
    mbedtls_pk_init(&dtls_srtp->pkey);
    mbedtls_ctr_drbg_init(&dtls_srtp->ctr_drbg);
    const char *pers = "dtls_srtp";
    ret = mbedtls_ctr_drbg_seed(&dtls_srtp->ctr_drbg, dtls_srtp_entropy_func, NULL, (const unsigned char *)pers,
                                strlen(pers));
    if (ret != 0) {
        ESP_LOGE(TAG, "mbedtls_ctr_drbg_seed failed, ret=%d", ret);
        return ret;
    }
#ifdef DTLS_SIGN_ONCE
    if (s_cached_cert_ready) {
        size_t cert_pem_len = strlen((const char *)s_cached_cert_pem) + 1;
        size_t key_pem_len = strlen((const char *)s_cached_key_pem) + 1;
        ret = mbedtls_x509_crt_parse(&dtls_srtp->cert, s_cached_cert_pem, cert_pem_len);
        if (ret == 0) {
            ret = mbedtls_pk_parse_key(&dtls_srtp->pkey, s_cached_key_pem, key_pem_len, NULL, 0,
                                       mbedtls_ctr_drbg_random, &dtls_srtp->ctr_drbg);
        }
        if (ret == 0) {
            return 0;
        }
        ESP_LOGE(TAG, "Use cached cert/key failed, fallback to regenerate, ret=%d", ret);
    }
#endif
    ret = dtls_srtp_selfsign_cert(dtls_srtp, true);
    if (ret != 0) {
        return ret;
    }
    return 0;
}

int dtls_srtp_gen_cert(void)
{
#ifdef DTLS_SIGN_ONCE
    dtls_srtp_t *dtls_srtp = (dtls_srtp_t *) media_lib_calloc(1, sizeof(dtls_srtp_t));
    if (dtls_srtp == NULL) {
        return -1;
    }
    mbedtls_x509_crt_init(&dtls_srtp->cert);
    mbedtls_pk_init(&dtls_srtp->pkey);
    mbedtls_ctr_drbg_init(&dtls_srtp->ctr_drbg);
    int ret = dtls_srtp_selfsign_cert(dtls_srtp, true);
    dtls_srtp_deinit(dtls_srtp);
    media_lib_free(dtls_srtp);
    return ret;
#else
    return -1;
#endif
}

dtls_srtp_t *dtls_srtp_init(dtls_srtp_cfg_t *cfg)
{
    dtls_srtp_t *dtls_srtp = (dtls_srtp_t *) media_lib_calloc(1, sizeof(dtls_srtp_t));
    if (dtls_srtp == NULL) {
        return NULL;
    }
    int ret = check_srtp(true);
    do {
        BREAK_ON_FAIL(ret);
        media_lib_mutex_create(&dtls_srtp->lock);
        dtls_srtp->role = cfg->role;
        dtls_srtp->state = DTLS_SRTP_STATE_INIT;
        dtls_srtp->ctx = cfg->ctx;
        dtls_srtp->udp_send = cfg->udp_send;
        dtls_srtp->udp_recv = cfg->udp_recv;

        mbedtls_ssl_config_init(&dtls_srtp->conf);
        mbedtls_ssl_init(&dtls_srtp->ssl);
        ret = dtls_srtp_try_gen_cert(dtls_srtp);
        BREAK_ON_FAIL(ret);

        if (dtls_srtp->role == DTLS_SRTP_ROLE_SERVER) {
            ret = mbedtls_ssl_config_defaults(&dtls_srtp->conf, MBEDTLS_SSL_IS_SERVER, MBEDTLS_SSL_TRANSPORT_DATAGRAM,
                                              MBEDTLS_SSL_PRESET_DEFAULT);
            mbedtls_ssl_cookie_init(&dtls_srtp->cookie_ctx);
            mbedtls_ssl_cookie_setup(&dtls_srtp->cookie_ctx, mbedtls_ctr_drbg_random, &dtls_srtp->ctr_drbg);
            mbedtls_ssl_conf_dtls_cookies(&dtls_srtp->conf, mbedtls_ssl_cookie_write, mbedtls_ssl_cookie_check,
                                          &dtls_srtp->cookie_ctx);
        } else {
            ret = mbedtls_ssl_config_defaults(&dtls_srtp->conf, MBEDTLS_SSL_IS_CLIENT, MBEDTLS_SSL_TRANSPORT_DATAGRAM,
                                              MBEDTLS_SSL_PRESET_DEFAULT);
        }
        BREAK_ON_FAIL(ret);

        dtls_srtp_conf_force_dtls12(&dtls_srtp->conf);
        mbedtls_ssl_conf_ca_chain(&dtls_srtp->conf, &dtls_srtp->cert, NULL);
        ret = mbedtls_ssl_conf_own_cert(&dtls_srtp->conf, &dtls_srtp->cert, &dtls_srtp->pkey);
        BREAK_ON_FAIL(ret);
        mbedtls_ssl_conf_rng(&dtls_srtp->conf, mbedtls_ctr_drbg_random, &dtls_srtp->ctr_drbg);
        if (dtls_srtp->role == DTLS_SRTP_ROLE_CLIENT) {
            mbedtls_ssl_conf_authmode(&dtls_srtp->conf, MBEDTLS_SSL_VERIFY_OPTIONAL);
        }
        mbedtls_ssl_conf_read_timeout(&dtls_srtp->conf, 1000);
        mbedtls_ssl_conf_handshake_timeout(&dtls_srtp->conf, 1000, 6000);
        mbedtls_ssl_conf_dtls_anti_replay(&dtls_srtp->conf, MBEDTLS_SSL_ANTI_REPLAY_DISABLED);

        dtls_srtp_x509_digest(&dtls_srtp->cert, dtls_srtp->local_fingerprint);
        ret = mbedtls_ssl_conf_dtls_srtp_protection_profiles(&dtls_srtp->conf, default_profiles);
        BREAK_ON_FAIL(ret);

        mbedtls_ssl_conf_srtp_mki_value_supported(&dtls_srtp->conf, MBEDTLS_SSL_DTLS_SRTP_MKI_UNSUPPORTED);
        ret = mbedtls_ssl_setup(&dtls_srtp->ssl, &dtls_srtp->conf);
        BREAK_ON_FAIL(ret);
        mbedtls_ssl_set_mtu(&dtls_srtp->ssl, DTLS_MTU_SIZE);
        return dtls_srtp;
    } while (0);
    dtls_srtp_deinit(dtls_srtp);
    return NULL;
}

void dtls_srtp_deinit(dtls_srtp_t *dtls_srtp)
{
    if (dtls_srtp->state == DTLS_SRTP_STATE_NONE) {
        return;
    }
    mbedtls_ssl_free(&dtls_srtp->ssl);
    mbedtls_ssl_config_free(&dtls_srtp->conf);

    mbedtls_x509_crt_free(&dtls_srtp->cert);
    mbedtls_pk_free(&dtls_srtp->pkey);
    mbedtls_ctr_drbg_free(&dtls_srtp->ctr_drbg);

    if (dtls_srtp->role == DTLS_SRTP_ROLE_SERVER) {
        mbedtls_ssl_cookie_free(&dtls_srtp->cookie_ctx);
    }
#if defined(DTLS_USE_CH_REASM_BIO)
    dtls_srtp_ch_reasm_free(dtls_srtp);
#endif
    if (dtls_srtp->srtp_in) {
        srtp_dealloc(dtls_srtp->srtp_in);
        dtls_srtp->srtp_in = NULL;
    }
    if (dtls_srtp->srtp_out) {
        srtp_dealloc(dtls_srtp->srtp_out);
        dtls_srtp->srtp_out = NULL;
    }
    if (dtls_srtp->lock) {
        media_lib_mutex_destroy(dtls_srtp->lock);
    }
    check_srtp(false);
    dtls_srtp->state = DTLS_SRTP_STATE_NONE;
    media_lib_free(dtls_srtp);
}

void dtls_srtp_reset_session(dtls_srtp_t *dtls_srtp, dtls_srtp_role_t role)
{
    if (dtls_srtp->state == DTLS_SRTP_STATE_CONNECTED) {
        srtp_dealloc(dtls_srtp->srtp_in);
        dtls_srtp->srtp_in = NULL;
        srtp_dealloc(dtls_srtp->srtp_out);
        dtls_srtp->srtp_out = NULL;
    }
    mbedtls_ssl_session_reset(&dtls_srtp->ssl);
    mbedtls_timing_set_delay(&dtls_srtp->timer, 0, 0);
#if defined(DTLS_USE_CH_REASM_BIO)
    dtls_srtp_ch_reasm_free(dtls_srtp);
#endif
    if (role != dtls_srtp->role) {
        if (dtls_srtp->role == DTLS_SRTP_ROLE_SERVER) {
            mbedtls_ssl_cookie_free(&dtls_srtp->cookie_ctx);
        }
        if (role == DTLS_SRTP_ROLE_SERVER) {
            mbedtls_ssl_config_defaults(&dtls_srtp->conf, MBEDTLS_SSL_IS_SERVER, MBEDTLS_SSL_TRANSPORT_DATAGRAM,
                                        MBEDTLS_SSL_PRESET_DEFAULT);
            dtls_srtp_conf_force_dtls12(&dtls_srtp->conf);

            mbedtls_ssl_cookie_init(&dtls_srtp->cookie_ctx);
            mbedtls_ssl_cookie_setup(&dtls_srtp->cookie_ctx, mbedtls_ctr_drbg_random, &dtls_srtp->ctr_drbg);
            mbedtls_ssl_conf_dtls_cookies(&dtls_srtp->conf, mbedtls_ssl_cookie_write, mbedtls_ssl_cookie_check,
                                          &dtls_srtp->cookie_ctx);
        } else {
            mbedtls_ssl_config_defaults(&dtls_srtp->conf, MBEDTLS_SSL_IS_CLIENT, MBEDTLS_SSL_TRANSPORT_DATAGRAM,
                                        MBEDTLS_SSL_PRESET_DEFAULT);
            dtls_srtp_conf_force_dtls12(&dtls_srtp->conf);
            mbedtls_ssl_conf_authmode(&dtls_srtp->conf, MBEDTLS_SSL_VERIFY_OPTIONAL);
        }
        mbedtls_ssl_conf_ca_chain(&dtls_srtp->conf, &dtls_srtp->cert, NULL);
        mbedtls_ssl_conf_own_cert(&dtls_srtp->conf, &dtls_srtp->cert, &dtls_srtp->pkey);
        mbedtls_ssl_conf_rng(&dtls_srtp->conf, mbedtls_ctr_drbg_random, &dtls_srtp->ctr_drbg);
        mbedtls_ssl_conf_read_timeout(&dtls_srtp->conf, 1000);
        mbedtls_ssl_conf_handshake_timeout(&dtls_srtp->conf, 1000, 6000);
        mbedtls_ssl_conf_dtls_srtp_protection_profiles(&dtls_srtp->conf, default_profiles);
        mbedtls_ssl_conf_srtp_mki_value_supported(&dtls_srtp->conf, MBEDTLS_SSL_DTLS_SRTP_MKI_UNSUPPORTED);
        mbedtls_ssl_conf_dtls_anti_replay(&dtls_srtp->conf, MBEDTLS_SSL_ANTI_REPLAY_DISABLED);
        mbedtls_ssl_free(&dtls_srtp->ssl);
        mbedtls_ssl_init(&dtls_srtp->ssl);
        mbedtls_ssl_setup(&dtls_srtp->ssl, &dtls_srtp->conf);
        mbedtls_ssl_set_mtu(&dtls_srtp->ssl, DTLS_MTU_SIZE);
        dtls_srtp->role = role;
    }
    dtls_srtp->state = DTLS_SRTP_STATE_INIT;
}
