wudi-tech/esp32-p4-c5-webrtc-doorbell/components/esp_webrtc/include/esp_webrtc.h

/**
 * ESPRESSIF MIT License
 *
 * Copyright (c) 2025 <ESPRESSIF SYSTEMS (SHANGHAI) CO., LTD>
 *
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
 */

#pragma once

#include "esp_peer.h"
#include "esp_peer_signaling.h"
#include "esp_capture.h"
#include "av_render.h"

#ifdef __cplusplus
extern "C" {
#endif

/**
 * @brief  ESP WebRTC handle
 */
typedef void *esp_webrtc_handle_t;

typedef enum {
    ESP_WEBRTC_CUSTOM_DATA_VIA_NONE,
    ESP_WEBRTC_CUSTOM_DATA_VIA_SIGNALING,
    ESP_WEBRTC_CUSTOM_DATA_VIA_DATA_CHANNEL,
} esp_webrtc_custom_data_via_t;

/**
 * @brief  ESP WebRTC peer connection configuration
 */
typedef struct {
    esp_peer_ice_server_cfg_t   *server_lists;            /*!< STUN/Relay server URL lists, can be NULL when get from signaling */
    uint8_t                      server_num;              /*!< Number of STUN/Relay server URL */
    esp_peer_ice_trans_policy_t  ice_trans_policy;        /*!< ICE transport policy */
    esp_peer_audio_stream_info_t audio_info;              /*!< Audio stream information for send */
    esp_peer_video_stream_info_t video_info;              /*!< Video stream information for send */
    esp_peer_media_dir_t         audio_dir;               /*!< Audio transmission direction */
    esp_peer_media_dir_t         video_dir;               /*!< Video transmission direction */
    bool                         enable_data_channel;     /*!< Whether enable data channel */
    bool                         manual_ch_create;        /*!< When set, disable auto create data channel in SCTP client mode if `enable_data_channel` set
                                                               User need manually call `esp_peer_create_data_channel` instead */
    bool                         video_over_data_channel; /*!< Whether send and receive video data through data channel */
    bool                         no_auto_reconnect;       /*!< Disable auto reconnect
                                                               In room related WebRTC application, connection build up with peer
                                                               If peer leaves, it will auto re-enter same room (send new SDP) after clear up
                                                               Disable reconnect will do nothing after clear up until call `esp_webrtc_enable_peer_connection` */
    void                        *extra_cfg;               /*!< Extra configuration for peer connection */
    int                          extra_size;              /*!< Size of extra configuration */
    void                        *ctx;                     /*!< User context */

    /**
     * @brief  This API is used for users who do not care the data channel or signaling details
     *         And want to receive data from them only
     */
    int (*on_custom_data)(esp_webrtc_custom_data_via_t via, uint8_t *data, int size, void *ctx);

    /**
     * @brief  Following API are function groups for users who want more control over data channels
     */
    int (*on_channel_open)(esp_peer_data_channel_info_t *ch, void *ctx);   /*!< Callback invoked when a data channel is opened */
    int (*on_data)(esp_peer_data_frame_t *frame, void *ctx);               /*!< Callback invoked when data is received on the channel */
    int (*on_channel_close)(esp_peer_data_channel_info_t *ch, void *ctx);  /*!< Callback invoked when a data channel is closed */

    /**
     * @brief  Callback hook for sending video frames (supports modification or SEI injection).
     *
     * @note   This callback is invoked before a video frame is sent, allowing the user to:
     *         - Send the original video data (leave frame->data unchanged)
     *         - Send modified video data (update frame->data; user is responsible for managing the new buffer's lifecycle)
     *         - Drop the frame (do not send)
     *
     * @param[in]  frame  Video frame information before sending
     * @param[in]  ctx    User-defined context
     *
     * @return
     *         - 0        Proceed with sending (using either original or modified data)
     *         - Others   Drop the frame
     */
    int (*on_video_send)(esp_peer_video_frame_t* frame, void* ctx);
} esp_webrtc_peer_cfg_t;

/**
 * @brief  ESP WebRTC signaling configuration
 */
typedef struct {
    char *signal_url; /*!< Signaling server URL */
    void *extra_cfg;  /*!< Extra configuration for special signaling server */
    int   extra_size; /*!< Size of extra configuration */
    void *ctx;        /*!< User context */
} esp_webrtc_signaling_cfg_t;

/**
 * @brief  ESP WebRTC configuration
 */
typedef struct {
    const esp_peer_signaling_impl_t *signaling_impl; /*!< Signaling implementation */
    esp_webrtc_signaling_cfg_t       signaling_cfg;  /*!< Signaling configuration */
    const esp_peer_ops_t            *peer_impl;      /*!< Peer connection implementation */
    esp_webrtc_peer_cfg_t            peer_cfg;       /*!< Peer connection configuration */
} esp_webrtc_cfg_t;

/**
 * @brief  WebRTC event type
 */
typedef enum {
    ESP_WEBRTC_EVENT_NONE                      = 0, /*!< None event */
    ESP_WEBRTC_EVENT_CONNECTING                = 1, /*!< Connecting event */
    ESP_WEBRTC_EVENT_PAIRED                    = 2, /*!< Paired event */
    ESP_WEBRTC_EVENT_CONNECTED                 = 3, /*!< Connected event */
    ESP_WEBRTC_EVENT_CONNECT_FAILED            = 4, /*!< Connected failed event */
    ESP_WEBRTC_EVENT_DISCONNECTED              = 5, /*!< Disconnected event */
    ESP_WEBRTC_EVENT_DATA_CHANNEL_CONNECTED    = 6, /*!< Data channel connected event */
    ESP_WEBRTC_EVENT_DATA_CHANNEL_DISCONNECTED = 7, /*!< Data channel disconnected event */
    ESP_WEBRTC_EVENT_DATA_CHANNEL_OPENED       = 8, /*!< Data channel opened event, suitable for one data channel only */
    ESP_WEBRTC_EVENT_DATA_CHANNEL_CLOSED       = 9, /*!< Data channel closed event, suitable for one data channel only */
} esp_webrtc_event_type_t;

/**
 * @brief  WebRTC event
 */
typedef struct {
    esp_webrtc_event_type_t type; /*!< Event type */
    char                   *body; /*!< Event body (maybe NULL) */
} esp_webrtc_event_t;

/**
 * @brief  WebRTC media provider
 *
 * @note  Media player and capture system are created from outside.
 *        WebRTC will internally use the capture and player handle to capture media data and do media playback
 */
typedef struct {
    esp_capture_handle_t capture; /*!< Capture system handle */
    av_render_handle_t   player;  /*!< Player handle */
} esp_webrtc_media_provider_t;

/**
 * @brief  WebRTC event handler
 *
 * @param[in]  event  WebRTC event
 * @param[in]  ctx    User context
 *
 * @return  Status to indicate success or failure
 */
typedef int (*esp_webrtc_event_handler_t)(esp_webrtc_event_t *event, void *ctx);

/**
 * @brief  WebRTC event handler
 *
 * @param[in]   event       WebRTC event
 * @param[out]  rtc_handle  WebRTC handle
 *
 * @return
 *      - ESP_PEER_ERR_NONE         On success
 *      - ESP_PEER_ERR_INVALID_ARG  Invalid argument
 *      - ESP_PEER_ERR_NO_MEM       Not enough memory
 */
int esp_webrtc_open(esp_webrtc_cfg_t *cfg, esp_webrtc_handle_t *rtc_handle);

/**
 * @brief  WebRTC set media provider
 *
 * @param[in]  rtc_handle  WebRTC handle
 * @param[in]  provider    Media player and capture provider setting
 *
 * @return
 *      - ESP_PEER_ERR_NONE         On success
 *      - ESP_PEER_ERR_INVALID_ARG  Invalid argument
 */
int esp_webrtc_set_media_provider(esp_webrtc_handle_t rtc_handle, esp_webrtc_media_provider_t *provider);

/**
 * @brief  Set to disable auto capture for WebRTC
 *
 * @note  In default capture will start and stop internally by WebRTC
 *        In some scenario capture is controlled by other module, capture is only one sink path of it
 *        Users can call this API to disable auto control of capture
 *
 * @param[in]  rtc_handle       WebRTC handle
 * @param[in]  no_auto_capture  Disable auto capture or not
 *
 * @return
 *      - ESP_PEER_ERR_NONE         On success
 *      - ESP_PEER_ERR_INVALID_ARG  Invalid argument
 */
int esp_webrtc_set_no_auto_capture(esp_webrtc_handle_t rtc_handle, bool no_auto_capture);

/**
 * @brief  WebRTC set event handler
 *
 * @param[in]  rtc_handle  WebRTC handle
 * @param[in]  handler     Event handler
 * @param[in]  ctx         Event user context
 *
 * @return
 *      - ESP_PEER_ERR_NONE         On success
 *      - ESP_PEER_ERR_INVALID_ARG  Invalid argument
 */
int esp_webrtc_set_event_handler(esp_webrtc_handle_t rtc_handle, esp_webrtc_event_handler_t handler, void *ctx);

/**
 * @brief  Start WebRTC
 *
 * @param[in]  rtc_handle  WebRTC handle
 *
 * @return
 *      - ESP_PEER_ERR_NONE         On success
 *      - ESP_PEER_ERR_INVALID_ARG  Invalid argument
 *      - ESP_PEER_ERR_NO_MEM       Not enough memory
 */
int esp_webrtc_enable_peer_connection(esp_webrtc_handle_t rtc_handle, bool enable);

/**
 * @brief  Set audio capture bitrate (specially for audio encoder)
 *
 * @param[in]  rtc_handle  WebRTC handle
 * @param[in]  bitrate     Audio bitrate to set
 *
 * @return
 *      - ESP_PEER_ERR_NONE         On success
 *      - ESP_PEER_ERR_INVALID_ARG  Invalid argument
 *      - Others                    Fail to set
 */
int esp_webrtc_set_video_bitrate(esp_webrtc_handle_t rtc_handle, uint32_t bitrate);

/**
 * @brief  Set video capture bitrate (specially for video encoder)
 *
 * @param[in]  rtc_handle  WebRTC handle
 * @param[in]  bitrate     Video bitrate to set
 *
 * @return
 *      - ESP_PEER_ERR_NONE         On success
 *      - ESP_PEER_ERR_INVALID_ARG  Invalid argument
 *      - Others                    Fail to set
 */
int esp_webrtc_set_audio_bitrate(esp_webrtc_handle_t rtc_handle, uint32_t bitrate);

/**
 * @brief  Start WebRTC
 *
 * @param[in]  rtc_handle  WebRTC handle
 *
 * @return
 *      - ESP_PEER_ERR_NONE         On success
 *      - ESP_PEER_ERR_INVALID_ARG  Invalid argument
 *      - Others                    Fail to start
 */
int esp_webrtc_start(esp_webrtc_handle_t rtc_handle);

/**
 * @brief  Send customized data
 *
 * @param[in]  rtc_handle  WebRTC handle
 *
 * @return
 *      - ESP_PEER_ERR_NONE         On success
 *      - ESP_PEER_ERR_INVALID_ARG  Invalid argument
 *      - Others                    Fail to send customized data
 */
int esp_webrtc_send_custom_data(esp_webrtc_handle_t rtc_handle, esp_webrtc_custom_data_via_t via, uint8_t *data, int size);

/**
 * @brief  Get Peer Connection handle
 *
 * @param[in]  rtc_handle   WebRTC handle
 * @param[in]  peer_handle  Peer connection handle
 *
 * @return
 *      - ESP_PEER_ERR_NONE         On success
 *      - ESP_PEER_ERR_INVALID_ARG  Invalid argument
 *      - ESP_PEER_ERR_WRONG_STATE  Wrong state for peer connection not build yet
 */
int esp_webrtc_get_peer_connection(esp_webrtc_handle_t rtc_handle, esp_peer_handle_t *peer_handle);

/**
 * @brief  Query status of WebRTC
 *
 * @param[in]  rtc_handle  WebRTC handle
 *
 * @return
 *      - ESP_PEER_ERR_NONE         On success
 *      - ESP_PEER_ERR_INVALID_ARG  Invalid argument
 */
int esp_webrtc_query(esp_webrtc_handle_t rtc_handle);

/**
 * @brief  Stop WebRTC
 *
 * @param[in]  rtc_handle  WebRTC handle
 *
 * @return
 *      - ESP_PEER_ERR_NONE         On success
 *      - ESP_PEER_ERR_INVALID_ARG  Invalid argument
 *      - Others                    Fail to send customized data
 */
int esp_webrtc_stop(esp_webrtc_handle_t rtc_handle);

/**
 * @brief  Close WebRTC
 *
 * @param[in]  rtc_handle  WebRTC handle
 *
 * @return
 *      - ESP_PEER_ERR_NONE         On success
 *      - ESP_PEER_ERR_INVALID_ARG  Invalid argument
 */
int esp_webrtc_close(esp_webrtc_handle_t rtc_handle);

#ifdef __cplusplus
}
#endif
