wudi-tech/esp32-p4-c5-webrtc-doorbell/solutions/doorbell_local/main/media_sys.c

/* Media system

   This example code is in the Public Domain (or CC0 licensed, at your option.)

   Unless required by applicable law or agreed to in writing, this
   software is distributed on an "AS IS" BASIS, WITHOUT WARRANTIES OR
   CONDITIONS OF ANY KIND, either express or implied.
*/

#include "codec_init.h"
#include "codec_board.h"
#if CONFIG_IDF_TARGET_ESP32P4
#include "esp_video_init.h"
#endif
#include "av_render.h"
#include "av_render_default.h"
#include "audio_decoder.h"
#include "audio_resample.h"
#include "common.h"
#include "doorbell_audio_render.h"
#include "esp_log.h"
#include "settings.h"
#include "media_lib_os.h"
#include "esp_timer.h"
#include "esp_audio_enc_default.h"
#include "esp_video_enc_default.h"
#include "esp_video_dec_default.h"
#include "esp_audio_dec_default.h"
#include "esp_capture_defaults.h"
#include "esp_capture_sink.h"
#include <string.h>

#define TAG "MEDIA_SYS"

#define RET_ON_NULL(ptr, v) do {                                \
    if (ptr == NULL) {                                          \
        ESP_LOGE(TAG, "Memory allocate fail on %d", __LINE__);  \
        return v;                                               \
    }                                                           \
} while (0)

typedef struct {
    esp_capture_sink_handle_t   capture_handle;
    esp_capture_video_src_if_t *vid_src;
    esp_capture_audio_src_if_t *aud_src;
} capture_system_t;

typedef struct {
    audio_render_handle_t audio_render;
    video_render_handle_t video_render;
    av_render_handle_t    player;
} player_system_t;

static capture_system_t capture_sys;
static player_system_t  player_sys;
static doorbell_audio_prompt_handle_t prompt_render;

typedef struct {
    uint8_t *data;
    int size;
    int capacity;
    int error;
} prompt_pcm_buffer_t;

typedef struct {
    audio_resample_handle_t resampler;
    prompt_pcm_buffer_t *output;
} prompt_decode_context_t;

static prompt_pcm_buffer_t open_door_prompt;

extern const uint8_t open_music_start[] asm("_binary_open_aac_start");
extern const uint8_t open_music_end[] asm("_binary_open_aac_end");

static bool           music_playing  = false;
static bool           music_stopping = false;
static const uint8_t *music_to_play;
static int            music_size;
static int            music_duration;

static int append_prompt_pcm(prompt_pcm_buffer_t *buffer,
                             const uint8_t *data, int size)
{
    if (buffer == NULL || data == NULL || size <= 0 || buffer->error != 0) {
        return -1;
    }
    int required = buffer->size + size;
    if (required > buffer->capacity) {
        int capacity = buffer->capacity > 0 ? buffer->capacity : 64 * 1024;
        while (capacity < required) {
            capacity *= 2;
        }
        uint8_t *new_data = media_lib_realloc(buffer->data, capacity);
        if (new_data == NULL) {
            buffer->error = -1;
            return -1;
        }
        buffer->data = new_data;
        buffer->capacity = capacity;
    }
    memcpy(buffer->data + buffer->size, data, size);
    buffer->size += size;
    return 0;
}

static int prompt_resampled_frame(av_render_audio_frame_t *frame, void *ctx)
{
    prompt_pcm_buffer_t *buffer = ctx;
    if (frame == NULL || frame->size == 0) {
        return 0;
    }
    return append_prompt_pcm(buffer, frame->data, frame->size);
}

static int prompt_decoded_frame(av_render_audio_frame_t *frame, void *ctx)
{
    prompt_decode_context_t *decode = ctx;
    if (frame == NULL || decode == NULL || decode->resampler == NULL) {
        return -1;
    }
    int ret = audio_resample_write(decode->resampler, frame);
    if (ret != 0) {
        decode->output->error = ret;
    }
    return ret;
}

static int parse_adts_format(const uint8_t *data, int size,
                             av_render_audio_frame_info_t *info)
{
    static const uint32_t sample_rates[] = {
        96000, 88200, 64000, 48000, 44100, 32000, 24000,
        22050, 16000, 12000, 11025, 8000, 7350,
    };
    if (data == NULL || size < 7 || info == NULL || data[0] != 0xff ||
        (data[1] & 0xf6) != 0xf0) {
        return -1;
    }
    unsigned sample_rate_index = (data[2] >> 2) & 0x0f;
    unsigned channel = ((unsigned)(data[2] & 0x01) << 2) |
                       ((unsigned)data[3] >> 6);
    if (sample_rate_index >= sizeof(sample_rates) / sizeof(sample_rates[0]) ||
        channel == 0 || channel > 2) {
        return -1;
    }
    info->sample_rate = sample_rates[sample_rate_index];
    info->channel = (uint8_t)channel;
    info->bits_per_sample = 16;
    return 0;
}

static int prepare_open_door_prompt(void)
{
    int source_size = (int)(open_music_end - open_music_start);
    av_render_audio_frame_info_t source_info = {0};
    if (parse_adts_format(open_music_start, source_size, &source_info) != 0) {
        ESP_LOGE(TAG, "Open-door prompt has an invalid ADTS header");
        return -1;
    }

    audio_resample_cfg_t resample_cfg = {
        .input_info = source_info,
        .output_info = {
            .sample_rate = 16000,
            .channel = 1,
            .bits_per_sample = 16,
        },
        .resample_cb = prompt_resampled_frame,
        .ctx = &open_door_prompt,
    };
    audio_resample_handle_t resampler = audio_resample_open(&resample_cfg);
    if (resampler == NULL) {
        ESP_LOGE(TAG, "Failed to create open-door prompt resampler");
        return -1;
    }

    prompt_decode_context_t decode_ctx = {
        .resampler = resampler,
        .output = &open_door_prompt,
    };
    adec_cfg_t decoder_cfg = {
        .audio_info = {
            .codec = AV_RENDER_AUDIO_CODEC_AAC,
            .sample_rate = source_info.sample_rate,
            .channel = source_info.channel,
            .bits_per_sample = source_info.bits_per_sample,
        },
        .frame_cb = prompt_decoded_frame,
        .ctx = &decode_ctx,
    };
    adec_handle_t decoder = adec_open(&decoder_cfg);
    if (decoder == NULL) {
        audio_resample_close(resampler);
        ESP_LOGE(TAG, "Failed to create open-door prompt decoder");
        return -1;
    }
    int ret = 0;
    int source_position = 0;
    while (source_position + 7 <= source_size) {
        const uint8_t *header = open_music_start + source_position;
        if (header[0] != 0xff || (header[1] & 0xf6) != 0xf0) {
            ret = -1;
            ESP_LOGE(TAG, "Invalid ADTS sync at prompt offset %d",
                     source_position);
            break;
        }
        int frame_size = ((header[3] & 0x03) << 11) |
                         (header[4] << 3) | (header[5] >> 5);
        if (frame_size < 7 || source_position + frame_size > source_size) {
            ret = -1;
            ESP_LOGE(TAG, "Invalid ADTS frame size %d at prompt offset %d",
                     frame_size, source_position);
            break;
        }
        av_render_audio_data_t input = {
            .data = (uint8_t *)header,
            .size = (uint32_t)frame_size,
            .eos = false,
        };
        ret = adec_decode(decoder, &input);
        if (ret != 0) {
            ESP_LOGE(TAG, "AAC prompt frame failed at offset %d: %d",
                     source_position, ret);
            break;
        }
        source_position += frame_size;
    }
    int trailing_bytes = source_size - source_position;
    if (ret == 0 && trailing_bytes == 1 &&
        open_music_start[source_position] == 0) {
        source_position++;
        trailing_bytes = 0;
    }
    if (ret == 0 && trailing_bytes != 0) {
        ESP_LOGE(TAG, "AAC prompt ended with %d unparsed bytes",
                 trailing_bytes);
        ret = -1;
    }
    adec_close(decoder);
    audio_resample_close(resampler);
    if (ret != 0 || open_door_prompt.error != 0 ||
        open_door_prompt.size < (int)sizeof(int16_t)) {
        ESP_LOGE(TAG, "Failed to prepare open-door PCM prompt: decode=%d buffer=%d bytes error=%d",
                 ret, open_door_prompt.size, open_door_prompt.error);
        return -1;
    }
    ESP_LOGI(TAG, "Prepared open-door prompt: %d PCM bytes at 16 kHz mono",
             open_door_prompt.size);
    return 0;
}

static esp_capture_video_src_if_t *create_video_source(void)
{
    camera_cfg_t cam_pin_cfg = {};
    int ret = get_camera_cfg(&cam_pin_cfg);
    if (ret != 0) {
        return NULL;
    }
#if CONFIG_IDF_TARGET_ESP32P4
    esp_video_init_csi_config_t csi_config = { 0 };
#if CONFIG_ESP_VIDEO_ENABLE_DVP_VIDEO_DEVICE
    esp_video_init_dvp_config_t dvp_config = { 0 };
#endif
    esp_video_init_config_t cam_config = { 0 };
    if (cam_pin_cfg.type == CAMERA_TYPE_MIPI) {
        csi_config.sccb_config.i2c_handle = get_i2c_bus_handle(0);
        csi_config.sccb_config.freq = 100000;
        csi_config.reset_pin = cam_pin_cfg.reset;
        csi_config.pwdn_pin = cam_pin_cfg.pwr;
        ESP_LOGI(TAG, "Use i2c handle %p", csi_config.sccb_config.i2c_handle);
        cam_config.csi = &csi_config;
        if (cam_pin_cfg.xclk != -1) {
            esp_cam_sensor_xclk_handle_t xclk_handle = NULL;
            esp_cam_sensor_xclk_config_t xclk_config = {
                .esp_clock_router_cfg = {
                    .xclk_pin = cam_pin_cfg.xclk,
                    .xclk_freq_hz = 24000000,
                }
            };
            ESP_ERROR_CHECK(esp_cam_sensor_xclk_allocate(ESP_CAM_SENSOR_XCLK_ESP_CLOCK_ROUTER, &xclk_handle));
            ESP_ERROR_CHECK(esp_cam_sensor_xclk_start(xclk_handle, &xclk_config));
        }
    }
#if CONFIG_ESP_VIDEO_ENABLE_DVP_VIDEO_DEVICE
    else if (cam_pin_cfg.type == CAMERA_TYPE_DVP) {
        dvp_config.reset_pin = cam_pin_cfg.reset;
        dvp_config.pwdn_pin = cam_pin_cfg.pwr;
        dvp_config.dvp_pin.data_width = CAM_CTLR_DATA_WIDTH_8;
        dvp_config.dvp_pin.data_io[0] = cam_pin_cfg.data[0];
        dvp_config.dvp_pin.data_io[1] = cam_pin_cfg.data[1];
        dvp_config.dvp_pin.data_io[2] = cam_pin_cfg.data[2];
        dvp_config.dvp_pin.data_io[3] = cam_pin_cfg.data[3];
        dvp_config.dvp_pin.data_io[4] = cam_pin_cfg.data[4];
        dvp_config.dvp_pin.data_io[5] = cam_pin_cfg.data[5];
        dvp_config.dvp_pin.data_io[6] = cam_pin_cfg.data[6];
        dvp_config.dvp_pin.data_io[7] = cam_pin_cfg.data[7];
        dvp_config.dvp_pin.vsync_io = cam_pin_cfg.vsync;
        dvp_config.dvp_pin.pclk_io = cam_pin_cfg.pclk;
        dvp_config.dvp_pin.xclk_io = cam_pin_cfg.xclk;
        dvp_config.dvp_pin.de_io = cam_pin_cfg.de;
        dvp_config.xclk_freq = 20000000;
        cam_config.dvp = &dvp_config;
    }
#endif
    ret = esp_video_init(&cam_config);
    if (ret != ESP_OK) {
        ESP_LOGE(TAG, "Camera init failed with error 0x%x", ret);
        return NULL;
    }
    esp_capture_video_v4l2_src_cfg_t v4l2_cfg = {
        .dev_name = "/dev/video0",
        .buf_count = 2,
    };
    return esp_capture_new_video_v4l2_src(&v4l2_cfg);
#endif

#if CONFIG_IDF_TARGET_ESP32S3
    if (cam_pin_cfg.type == CAMERA_TYPE_DVP) {
        esp_capture_video_dvp_src_cfg_t dvp_config = { 0 };
        dvp_config.buf_count = 2;
        dvp_config.reset_pin = cam_pin_cfg.reset;
        dvp_config.pwr_pin = cam_pin_cfg.pwr;
        dvp_config.data[0] = cam_pin_cfg.data[0];
        dvp_config.data[1] = cam_pin_cfg.data[1];
        dvp_config.data[2] = cam_pin_cfg.data[2];
        dvp_config.data[3] = cam_pin_cfg.data[3];
        dvp_config.data[4] = cam_pin_cfg.data[4];
        dvp_config.data[5] = cam_pin_cfg.data[5];
        dvp_config.data[6] = cam_pin_cfg.data[6];
        dvp_config.data[7] = cam_pin_cfg.data[7];
        dvp_config.vsync_pin = cam_pin_cfg.vsync;
        dvp_config.href_pin = cam_pin_cfg.href;
        dvp_config.pclk_pin = cam_pin_cfg.pclk;
        dvp_config.xclk_pin = cam_pin_cfg.xclk;
        dvp_config.xclk_freq = 20000000;
        return esp_capture_new_video_dvp_src(&dvp_config);
    }
#endif
    return NULL;
}

static int build_capture_system(void)
{
    capture_sys.vid_src = create_video_source();
    RET_ON_NULL(capture_sys.vid_src, -1);

    esp_capture_audio_dev_src_cfg_t codec_cfg = {
        .record_handle = get_record_handle(),
    };
    capture_sys.aud_src = esp_capture_new_audio_dev_src(&codec_cfg);
    RET_ON_NULL(capture_sys.aud_src, -1);
    // Create capture system
    esp_capture_cfg_t cfg = {
        .sync_mode = ESP_CAPTURE_SYNC_MODE_AUDIO,
        .audio_src = capture_sys.aud_src,
        .video_src = capture_sys.vid_src,
    };
    esp_capture_open(&cfg, &capture_sys.capture_handle);
    return 0;
}

static int build_player_system()
{
    i2s_render_cfg_t i2s_cfg = {
        .fixed_clock = true,
        .play_handle = get_playback_handle(),
    };
    player_sys.audio_render = av_render_alloc_prompt_overlay(
        &i2s_cfg, &prompt_render);
    if (player_sys.audio_render == NULL) {
        ESP_LOGE(TAG, "Fail to create audio render");
        return -1;
    }
    lcd_render_cfg_t lcd_cfg = {
        .lcd_handle = board_get_lcd_handle(),
    };
    player_sys.video_render = av_render_alloc_lcd_render(&lcd_cfg);

    if (player_sys.video_render == NULL) {
        ESP_LOGE(TAG, "Fail to create video render");
        // Allow not display
    }
    av_render_cfg_t render_cfg = {
        .audio_render = player_sys.audio_render,
        .video_render = player_sys.video_render,
        .audio_raw_fifo_size = 4096,
        .audio_render_fifo_size = 6 * 1024,
        .video_raw_fifo_size = 500 * 1024,
        .allow_drop_data = false,
        //.video_render_fifo_size = 4*1024,
    };
    player_sys.player = av_render_open(&render_cfg);
    if (player_sys.player == NULL) {
        ESP_LOGE(TAG, "Fail to create player");
        return -1;
    }
    return 0;
}

int media_sys_buildup(void)
{
    // Register for default audio and video codecs
    esp_video_enc_register_default();
    esp_audio_enc_register_default();
    esp_video_dec_register_default();
    esp_audio_dec_register_default();
    if (prepare_open_door_prompt() != 0) {
        ESP_LOGW(TAG, "In-call open-door prompt will be unavailable");
    }
    // Build capture system
    build_capture_system();
    // Build player system
    build_player_system();
    return 0;
}

int media_sys_get_provider(esp_webrtc_media_provider_t *provide)
{
    provide->capture = capture_sys.capture_handle;
    provide->player = player_sys.player;
    return 0;
}

int test_capture_to_player(void)
{
    esp_capture_sink_cfg_t sink_cfg = {
        .audio_info = {
            .format_id = ESP_CAPTURE_FMT_ID_G711A,
            .sample_rate = 8000,
            .channel = 1,
            .bits_per_sample = 16,
        },
        .video_info = { .format_id = ESP_CAPTURE_FMT_ID_MJPEG, .width = VIDEO_WIDTH, .height = VIDEO_HEIGHT, .fps = 20 },
    };
    // Create capture
    esp_capture_sink_handle_t capture_path = NULL;
    esp_capture_sink_setup(capture_sys.capture_handle, 0, &sink_cfg, &capture_path);
    esp_capture_sink_enable(capture_path, ESP_CAPTURE_RUN_MODE_ALWAYS);
    // Create player
    av_render_audio_info_t render_aud_info = {
        .codec = AV_RENDER_AUDIO_CODEC_G711A,
        .sample_rate = 8000,
        .channel = 1,
    };
    av_render_add_audio_stream(player_sys.player, &render_aud_info);

    av_render_video_info_t render_vid_info = {
        .codec = AV_RENDER_VIDEO_CODEC_MJPEG,
    };
    av_render_add_video_stream(player_sys.player, &render_vid_info);
    uint32_t start_time = (uint32_t)(esp_timer_get_time() / 1000);
    esp_capture_start(capture_sys.capture_handle);
    while ((uint32_t)(esp_timer_get_time() / 1000) < start_time + 2000) {
        media_lib_thread_sleep(30);
        esp_capture_stream_frame_t frame = {
            .stream_type = ESP_CAPTURE_STREAM_TYPE_AUDIO,
        };
        while (esp_capture_sink_acquire_frame(capture_path, &frame, true) == ESP_CAPTURE_ERR_OK) {
            av_render_audio_data_t audio_data = {
                .data = frame.data,
                .size = frame.size,
                .pts = frame.pts,
            };
            av_render_add_audio_data(player_sys.player, &audio_data);
            esp_capture_sink_release_frame(capture_path, &frame);
        }
        frame.stream_type = ESP_CAPTURE_STREAM_TYPE_VIDEO;
        while (esp_capture_sink_acquire_frame(capture_path, &frame, true) == ESP_CAPTURE_ERR_OK) {
            av_render_video_data_t video_data = {
                .data = frame.data,
                .size = frame.size,
                .pts = frame.pts,
            };
            av_render_add_video_data(player_sys.player, &video_data);
            esp_capture_sink_release_frame(capture_path, &frame);
        }
    }
    esp_capture_stop(capture_sys.capture_handle);
    av_render_reset(player_sys.player);
    return 0;
}

static void music_play_thread(void *arg)
{
    // Suppose all music is AAC
    av_render_audio_info_t render_aud_info = {
        .codec = AV_RENDER_AUDIO_CODEC_AAC,
    };
    av_render_add_audio_stream(player_sys.player, &render_aud_info);
    int music_pos = 0;
    while (!music_stopping && music_duration >= 0) {
        uint32_t start_time = esp_timer_get_time() / 1000;
        int send_size = music_size - music_pos;
        const uint8_t *adts_header = music_to_play + music_pos;
        if (adts_header[0] != 0xFF) {
            send_size = 0;
        } else {
            int frame_size = ((adts_header[3] & 0x03) << 11) | (adts_header[4] << 3) | (adts_header[5] >> 5);
            if (frame_size < send_size) {
                send_size = frame_size;
            }
        }
        if (send_size) {
            av_render_audio_data_t audio_data = {
                .data = (uint8_t *)adts_header,
                .size = send_size,
            };
            int ret = av_render_add_audio_data(player_sys.player, &audio_data);
            if (ret != 0) {
                break;
            }
            music_pos += send_size;
        }
        if (music_pos >= music_size || send_size == 0) {
            music_pos = 0;
            // Play one loop only
            if (music_duration == 0) {
                av_render_fifo_stat_t stat = { 0 };
                while (!music_stopping) {
                    av_render_get_audio_fifo_level(player_sys.player, &stat);
                    if (stat.data_size > 0) {
                        media_lib_thread_sleep(50);
                        continue;
                    }
                    break;
                }
                break;
            }
        }
        uint32_t end_time = esp_timer_get_time() / 1000;
        if (music_duration) {
            music_duration -= end_time - start_time;
        }
        // av_render_audio_data is non-blocking. Yield between AAC frames so
        // the single-core music task cannot starve the P4 idle task/watchdog.
        media_lib_thread_sleep(1);
    }
    av_render_reset(player_sys.player);
    music_stopping = false;
    music_playing = false;
    media_lib_thread_destroy(NULL);
}

int play_music(const uint8_t *data, int size, int duration)
{
    if (music_playing) {
        ESP_LOGE(TAG, "Music is playing, stop automatically");
        stop_music();
    }
    music_playing = true;
    music_to_play = data;
    music_size = size;
    music_duration = duration;
    media_lib_thread_handle_t thread;
    int ret = media_lib_thread_create_from_scheduler(&thread, "music_player", music_play_thread, NULL);
    if (ret != 0) {
        music_playing = false;
        ESP_LOGE(TAG, "Fail to create music_player thread");
        return ret;
    }
    return 0;
}

int stop_music()
{
    if (music_playing) {
        music_stopping = true;
        while (music_stopping) {
            media_lib_thread_sleep(20);
        }
    }
    return 0;
}

int play_open_door_prompt_in_call(void)
{
    if (prompt_render == NULL || open_door_prompt.data == NULL ||
        open_door_prompt.size < (int)sizeof(int16_t)) {
        ESP_LOGE(TAG, "Open-door PCM prompt is not ready");
        return -1;
    }
    int ret = doorbell_audio_prompt_start(
        prompt_render, (const int16_t *)open_door_prompt.data,
        open_door_prompt.size / (int)sizeof(int16_t));
    if (ret != 0) {
        ESP_LOGE(TAG, "Open-door PCM prompt cannot start in current audio format");
    }
    return ret;
}
