wudi-tech/esp32-p4-c5-webrtc-doorbell/solutions/doorbell_local/main/webrtc_http_server.c

/* WebRTC HTTPS server signaling

   This example code is in the Public Domain (or CC0 licensed, at your option.)

   Unless required by applicable law or agreed to in writing, this
   software is distributed on an "AS IS" BASIS, WITHOUT WARRANTIES OR
   CONDITIONS OF ANY KIND, either express or implied.
*/

#include <string.h>
#include "freertos/FreeRTOS.h"
#include "freertos/task.h"
#include "freertos/queue.h"
#include "esp_http_server.h"
#include "esp_https_server.h"
#include "esp_log.h"
#include "esp_timer.h"
#include "cJSON.h"
#include "esp_peer_signaling.h"
#include "webrtc_http_server.h"
#include "media_lib_socket.h"

#define MAX_CONTENT_LEN          (16 * 1024)
#define MAX_SIGNALING_QUEUE_SIZE 10
#define MAX_TELEMETRY_QUEUE_SIZE 16
#define MAX_TELEMETRY_EVENT_SIZE 256
#define MAX_VISION_EVENT_SIZE    1024

static const char *TAG = "WEBRTC_HTTP";

static httpd_handle_t server = NULL;
static QueueHandle_t signaling_queue = NULL;
static QueueHandle_t telemetry_queue = NULL;
static QueueHandle_t vision_queue = NULL;
static esp_peer_signaling_cfg_t sig_cfg = { 0 };

typedef struct {
    char json[MAX_TELEMETRY_EVENT_SIZE];
} telemetry_event_t;

typedef struct {
    uint32_t sequence;
    char json[MAX_VISION_EVENT_SIZE];
} vision_event_t;

typedef struct {
    httpd_req_t *req;
    bool stopping;
    uint32_t last_vision_sequence;
} sse_session_t;

static sse_session_t *event_stream = NULL;

bool webrtc_http_server_publish_event(const char *json)
{
    if (json == NULL || telemetry_queue == NULL) {
        return false;
    }
    size_t length = strlen(json);
    if (length == 0U || length >= MAX_TELEMETRY_EVENT_SIZE) {
        return false;
    }
    telemetry_event_t event = {0};
    memcpy(event.json, json, length + 1U);
    if (xQueueSend(telemetry_queue, &event, 0) == pdTRUE) {
        return true;
    }

    telemetry_event_t discarded;
    (void)xQueueReceive(telemetry_queue, &discarded, 0);
    return xQueueSend(telemetry_queue, &event, 0) == pdTRUE;
}

bool webrtc_http_server_publish_latest_vision(const char *json)
{
    static uint32_t sequence;
    if (json == NULL || vision_queue == NULL) {
        return false;
    }
    size_t length = strlen(json);
    if (length == 0U || length >= MAX_VISION_EVENT_SIZE) {
        return false;
    }
    vision_event_t event = {0};
    ++sequence;
    if (sequence == 0U) {
        ++sequence;
    }
    event.sequence = sequence;
    memcpy(event.json, json, length + 1U);
    return xQueueOverwrite(vision_queue, &event) == pdTRUE;
}

static int send_event_stream_msg(httpd_req_t *req, char *data)
{
    int len = strlen(data) + strlen("data: ") + strlen("\n\n") + 1;
    char *buf = malloc(len);
    if (buf == NULL) {
        return -1;
    }
    len = snprintf(buf, len, "data: %s\n\n", data);
    int ret = httpd_resp_send_chunk(req, buf, len);
    free(buf);
    return ret;
}

static void signaling_msg_send_task(void *arg)
{
    sse_session_t *session = (sse_session_t *)arg;
    uint32_t hear_beat = esp_timer_get_time() / 1000;
    while (!session->stopping && event_stream == session) {
        char *msg = NULL;
        telemetry_event_t telemetry;
        vision_event_t vision;
        int ret = 0;
        if (xQueueReceive(signaling_queue, &msg, 0) == pdTRUE) {
            if (msg) {
                if (session->stopping || event_stream != session) {
                    free(msg);
                    break;
                }
                printf("Received %s\n", msg);
                ret = send_event_stream_msg(session->req, msg);
                free(msg);
                if (ret != 0) {
                    break;
                }
            }
        } else if (telemetry_queue != NULL &&
                   xQueueReceive(telemetry_queue, &telemetry, 0) == pdTRUE) {
            if (session->stopping || event_stream != session) {
                break;
            }
            ret = send_event_stream_msg(session->req, telemetry.json);
            if (ret != 0) {
                break;
            }
        } else if (vision_queue != NULL &&
                   xQueuePeek(vision_queue, &vision,
                              pdMS_TO_TICKS(100)) == pdTRUE) {
            if (vision.sequence == session->last_vision_sequence) {
                // xQueuePeek returns immediately while the one-slot snapshot
                // remains populated. Yield until the producer overwrites it.
                vTaskDelay(pdMS_TO_TICKS(100));
            } else {
                if (session->stopping || event_stream != session) {
                    break;
                }
                ret = send_event_stream_msg(session->req, vision.json);
                if (ret != 0) {
                    break;
                }
                session->last_vision_sequence = vision.sequence;
            }
        } else {
            vTaskDelay(pdMS_TO_TICKS(100));
        }
        // Send heart beat to check peer disappered or not
        if (esp_timer_get_time() / 1000 - hear_beat > 5000) {
            hear_beat = esp_timer_get_time() / 1000;
            ret = send_event_stream_msg(session->req, "{\"type\":\"heartbeat\"}");
            if (ret != 0) {
                ESP_LOGE(TAG, "Failed to send heartbeat ret %d", ret);
                break;
            }
        }
    }
    httpd_req_async_handler_complete(session->req);
    if (event_stream == session) {
        event_stream = NULL;
    }
    free(session);
    ESP_LOGI(TAG, "Event Stream hdlr Quit");
    vTaskDelete(NULL);
}

// Handler for GET /webrtc/signal
static esp_err_t webrtc_signal_get_handler(httpd_req_t *req)
{
    // Set headers for Server-Sent Events
    httpd_resp_set_type(req, "text/event-stream");
    httpd_resp_set_hdr(req, "Cache-Control", "no-cache");
    httpd_resp_set_hdr(req, "Connection", "keep-alive");
    httpd_resp_set_hdr(req, "Access-Control-Allow-Origin", "*");
    if (event_stream) {
        // A page refresh creates a new EventSource before the old TCP stream
        // has necessarily reached its next heartbeat. Let the new page take
        // over immediately instead of dropping its doorbell events.
        event_stream->stopping = true;
    }
    sse_session_t *session = calloc(1, sizeof(sse_session_t));
    if (session == NULL) {
        return ESP_ERR_NO_MEM;
    }
    send_event_stream_msg(req, "{\"type\":\"connected\"}");
    httpd_req_async_handler_begin(req, &session->req);
    if (session->req == NULL) {
        free(session);
        return ESP_FAIL;
    }
    event_stream = session;
    // Keep the connection open for SSE and process messages from queue.
    if (xTaskCreate(signaling_msg_send_task, "signal_hdlr", 4096, session, 5, NULL) != pdPASS) {
        event_stream = NULL;
        httpd_req_async_handler_complete(session->req);
        free(session);
        return ESP_FAIL;
    }

    return ESP_OK;
}

// Handler for POST /webrtc/signal
static esp_err_t webrtc_signal_post_handler(httpd_req_t *req)
{
    printf("Get post request\n");
    httpd_resp_set_hdr(req, "Access-Control-Allow-Origin", "*");
    httpd_resp_set_hdr(req, "Access-Control-Allow-Methods", "POST, OPTIONS");
    httpd_resp_set_hdr(req, "Access-Control-Allow-Headers", "Content-Type");
    printf("Request length %d\n", req->content_len);

    // Handle OPTIONS request
    if (req->method == HTTP_OPTIONS) {
        httpd_resp_send(req, NULL, 0);
        return ESP_OK;
    }
    if (req->content_len > MAX_CONTENT_LEN) {
        httpd_resp_send_err(req, HTTPD_400_BAD_REQUEST, "Content too long");
        return ESP_OK;
    }
    char *buf = malloc(req->content_len + 1);
    if (buf == NULL) {
        httpd_resp_send_err(req, HTTPD_400_BAD_REQUEST, "No memory");
        return ESP_OK;
    }

    int ret = ESP_OK;
    cJSON *root = NULL;

    int readed = 0;
    while (readed < req->content_len) {
        ret = httpd_req_recv(req, buf + readed, req->content_len - readed);
        if (ret <= 0) {
            if (ret == HTTPD_SOCK_ERR_TIMEOUT) {
                continue;
            }
            ret = ESP_FAIL;
            goto _exit;
        }
        readed += ret;
    }
    buf[readed] = '\0';

    printf("Get post %s\n", buf);
    ret = ESP_OK;
    // Parse JSON message
    root = cJSON_Parse(buf);
    if (!root) {
        httpd_resp_send_err(req, HTTPD_400_BAD_REQUEST, "Invalid JSON");
        ret = ESP_FAIL;
        goto _exit;
    }

    cJSON *type = cJSON_GetObjectItem(root, "type");
    if (!type || !type->valuestring) {
        httpd_resp_send_err(req, HTTPD_400_BAD_REQUEST, "Missing type");
        ret = ESP_FAIL;
        goto _exit;
    }

    esp_peer_signaling_msg_t msg = { 0 };

    if (strcmp(type->valuestring, "offer") == 0) {
        cJSON *sdp = cJSON_GetObjectItem(root, "sdp");
        if (!sdp || !sdp->valuestring) {
            httpd_resp_send_err(req, HTTPD_400_BAD_REQUEST, "Missing SDP");
            ret = ESP_FAIL;
            goto _exit;
        }
        msg.type = ESP_PEER_SIGNALING_MSG_SDP;
        msg.data = (uint8_t *)sdp->valuestring;
        msg.size = strlen(sdp->valuestring);
    } else if (strcmp(type->valuestring, "answer") == 0) {
        cJSON *sdp = cJSON_GetObjectItem(root, "sdp");
        if (!sdp || !sdp->valuestring) {
            httpd_resp_send_err(req, HTTPD_400_BAD_REQUEST, "Missing SDP");
            ret = ESP_FAIL;
            goto _exit;
        }
        msg.type = ESP_PEER_SIGNALING_MSG_SDP;
        msg.data = (uint8_t *)sdp->valuestring;
        msg.size = strlen(sdp->valuestring);

        // Extract ICE candidates from SDP and send them separately
        char *sdp_str = strdup(sdp->valuestring);
        if (sdp_str) {
            char *line = strtok(sdp_str, "\r\n");
            while (line != NULL) {
                if (strncmp(line, "a=candidate:", 11) == 0) {
                    esp_peer_signaling_msg_t candidate_msg = { 0 };
                    candidate_msg.type = ESP_PEER_SIGNALING_MSG_CANDIDATE;
                    candidate_msg.data = (uint8_t *)line;
                    candidate_msg.size = strlen(line);

                    // Send candidate to peer
                    sig_cfg.on_msg(&candidate_msg, sig_cfg.ctx);
                }
                line = strtok(NULL, "\r\n");
            }
            free(sdp_str);
        }
    } else if (strcmp(type->valuestring, "candidate") == 0) {
        cJSON *candidate = cJSON_GetObjectItem(root, "candidate");
        if (!candidate || !candidate->valuestring) {
            httpd_resp_send_err(req, HTTPD_400_BAD_REQUEST, "Missing candidate string");
            ret = ESP_FAIL;
            goto _exit;
        }
        msg.type = ESP_PEER_SIGNALING_MSG_CANDIDATE;
        msg.data = (uint8_t *)candidate->valuestring;
        msg.size = strlen(candidate->valuestring);
    } else if (strcmp(type->valuestring, "bye") == 0) {
        msg.type = ESP_PEER_SIGNALING_MSG_BYE;
    } else if (strcmp(type->valuestring, "customized") == 0) {
        cJSON *data = cJSON_GetObjectItem(root, "data");
        if (!data || !data->valuestring) {
            httpd_resp_send_err(req, HTTPD_400_BAD_REQUEST, "Missing data for customized message");
            ret = ESP_FAIL;
            goto _exit;
        }
        msg.type = ESP_PEER_SIGNALING_MSG_CUSTOMIZED;
        msg.data = (uint8_t *)data->valuestring;
        msg.size = strlen(data->valuestring);
    } else {
        httpd_resp_send_err(req, HTTPD_400_BAD_REQUEST, "Unknown message type");
        ret = ESP_FAIL;
        goto _exit;
    }
    if (msg.type) {
        // Notify for received message
        sig_cfg.on_msg(&msg, sig_cfg.ctx);
    }
    httpd_resp_sendstr(req, "OK");
_exit:
    free(buf);
    cJSON_Delete(root);
    return ret;
}

// Handler for GET /webrtc/test
static esp_err_t webrtc_test_get_handler(httpd_req_t *req)
{
    extern const unsigned char webrtc_test_html_start[] asm("_binary_webrtc_test_html_start");
    extern const unsigned char webrtc_test_html_end[] asm("_binary_webrtc_test_html_end");
    const size_t webrtc_test_html_size = (webrtc_test_html_end - webrtc_test_html_start);

    httpd_resp_set_type(req, "text/html; charset=utf-8");
    httpd_resp_send(req, (const char *)webrtc_test_html_start, webrtc_test_html_size);
    return ESP_OK;
}

// Handler for GET /webrtc/ring.aac
static esp_err_t webrtc_ring_get_handler(httpd_req_t *req)
{
    extern const unsigned char ring_aac_start[] asm("_binary_ring_aac_start");
    extern const unsigned char ring_aac_end[] asm("_binary_ring_aac_end");
    const size_t ring_aac_size = (ring_aac_end - ring_aac_start);

    httpd_resp_set_type(req, "audio/aac");
    httpd_resp_set_hdr(req, "Cache-Control", "public, max-age=31536000");
    httpd_resp_send(req, (const char *)ring_aac_start, ring_aac_size);
    return ESP_OK;
}

// Initialize HTTP server
static esp_err_t init_http_server(void)
{
    httpd_ssl_config_t conf = HTTPD_SSL_CONFIG_DEFAULT();
    conf.httpd.max_uri_handlers = 16;
    conf.httpd.stack_size = 8192;
    // Default HTTPS max_open_sockets is 4; raise it so page + SSE + audio + probes can coexist
    conf.httpd.max_open_sockets = 7;
    conf.httpd.lru_purge_enable = true;
    conf.httpd.recv_wait_timeout = 5;
    conf.httpd.send_wait_timeout = 5;
    conf.httpd.max_resp_headers = 8;

    // Browser speculative TLS probes abort often; silence those expected errors
    esp_log_level_set("esp-tls-mbedtls", ESP_LOG_NONE);
    esp_log_level_set("esp_https_server", ESP_LOG_NONE);
    esp_log_level_set("httpd", ESP_LOG_NONE);

    extern const unsigned char servercert_start[] asm("_binary_servercert_pem_start");
    extern const unsigned char servercert_end[] asm("_binary_servercert_pem_end");
    conf.servercert = servercert_start;
    conf.servercert_len = servercert_end - servercert_start;

    extern const unsigned char prvtkey_pem_start[] asm("_binary_prvtkey_pem_start");
    extern const unsigned char prvtkey_pem_end[] asm("_binary_prvtkey_pem_end");
    conf.prvtkey_pem = prvtkey_pem_start;
    conf.prvtkey_len = prvtkey_pem_end - prvtkey_pem_start;

    esp_err_t ret = httpd_ssl_start(&server, &conf);
    if (ESP_OK != ret) {
        ESP_LOGI(TAG, "Error starting server!");
        return -1;
    }

    // Register URI handlers
    httpd_uri_t webrtc_signal_get = {
        .uri = "/webrtc/signal",
        .method = HTTP_GET,
        .handler = webrtc_signal_get_handler,
        .user_ctx = NULL
    };
    httpd_register_uri_handler(server, &webrtc_signal_get);

    httpd_uri_t webrtc_signal_post = {
        .uri = "/webrtc/signal/post",
        .method = HTTP_POST,
        .handler = webrtc_signal_post_handler,
        .user_ctx = NULL
    };
    httpd_register_uri_handler(server, &webrtc_signal_post);

    httpd_uri_t webrtc_test = {
        .uri = "/webrtc/test",
        .method = HTTP_GET,
        .handler = webrtc_test_get_handler,
        .user_ctx = NULL
    };
    httpd_register_uri_handler(server, &webrtc_test);

    httpd_uri_t webrtc_ring = {
        .uri = "/webrtc/ring.aac",
        .method = HTTP_GET,
        .handler = webrtc_ring_get_handler,
        .user_ctx = NULL
    };
    httpd_register_uri_handler(server, &webrtc_ring);

    return ESP_OK;
}

static esp_err_t webrtc_http_server_init(esp_peer_signaling_cfg_t *cfg, esp_peer_signaling_handle_t *h)
{
    if (telemetry_queue == NULL) {
        telemetry_queue = xQueueCreate(MAX_TELEMETRY_QUEUE_SIZE,
                                       sizeof(telemetry_event_t));
        if (telemetry_queue == NULL) {
            ESP_LOGE(TAG, "Failed to create telemetry queue");
            return ESP_FAIL;
        }
    }
    if (vision_queue == NULL) {
        vision_queue = xQueueCreate(1, sizeof(vision_event_t));
        if (vision_queue == NULL) {
            ESP_LOGE(TAG, "Failed to create latest-vision queue");
            return ESP_FAIL;
        }
    }
    // Create signaling queue
    signaling_queue = xQueueCreate(MAX_SIGNALING_QUEUE_SIZE, sizeof(char *));
    if (!signaling_queue) {
        ESP_LOGE(TAG, "Failed to create signaling queue");
        return ESP_FAIL;
    }

    // Initialize HTTP server
    esp_err_t ret = init_http_server();
    if (ret != ESP_OK) {
        vQueueDelete(signaling_queue);
        signaling_queue = NULL;
        return ret;
    }
    sig_cfg = *cfg;
    esp_peer_signaling_ice_info_t ice_info = {
        .is_initiator = true,
        .server_info.stun_url = "stun:stun.l.google.com:19302",
    };
    // Notify for rule
    sig_cfg.on_ice_info(&ice_info, cfg->ctx);
    sig_cfg.on_connected(cfg->ctx);
    *h = (esp_peer_signaling_handle_t)signaling_queue;
    ESP_LOGI(TAG, "Success to init http server");
    return ESP_OK;
}

static int webrtc_http_server_send_msg(esp_peer_signaling_handle_t sig, esp_peer_signaling_msg_t *msg);

static int resend_all_candidate(esp_peer_signaling_handle_t sig, char *str)
{
    char *sdp_str = strdup(str);
    if (sdp_str) {
        char *line = strtok(sdp_str, "\r\n");
        while (line != NULL) {
            if (strncmp(line, "a=candidate:", 11) == 0) {
                // Create candidate message
                char *cand = line + 2;
                esp_peer_signaling_msg_t candidate_msg = { 0 };
                candidate_msg.type = ESP_PEER_SIGNALING_MSG_CANDIDATE;
                candidate_msg.data = (uint8_t *)cand;
                candidate_msg.size = strlen(cand);
                // Send candidate to peer
                webrtc_http_server_send_msg(sig, &candidate_msg);
            }
            line = strtok(NULL, "\r\n");
        }
        free(sdp_str);
    }
    return 0;
}

static int webrtc_http_server_send_msg(esp_peer_signaling_handle_t sig, esp_peer_signaling_msg_t *msg)
{
    if (signaling_queue == NULL || sig != signaling_queue || msg == NULL) {
        return -1;
    }
    cJSON *msg_root = cJSON_CreateObject();
    if (msg_root == NULL) {
        return -1;
    }
    switch (msg->type) {
        case ESP_PEER_SIGNALING_MSG_SDP:
            cJSON_AddStringToObject(msg_root, "type", "offer");
            cJSON_AddStringToObject(msg_root, "sdp", (char *)msg->data);
            break;
        case ESP_PEER_SIGNALING_MSG_CANDIDATE:
            cJSON_AddStringToObject(msg_root, "type", "candidate");
            cJSON_AddStringToObject(msg_root, "candidate", (char *)msg->data);
            break;
        case ESP_PEER_SIGNALING_MSG_BYE:
            cJSON_AddStringToObject(msg_root, "type", "bye");
            break;
        case ESP_PEER_SIGNALING_MSG_CUSTOMIZED:
            cJSON_AddStringToObject(msg_root, "type", "customized");
            cJSON_AddStringToObject(msg_root, "data", (char *)msg->data);
            break;
        default:
            cJSON_Delete(msg_root);
            // Not supported message
            return 0;
    }

    char *json_str = cJSON_PrintUnformatted(msg_root);
    cJSON_Delete(msg_root);
    if (json_str) {
        // When send into queue it will be released when received
        if (xQueueSend(signaling_queue, &json_str, pdMS_TO_TICKS(100)) != pdTRUE) {
            ESP_LOGW(TAG, "Failed to send message to signaling queue");
            free(json_str);
        }
    }
    if (msg->type == ESP_PEER_SIGNALING_MSG_SDP) {
        resend_all_candidate(sig, (char *)msg->data);
    }
    return 0;
}

// Cleanup function
static int webrtc_http_server_deinit(esp_peer_signaling_handle_t sig)
{
    if (signaling_queue == NULL || sig != signaling_queue) {
        return -1;
    }
    ESP_LOGI(TAG, "Start to stop https server");
    if (signaling_queue) {
        // Clear and delete the queue
        char *msg = NULL;
        while (xQueueReceive(signaling_queue, &msg, 0) == pdTRUE) {
            if (msg) {
                free(msg);
            }
        }
    }
    if (event_stream) {
        event_stream->stopping = true;
        ESP_LOGI(TAG, "Wait event stream stopped");
        // Wait for event stream to disconnected
        while (event_stream) {
            vTaskDelay(pdMS_TO_TICKS(100));
        }
    }
    if (server) {
        httpd_ssl_stop(server);
        server = NULL;
    }
    if (signaling_queue) {
        vQueueDelete(signaling_queue);
        signaling_queue = NULL;
    }
    ESP_LOGI(TAG, "End to stop https server");
    return 0;
}

const esp_peer_signaling_impl_t *esp_signaling_get_http_impl(void)
{
    static const esp_peer_signaling_impl_t impl = {
        .start = webrtc_http_server_init,
        .send_msg = webrtc_http_server_send_msg,
        .stop = webrtc_http_server_deinit,
    };
    return &impl;
}
