wudi-tech/esp32-p4-c5-webrtc-doorbell/components/codec_board/include/codec_init.h

/**
 * ESPRESSIF MIT License
 *
 * Copyright (c) 2025 <ESPRESSIF SYSTEMS (SHANGHAI) CO., LTD>
 *
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
 */

#pragma once

#include "esp_codec_dev.h"

#ifdef __cplusplus
extern "C" {
#endif

/**
 * @brief  I2S mode
 */
typedef enum {
    CODEC_I2S_MODE_STD = 0, /*!< STD mode */
    CODEC_I2S_MODE_TDM,     /*!< TDM mode */
    CODEC_I2S_MODE_PDM,     /*!< PDM mode */
    CODEC_I2S_MODE_NONE,    /*!< NONE means not support */
} codec_i2s_mode_t;

/**
 * @brief  Codec initialize configuration
 */
typedef struct {
    codec_i2s_mode_t in_mode;         /*!< I2S input mode */
    codec_i2s_mode_t out_mode;        /*!< I2S output mode */
    bool             in_use_tdm;      /*!< Whether codec use TDM mode for input (codec use TDM, I2S can use STD mode) */
    bool             reuse_dev;       /*!< Use same handle for both input and output */
} codec_init_cfg_t;

/**
 * @brief  Initialize I2C driver
 *
 * @note  When user want to get I2C bus handle either use `get_i2c_bus_handle`
 *        Or use IDF API `i2c_master_get_bus_handle` on IDFv5.4 or high
 *
 * @param[in]  port  I2C port
 *
 * @return
 *       - 0       On success
 *       - Others  Fail to initialize
 */
int init_i2c(uint8_t port);

/**
 * @brief  Deinitialize I2C driver
 *
 * @note  Attention make sure no driver use I2C bus anymore before do this action
 *
 * @param[in]  port  I2C port
 *
 * @return
 *       - 0       On success
 *       - Others  Fail to initialize
 */
int deinit_i2c(uint8_t port);

/**
 * @brief  Initialize codec
 *
 * @param[in]  cfg  Codec initialize configuration
 *
 * @return
 *       - 0       On success
 *       - Others  Fail to initialize
 */
int init_codec(codec_init_cfg_t *cfg);

/**
 * @brief  Get `esp_codec_dev` handle for playback
 *
 * @return
 *       - NULL    Fail to get playback handle
 *       - Others  Playback `esp_codec_dev` handle
 */
esp_codec_dev_handle_t get_playback_handle(void);

/**
 * @brief  Get low-level playback i2s channel handle
 *
 * @return
 *       - NULL    Fail to get playback i2s channel handle
 *       - Others  Playback  i2s channel  handle
 */
void *get_playback_i2s_channel(void);

/**
 * @brief  Get `esp_codec_dev` handle for record
 *
 * @return
 *       - NULL    Fail to get record handle
 *       - Others  Record `esp_codec_dev` handle
 */
esp_codec_dev_handle_t get_record_handle(void);

/**
 * @brief  Get low-level record i2s channel handle
 *
 * @return
 *       - NULL    Fail to get record i2s channel handle
 *       - Others  Record i2s channel  handle
 */
void *get_record_i2s_channel(void);

/**
 * @brief  Get I2C master bus handle by port
 *
 * @param[in]  port  I2C bus port
 *
 * @return
 *       - NULL    Fail to get I2C bus handle
 *       - Others  I2C bus handle
 */
void *get_i2c_bus_handle(uint8_t port);

/**
 * @brief  Mount SDCard
 *
 * @return
 *       - 0       On success
 *       - Others  Fail to mount
 */
int mount_sdcard(void);

/**
 * @brief  Get mounted SDCard handle
 *
 * @return
 *       - 0       On success
 *       - Others  Fail to mount
 */
void *get_sdcard_handle(void);

/**
 * @brief  Unmount SDCard
 */
void unmount_sdcard(void);

/**
 * @brief  Deinitialize codec
 */
void deinit_codec(void);

/**
 * @brief  Initialized for LCD
 *
 * @return
 *       - 0       On success
 *       - Others  Fail to init LCD
 */
int board_lcd_init(void);

/**
 * @brief  Get LCD handle
 *
 * @return
 *       - NULL    Fail to get LCD handle
 *       - Others  LCD handle
 */
void *board_get_lcd_handle(void);

/**
 * @brief  Get LCD IO handle
 *
 * @return
 *       - NULL    Fail to get LCD IO handle
 *       - Others  LCD IO handle
 */
void *board_get_lcd_io_handle(void);

#ifdef __cplusplus
}
#endif
