wudi-tech/esp32-p4-c5-webrtc-doorbell/components/esp_peer/include/esp_peer_default.h

/*
 * SPDX-FileCopyrightText: 2025 Espressif Systems (Shanghai) CO., LTD
 * SPDX-License-Identifier: LicenseRef-Espressif-Modified-MIT
 *
 * See LICENSE file for details.
 */

#pragma once

#include <stdint.h>
#include "esp_peer.h"

#ifdef __cplusplus
extern "C" {
#endif

/**
 * @brief  Peer default data channel configuration
 */
typedef struct {
    uint16_t  cache_timeout;    /*!< Data channel frame keep timeout (unit ms) default: 5000ms if set to 0 */
    uint32_t  send_cache_size;  /*!< Cache size for outgoing data channel packets (unit Bytes)
                                    default: 100kB if set to 0 */
    uint32_t  recv_cache_size;  /*!< Cache size for incoming data channel packets (unit Bytes)
                                    default: 100kB if set to 0 */
} esp_peer_default_data_ch_cfg_t;

/**
 * @brief  Peer default jitter buffer configuration
 */
typedef struct {
    uint16_t  cache_timeout;     /*!< Maximum timeout to keep the received RTP packet (unit ms) default: 100ms if set to 0 */
    uint16_t  resend_delay;      /*!< Not resend until resend delay reached (unit ms) default: 20ms if set to 0*/
    uint16_t  pli_send_interval; /*!< Send RTCP PLI interval (unit ms), default: 0(disabled) */
    uint32_t  cache_size;        /*!< Cache size for incoming data channel frame (unit Bytes)
                                      For audio jitter buffer default: 100kB if set to 0
                                      For video jitter buffer default: 400kB if set to 0 */
} esp_peer_default_jitter_cfg_t;

/**
 * @brief  Peer default RTP send and receive configuration
 *
 * @note  Insufficient RTP resources can disable features like packet retransmission and loss reporting
 *        Without these features, packet loss may result in audio glitches and mosaic-like video artifacts
 */
typedef struct {
    esp_peer_default_jitter_cfg_t  audio_recv_jitter;  /*!< Audio jitter buffer configuration */
    esp_peer_default_jitter_cfg_t  video_recv_jitter;  /*!< Video jitter buffer configuration */
    uint32_t                       send_pool_size;     /*!< Send pool size for outgoing RTP packets (unit Bytes)
                                                            default: 400kB if set to 0 */
    uint32_t                       send_queue_num;     /*!< Maximum queue number to hold outgoing RTP packet metadata info
                                                            default: 256 */
    uint16_t                       max_resend_count;   /*!< Maximum resend count for one RTP packet
                                                            default: 3 times */
} esp_peer_default_rtp_cfg_t;

/**
 * @brief  Peer default configuration (optional)
 */
typedef struct {
    uint16_t                       agent_recv_timeout;    /*!< ICE agent receive timeout setting (unit ms)
                                                               default: 100ms if set to 0
                                                               Some STUN/TURN server reply message slow increase this value */
    esp_peer_default_data_ch_cfg_t data_ch_cfg;           /*!< Configuration of data channel */
    esp_peer_default_rtp_cfg_t     rtp_cfg;               /*!< Configuration of RTP buffer */
    bool                           keep_role;             /*!< Do not reset role to controlling when disconnected */
    bool                           ipv6_support;          /*!< Support IPv6 */
    bool                           tcp_support;           /*!< Support TCP ICE host candidates and TCP data transport */
    uint8_t                        max_candidates;        /*!< Maximum ICE candidates to gather
                                                                Large setting will consume more heap memory
                                                                Defaults is 16 if set to 0 */
    uint8_t                        max_tcp_connections;   /*!< Maximum TCP connections when TCP support is enabled.
                                                               Defaults to 4 if set to 0 */

    uint8_t                        alive_binding_retries; /*!< Max retries for peer keepalive via STUN Binding requests.
                                                               Sent every 6s; if no response after `alive_binding_retries` attempts,
                                                               peer is marked disconnected.
                                                               Default: 5 (0 = use default, 0xFF = disable check). */
    bool                          ice_use_lite_mode;      /**< Enable ICE Lite mode (simplified ICE for always-on servers) */
    bool                          insecure_skip_turn_cert_verify; /*!< INSECURE: skip TURNS (TURN-over-TLS) server certificate
                                                                       verification. Only enable for lab/testing against a TURN server
                                                                       with a self-signed certificate. On ESP targets this additionally
                                                                       requires CONFIG_ESP_TLS_INSECURE=y and CONFIG_ESP_TLS_SKIP_SERVER_CERT_VERIFY=y in sdkconfig. */
} esp_peer_default_cfg_t;

/**
 * @brief  Get default peer connection implementation
 *
 * @return
 *       - NULL    No default implementation, or not enough memory
 *       - Others  Default implementation
 */
const esp_peer_ops_t *esp_peer_get_default_impl(void);

#ifdef __cplusplus
}
#endif
