wudi-tech/esp32-p4-c5-webrtc-doorbell/solutions/doorbell_local/tests/verify_radar_ld2450.py

"""Build and run the host-side LD2450 protocol parser tests."""

from pathlib import Path
import os
import subprocess
import tempfile


SOLUTION_DIR = Path(__file__).resolve().parents[1]
MAIN_DIR = SOLUTION_DIR / "main"
TEST_DIR = Path(__file__).resolve().parent


def function_region(source: str, start: str, end: str) -> str:
    start_index = source.index(start)
    end_index = source.index(end, start_index)
    return source[start_index:end_index]


def assert_in_order(source: str, *tokens: str) -> None:
    position = -1
    for token in tokens:
        next_position = source.find(token, position + 1)
        assert next_position >= 0, f"webrtc.c is missing concurrency guard {token!r}"
        assert next_position > position
        position = next_position


def main() -> int:
    compiler = os.environ.get("CC", r"D:\mingw64\bin\gcc.exe")
    with tempfile.TemporaryDirectory(prefix="ld2450-test-") as temp_dir:
        executable = Path(temp_dir) / "radar_ld2450_parser_test.exe"
        subprocess.run(
            [
                compiler,
                "-std=c11",
                "-Wall",
                "-Wextra",
                "-Werror",
                f"-I{MAIN_DIR}",
                str(TEST_DIR / "radar_ld2450_parser_test.c"),
                str(MAIN_DIR / "radar_ld2450.c"),
                "-o",
                str(executable),
            ],
            check=True,
        )
        subprocess.run([str(executable)], check=True)

    required_tokens = {
        MAIN_DIR / "radar_ld2450.h": (
            "LD2450_UART_BAUD_RATE 256000",
            "LD2450_UART_RX_GPIO 4",
            "LD2450_UART_TX_GPIO 5",
            "radar_ld2450_init(ld2450_frame_callback_t callback, void *ctx)",
        ),
        MAIN_DIR / "radar_ld2450.c": (
            "uart_read_bytes",
            "ld2450_stream_feed",
            "app_frame_callback(raw_frame, frame, app_frame_callback_ctx)",
            "No valid LD2450 frame for",
        ),
        MAIN_DIR / "CMakeLists.txt": (
            '"radar_ld2450.c"',
            '"presence_fusion.c"',
            '"doorbell_ring_policy.c"',
        ),
        MAIN_DIR / "main.c": (
            '#include "radar_ld2450.h"',
            '#include "presence_fusion.h"',
            "presence_fusion_process",
            'request_sensor_ring("radar")',
            "radar_ld2450_init(radar_frame_received, NULL)",
        ),
        MAIN_DIR / "webrtc.c": (
            "doorbell_request_ring",
            "doorbell_ring_policy_evaluate",
            "DOORBELL_RING_SEND_FAILED",
        ),
    }
    for path, tokens in required_tokens.items():
        text = path.read_text(encoding="utf-8")
        for token in tokens:
            assert token in text, f"{path.name} is missing {token!r}"

    webrtc_source = (MAIN_DIR / "webrtc.c").read_text(encoding="utf-8")
    main_source = (MAIN_DIR / "main.c").read_text(encoding="utf-8")
    common_source = (MAIN_DIR / "common.h").read_text(encoding="utf-8")
    ring_request = function_region(
        webrtc_source,
        "doorbell_ring_request_result_t doorbell_request_ring",
        "static void door_lock_state_changed",
    )
    command_callback = function_region(
        webrtc_source,
        "static int door_bell_on_cmd(",
        "int close_data_channel(",
    )
    regression_failures = []
    if "esp_webrtc_enable_peer_connection" in command_callback:
        regression_failures.append(
            "peer enable/disable still runs inside the door-state callback lock"
        )
    if "door_bell_change_state_locked(DOOR_BELL_STATE_NONE)" in ring_request:
        regression_failures.append(
            "ring send-failure rollback still calls the audio-changing state helper"
        )
    assert not regression_failures, "; ".join(regression_failures)

    peer_worker = function_region(
        webrtc_source,
        "static void peer_connection_change_worker(",
        "static int schedule_peer_connection_change(",
    )
    state_change = function_region(
        webrtc_source,
        "static void door_bell_change_state(",
        "doorbell_ring_request_result_t doorbell_request_ring",
    )
    deny_branch = function_region(
        command_callback,
        "} else if (SAME_STR(cmd, DOOR_BELL_CALL_DENIED_CMD))",
        "} else if (SAME_STR(cmd, DOOR_BELL_ENABLE_RTP_TRANSFORMER))",
    )
    accept_branch = function_region(
        command_callback,
        "} else if (SAME_STR(cmd, DOOR_BELL_CALL_ACCEPTED_CMD))",
        "} else if (SAME_STR(cmd, DOOR_BELL_CALL_DENIED_CMD))",
    )
    async_state_failures = []
    if not (
        "door_bell_state == DOOR_BELL_STATE_DISCONNECTING" in state_change
        and "state == DOOR_BELL_STATE_CONNECTED" in state_change
    ):
        async_state_failures.append(
            "CONNECTED callback can overwrite the pending DISCONNECTING reservation"
        )
    if not (
        "door_bell_state_t state_before_disconnect = door_bell_state;"
        in deny_branch
        and "restore_peer_change_state_locked(" in deny_branch
    ):
        async_state_failures.append(
            "DENY scheduling failure does not restore the prior busy state"
        )
    rollback_helper = function_region(
        webrtc_source,
        "static void restore_peer_change_state_locked(",
        "static void peer_connection_change_worker(",
    ) if "static void restore_peer_change_state_locked(" in webrtc_source else ""
    if not (
        "previous_state == DOOR_BELL_STATE_RINGING" in rollback_helper
        and "play_tone(DOOR_BELL_TONE_RING)" in rollback_helper
        and "restore_peer_change_state_locked(" in peer_worker
        and "restore_peer_change_state_locked(" in accept_branch
        and "restore_peer_change_state_locked(" in deny_branch
    ):
        async_state_failures.append(
            "failed ACCEPT/DENY does not restore both RINGING state and ringtone"
        )
    if not all(
        token in accept_branch
        for token in (
            "door_bell_state != DOOR_BELL_STATE_NONE",
            "door_bell_state != DOOR_BELL_STATE_RINGING",
        )
    ):
        async_state_failures.append(
            "ACCEPT does not allow idle direct-call and active-ring entry states"
        )
    if not all(
        token in deny_branch
        for token in (
            "door_bell_state != DOOR_BELL_STATE_RINGING",
            "door_bell_state != DOOR_BELL_STATE_CONNECTING",
            "door_bell_state != DOOR_BELL_STATE_CONNECTED",
        )
    ):
        async_state_failures.append(
            "DENY does not reject NONE, DISCONNECTING, and other stale states"
        )
    review_failures = async_state_failures
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
